CalPlug/SparkyStrip/documents/senior design/ems/Slides/average app rating.key/Data/st2.jpg

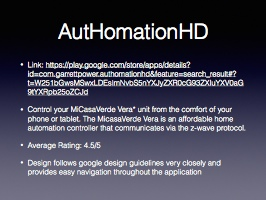
documents/senior design/ems/Slides/average app rating.key/Data/st2.jpg
