CalPlug/SparkyStrip/README.md

# SparkyStrip
**************************************
This is an EECS senior design for Electrical Engineering and Computer Science depatment at UC Irvine for 2015

Coding Development by: Jeffrey Thompson, Andrew Picard, David Pynes, and Edmund Loo

Managed by: Linyi Xia and Prof. G.P. Li

California Plug Load Research Center (CalPlug), California Institute of Telecommunications and Information Technology (Calit2), University of California, Irvine extending from a project in collaboration with The University of California, Davis.

Copyright (c) Regents of the University of California, 2015
