CalPlug/SparkyStrip/documents/pcb/PCB System Design.pptx

## PCB System Level Functional Design

Linyi Xia 7/10/2014

## Slide 2

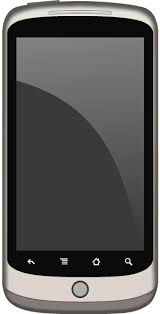
[picture p14: figure]
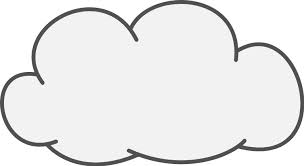
[picture p15: figure]

Cloud/Server/Gateway

PCB (Load Monitoring System)

## Slide 3

PCB (Load Monitoring System)
Measure (Micro and Macro transient response)
Communication with the cloud/server/gateway
Device ID
Load Signature Library Storing
Device matching
Characterizing Device Load Signature
ZigBee communication
WiFi and/or
Vrms
Irms
Power
Power factor
