CalPlug/SparkyStrip/documents/senior design/ems/load_sig/SURF PPT - Final.pptx

## Plug Load Signature Study for Home Energy Management

Kelvin Liang, Young Min Kim,
Johnny Nguyen
Advisor: Prof. G.P. Li, Dr. Arthur Zhang

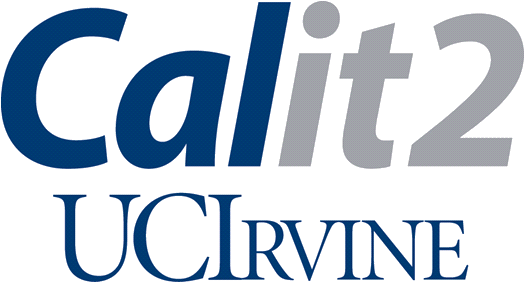
[picture p30: figure]

## What is an EMS?

- Central hub for monitoring plug load devices used in the house.
- Monitoring
  - Power Consumption
  - Cost
  - User behavior
- Opportunities for energy management
  - Two way communication

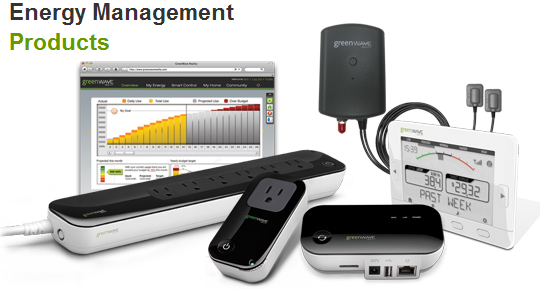
[picture p31: figure]

## Smarter Technology

- Current systems
  - Module for each plug load device
  - 100% User Interaction
- Load Signature allows for:
  - Automatic Identification
  - Using existing infrastructure (electrical panel, switch boxes, outlets)

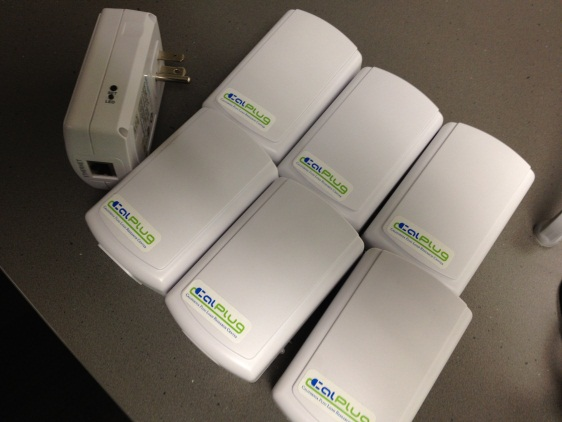
[picture p32: figure]

## Load Signatures

- Current Waveform
- Active & Reactive Power
- Harmonics
- Operating Behaviors

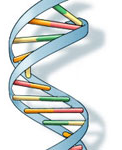
[picture p33: figure]

## Current Waveform

Signature I: Current Rise-Up Time

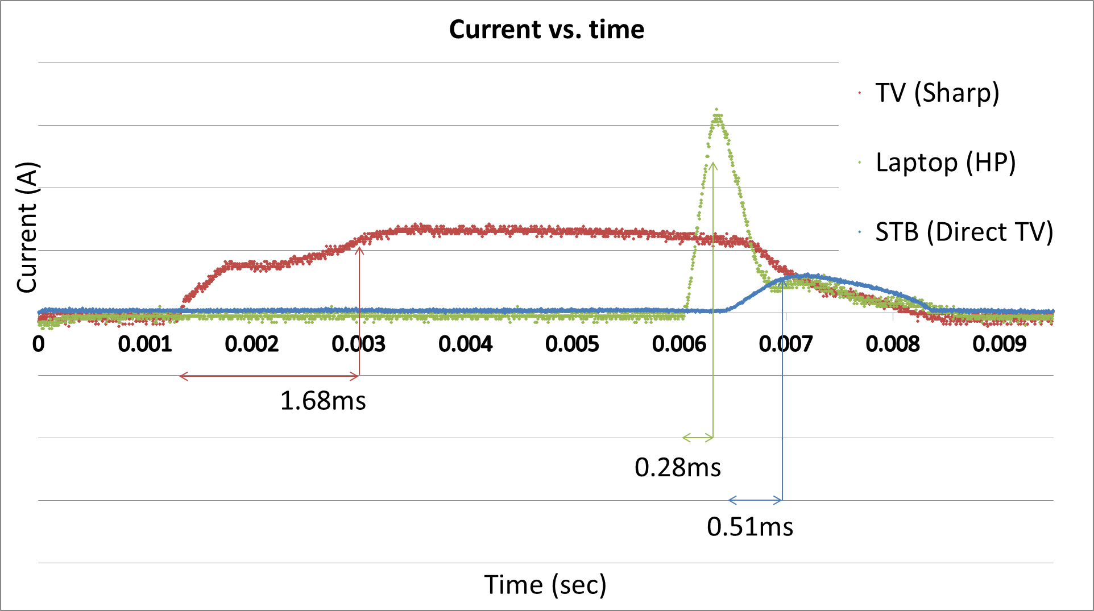
[picture p34: figure]
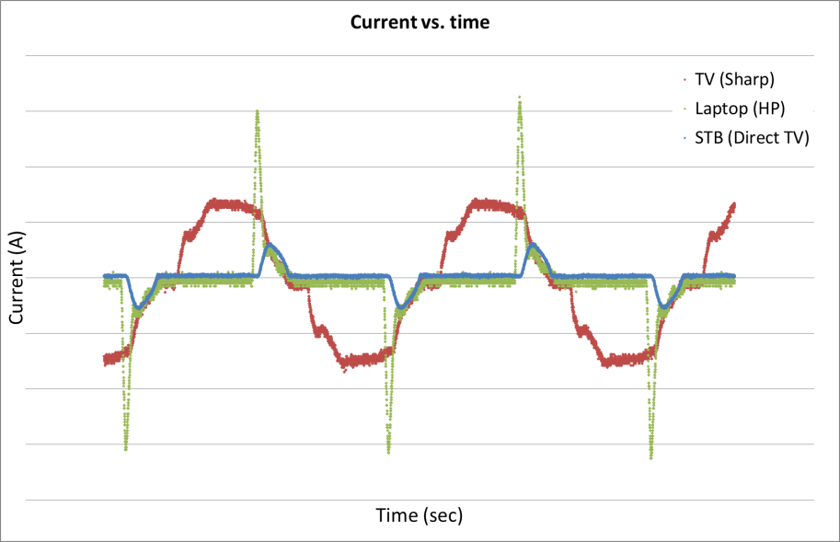
[picture p35: figure]

## Signature II: Harmonics

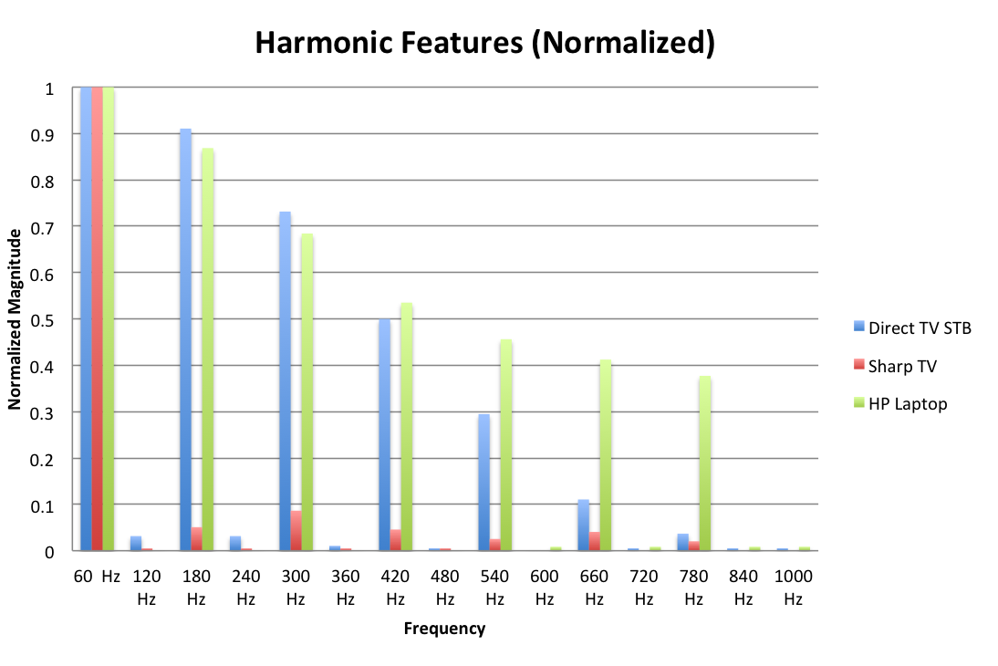
[picture p36: figure]
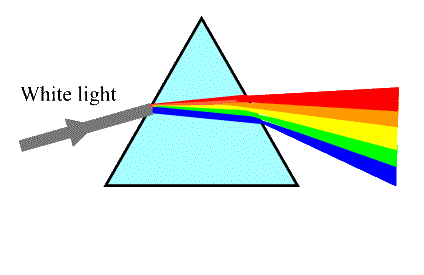
[picture p37: figure]

Prism Analogy

## Signature III: Active & Reactive Power

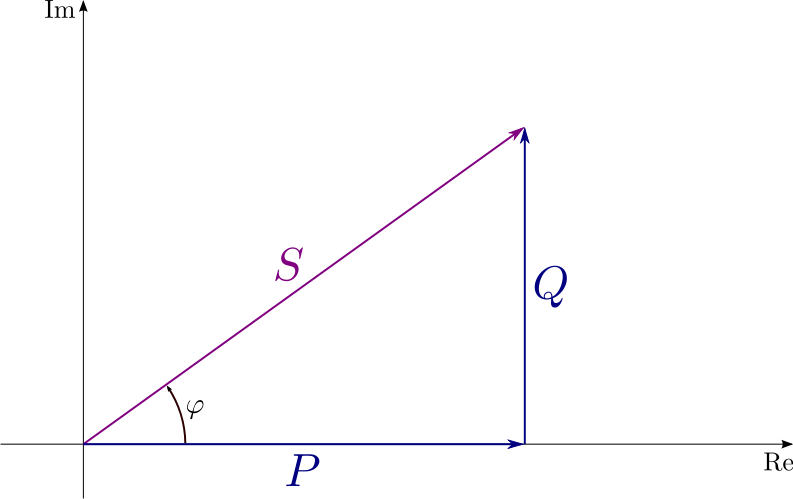
[picture p38: figure]
File:Cmplxpower.svg

Real power (P)
Reactive power (Q)
Complex power (S)
Phase of Current (φ)

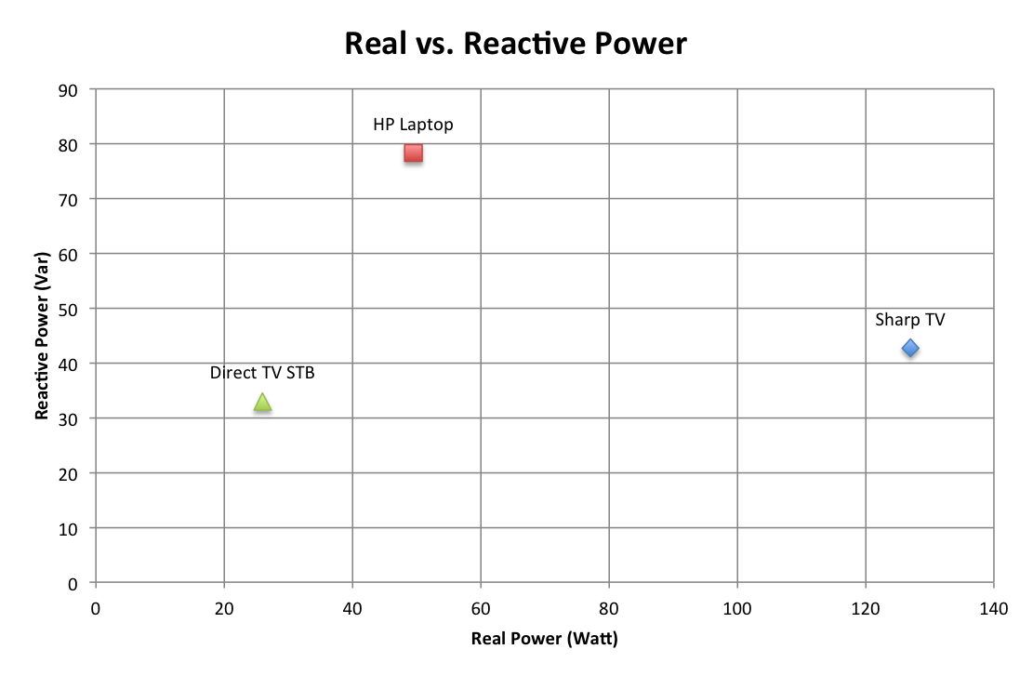
[picture p39: figure]

## Current Algorithm Design

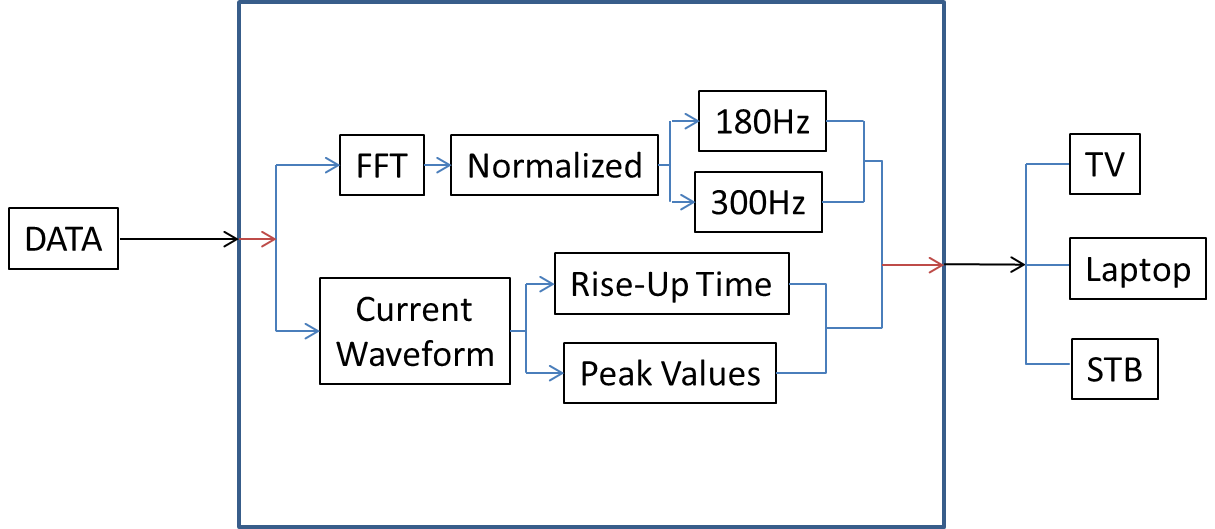
[picture p40: figure]

?

## System Integration

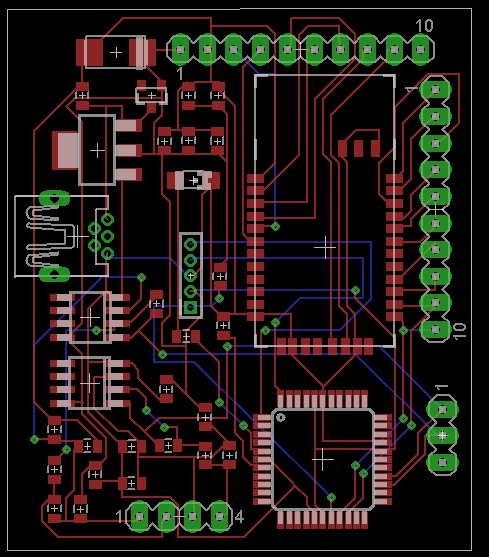
[picture p41: figure]
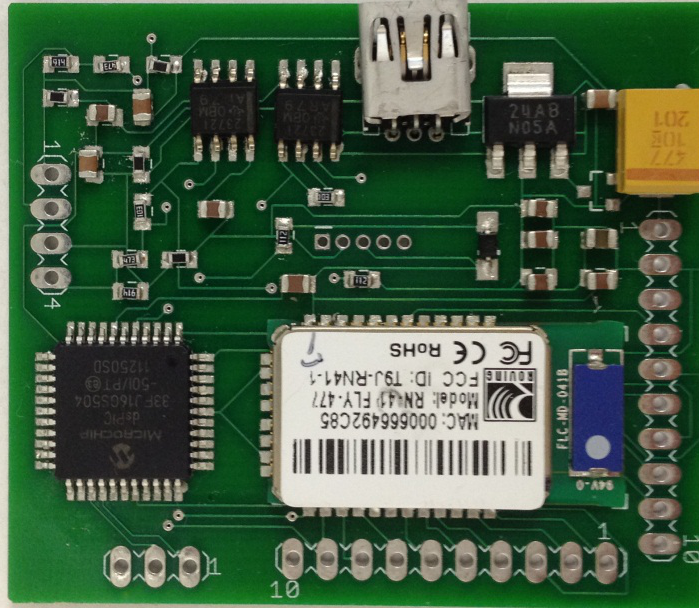
[picture p42: figure]
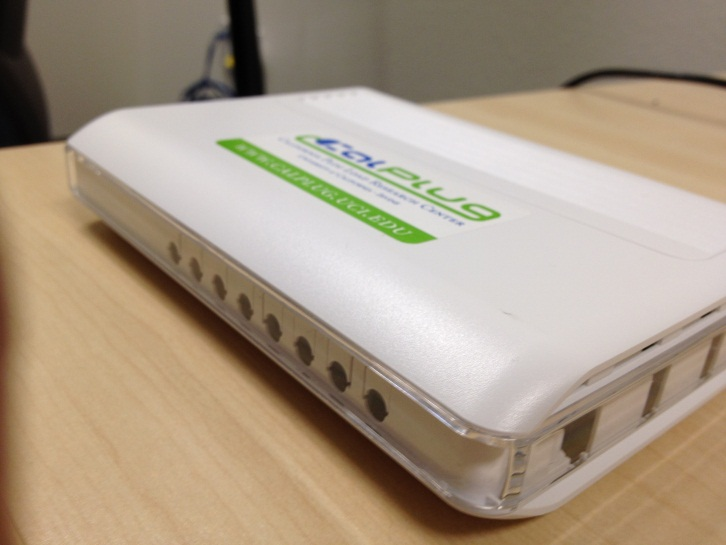
[picture p43: figure]

## Slide 10

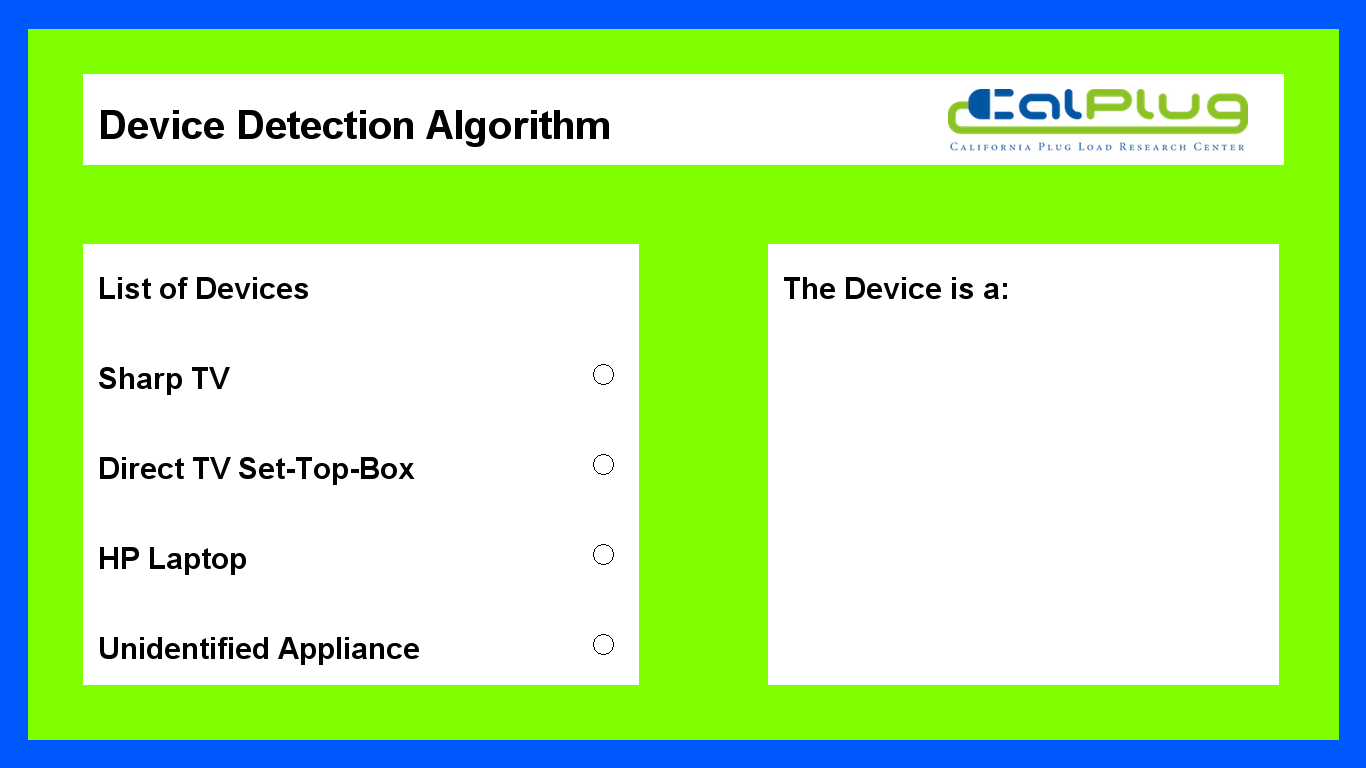
[picture p44: figure]
