CalPlug/SparkyStrip/documents/senior design/ems/Slides/Copy of Kelvin IHEI 12.30.13  Meeting.pptx

## GreenWave Reality Solutions

**Concept video Dated April 2011

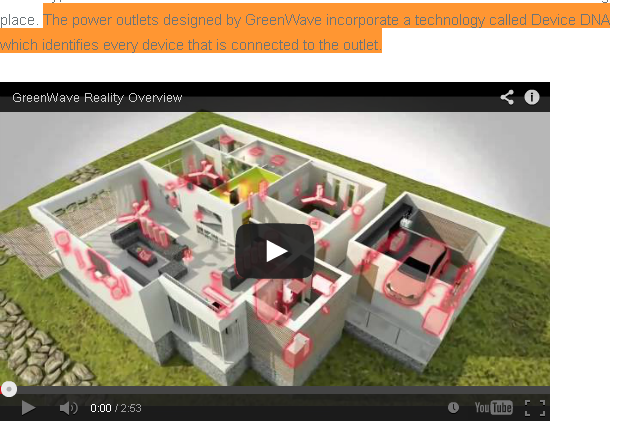
[picture p49: figure]

## Competitor Product

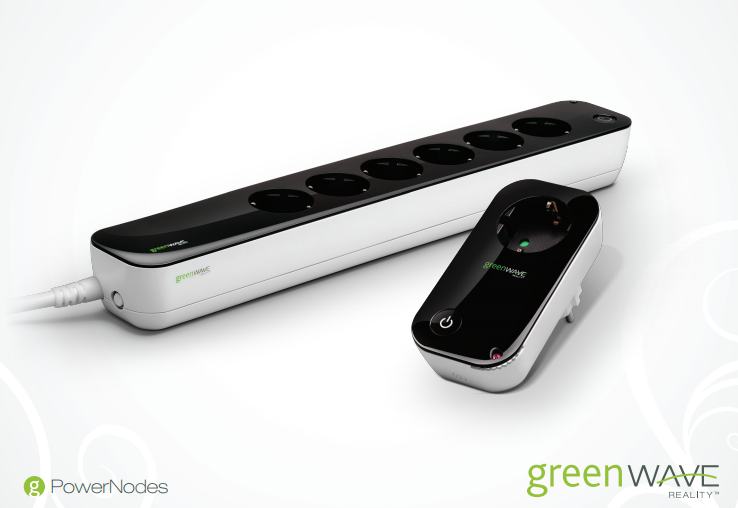
[picture p50: figure]

## Slide 3

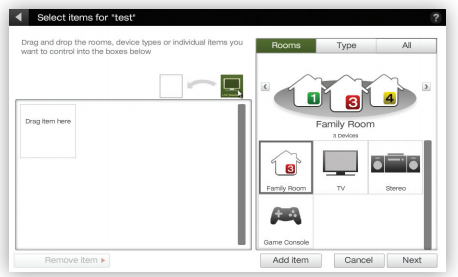
[picture p51: figure]

## GreenWave Selling Points

-Room Colors
Manual dials for assigning devices to a room
-Scheduling
-Energy Consumption
-LED Bulbs w/ NXP chip to drive intensity, relay
-Home Monitoring
-No Mention of “Device DNA”

## Whats Next

- Proceed with waveform recognition add on to ems
  - no clear competitor with this technology
- Arrival of PO?
  - Begin ASAP to meet deadlines

## Links

http://walyou.com/greenwave-energy-monitor/
http://greenwavereality.com/downloads/pdfs/PowerNode_manual_english.pdf
http://greenwavereality.com/downloads/pdfs/energy_portal_guide.pdf
http://greenwavereality.com/downloads/pdfs/KitInstallationGuideEnglish.pdf
http://greenwavereality.com/downloads/pdfs/gateway_manual_english.pdf
