CalPlug/SparkyStrip/documents/senior design/ems/Slides/Patents_cont.pptx

## Intelli-Home Electronics Interpreter (IHEI)

Young Min Kim
29 Dec. 2013

## Slide 2

- Common Load Recognition Features
  - Power
    - Real [Watt], Complex [VA]
    - Reactive [VAR], Apparent [|VA|]
    - Power factor [Real/Apparent]
  - Current, Voltage
    - Frequency, Period, Phase
    - RMS (root mean squared)
    - Harmonics, FFT

## Notable Patent Features

- Sony Corporation (2011) [1]
  - Measures electrical characteristics at the outlet
  - Compares the measured electrical characteristics to the stored characteristic of candidate device (database)
  - Unique electrical characteristics information stored in the database are
    - input reflection coefficient
    - line cycle frequency

## Notable Patent Features (cont.)

- Geneva Cleantech Inc. (2011) [2]
  - Automatic detection of appliances/devices
  - Methods/algorithms for identification disclosed
  - Unique features collected by monitoring devices coupled to a power supply:
    - Energy (active, reactive)
    - Total Harmonic Distortion (ratio of the sum of all harmonic components to the power of fundamental frequency)

## Notable Patent Features (cont.)

- Telecom Italia, S.P.A (2013) [3]
  - Home automation through automatic identification of device/appliance (*same focus)
  - Using cross-correlation method between the monitored electrical characteristic and a reference pattern of a possible candidate
  - Ex. If the calculated correlation between the monitored device and predicted reference is close to 0, then no relationship.

## Patent Links

- [1]http (http://www.google.com/patents/US20110196634):// (http://www.google.com/patents/US20110196634)www.google.com/patents/US20110196634
- [2]http (http://www.google.com/patents/WO2011091444A1?cl=en):// (http://www.google.com/patents/WO2011091444A1?cl=en)www.google.com/patents/WO2011091444A1?cl=en
- [3] http://www.google.com/patents/US20130132008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
