CalPlug/SparkyStrip/documents/senior design/load_sig/presentation/SURF UPDATE PPT.pptx

## Load Signature Study for Home Energy Management

Young Min Kim, Kelvin Liang
Advisor: Prof. G.P. Li, Dr. Arthur Zhang

## What is an EMS?

- Central hub for monitoring plug load devices used in the house.
- Monitoring
  - Power Consumption
  - Cost
  - User behavior
- Opportunities for energy management
  - On/Off relay control

## Smarter Technology

- Current systems
  - Modules for every plug load device
  - 100% User Interaction
- Load Signature allows for:
  - Automatic Identification
  - Using existing infrastructure (electrical panel)

## Load Signatures

- Current Waveform
- Active & Reactive Power
- Harmonics
- Operating Behaviors
- Instantaneous Power Waveform
- Instantaneous Admittance Waveform

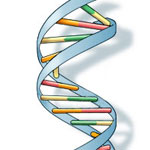
[picture p65: figure]

## Current Waveform


## Current Rise-Up Time


## Active & Reactive Power


## Harmonics


## Current Algorithm Design

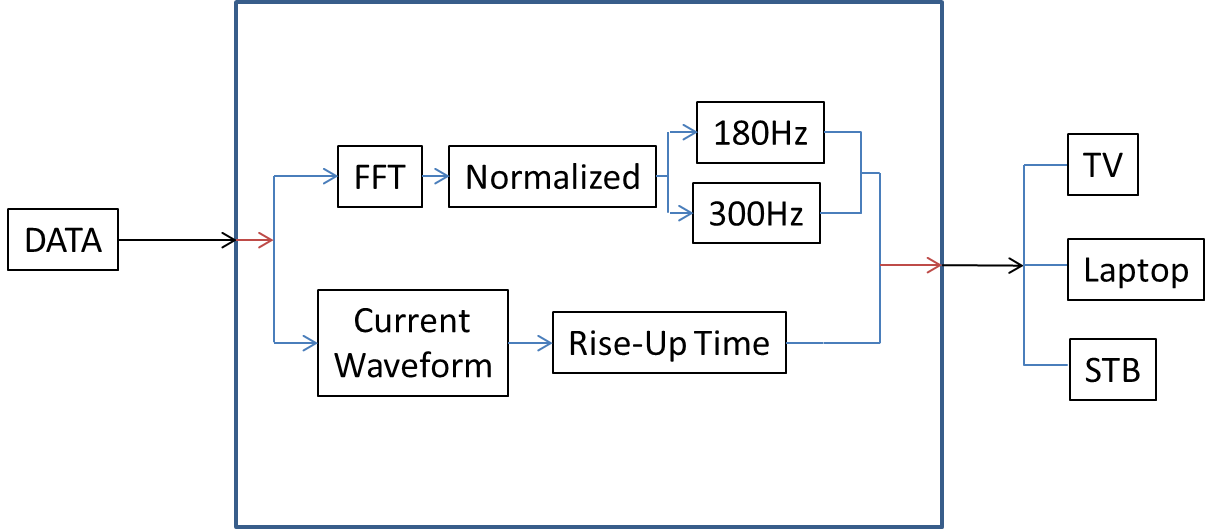
[picture p66: figure]

## Slide 10


## System Integration

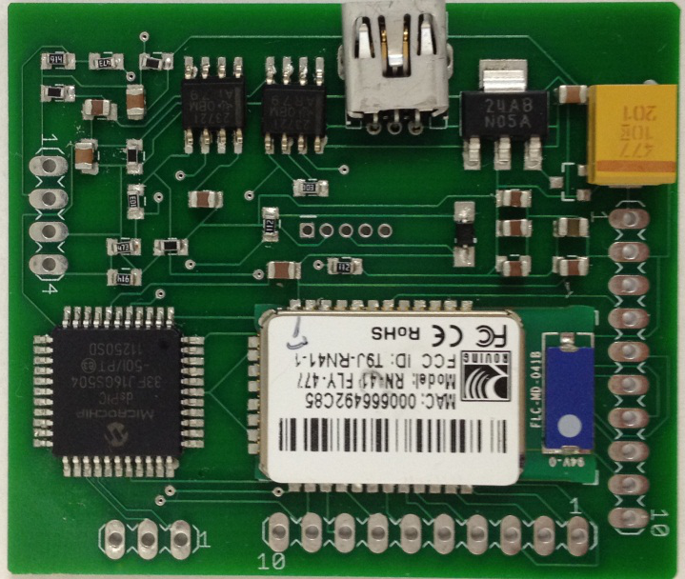
[picture p67: figure]
