CalPlug/SparkyStrip/documents/senior design/ems/load_sig/presentation/5.30.12 Presentation.odp

## CalPlug EMS

Shivam Patel

Progress Update

5/30/12

## Current Tasks

- Collecting waveforms for various loads
- Analyzing FFT and its uses
- Learning LabVIEW

## Current Probe Calibration

- Calibrated two new current probes

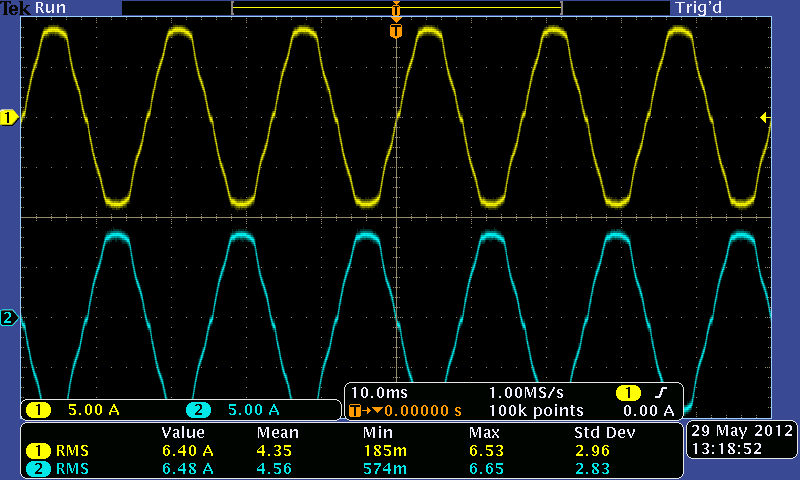
[picture p68: figure]

## FFT Page 1

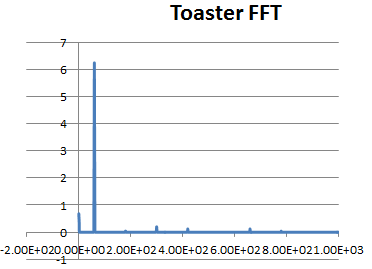
[picture p69: figure]
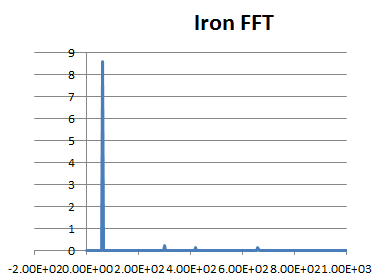
[picture p70: figure]

## FFT Page 2

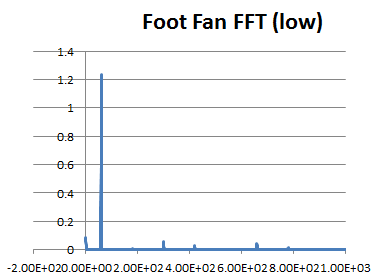
[picture p71: figure]
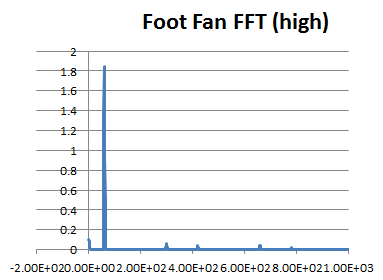
[picture p72: figure]

## What's Next

- Using LabVIEW to get full waveform over period of time
  - Want to analyze outside of instantaneous frame
  - Different modes for devices
