CalPlug/SparkyStrip/documents/senior design/ems/load_sig/presentation/6.13.12 Presentation.odp

## CalPlug EMS

Shivam Patel

Progress Update

6/13/12

## Current Tasks

- Inspect current probe
- Learn Lab View

## Current Probe Inspection

- Chip is only about 4 square inches

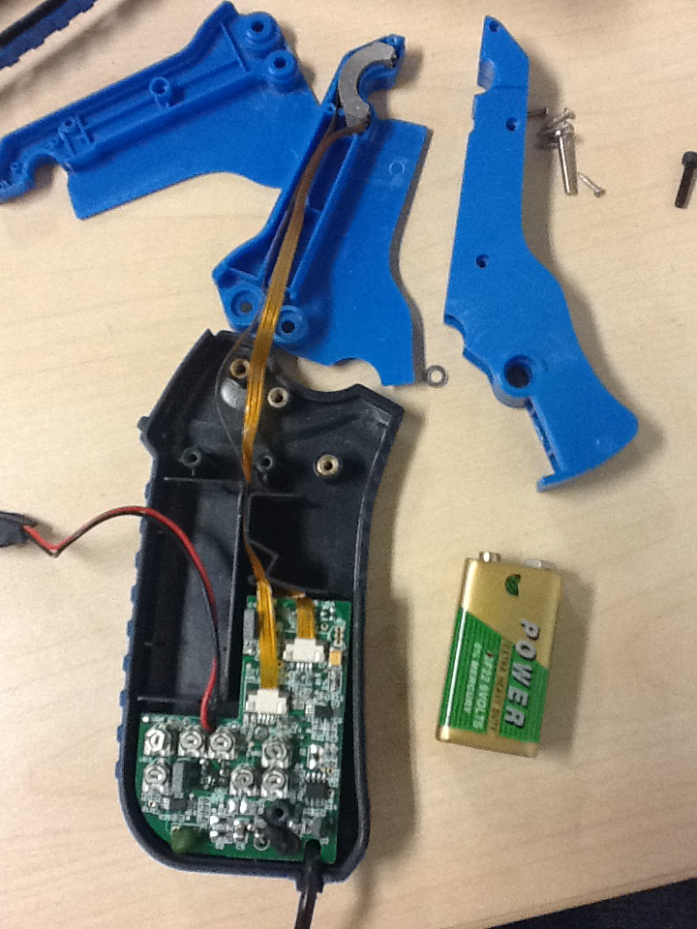
[picture p73: figure]

## Quarter Review

- Learned functions of current probes
- Practice with giving presentations and with soldering
- Contributed in some ares of the overall project
