CalPlug/SparkyStrip/documents/senior design/load_sig/presentation/10-26-2012/Camilo Presentation 1.pptx

## Presentation

Camilo Aguilar

## Eagle

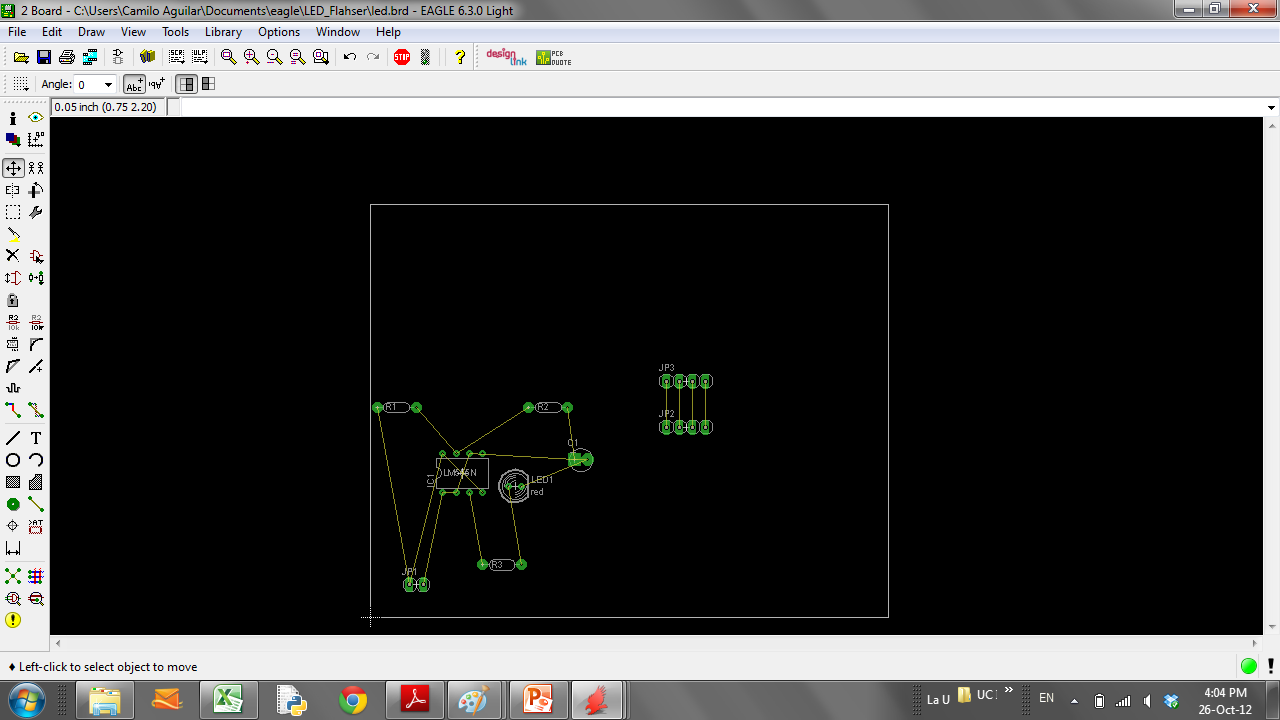
[picture p79: figure]

## Slide 3

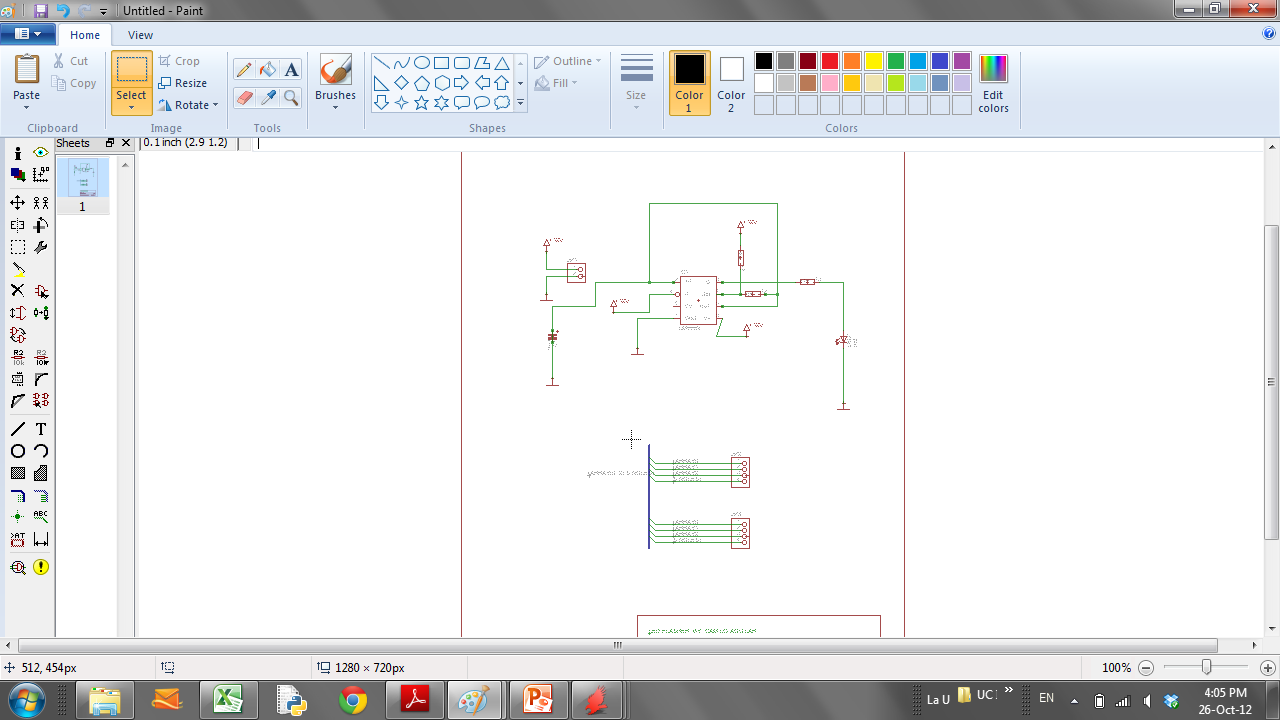
[picture p80: figure]

## Slide 4

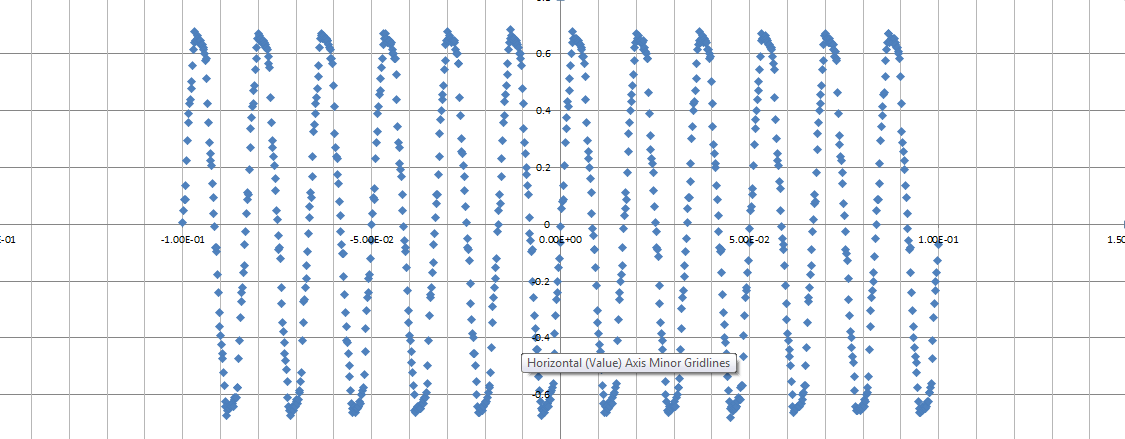
[picture p81: figure]
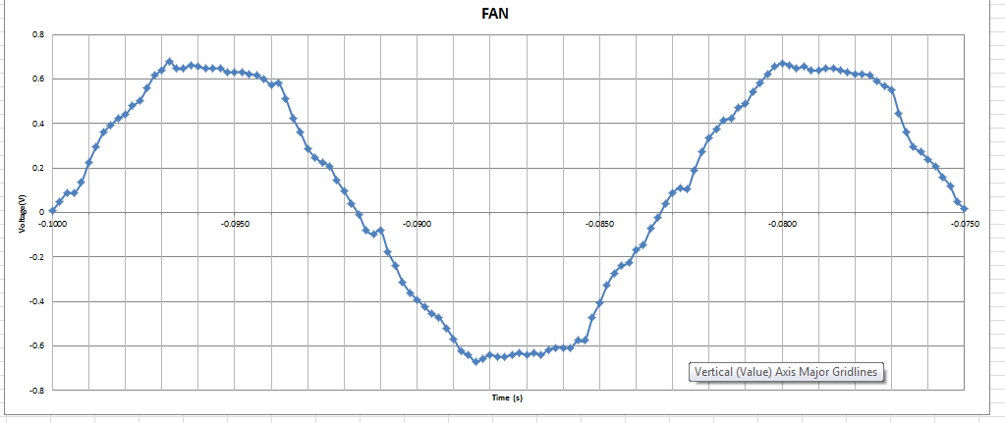
[picture p82: figure]

## Slide 5

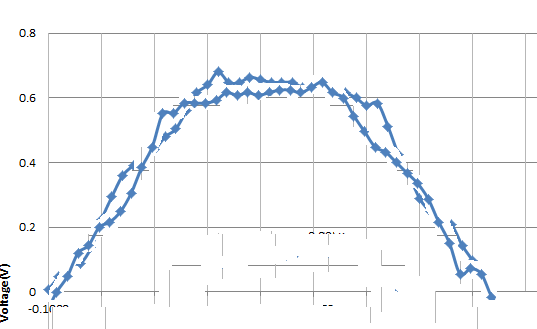
[picture p83: figure]

## Goals

- Better Understanding of Fourier Decomposition
- Help developing the code in C
- Work and get familiarized with eagle CAD
