CalPlug/SparkyStrip/documents/senior design/load_sig/presentation/12-07-2012/Johnny Nguyen 12-07-2012.pptx

## EMS Team Meeting


Johnny Nguyen
Binjue Wu
Camilo Aguilar
Mohsin Farooqui
Andrew Wang

December 7, 2012

## Milestones

- Able to recognize both individual devices, stored in database, and multiple, same devices (ie if there are two footfans fans, identifies there are two fans).
- Used Zigbee board to convert input using the ADC, and compute different load signature characteristics using buffers.

## Hardware/Zigbee CC2530

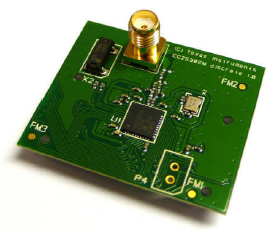
[picture p88: figure]

Johnny Nguyen
Camilo Aguilar
Christian Goldau

## Progress-What we learned

- Documentation for board difficult
- Invaluable microcontroller experience for Camilo and I
- Using different libraries of controller and C
- Learned limitations of controller vs computer C code

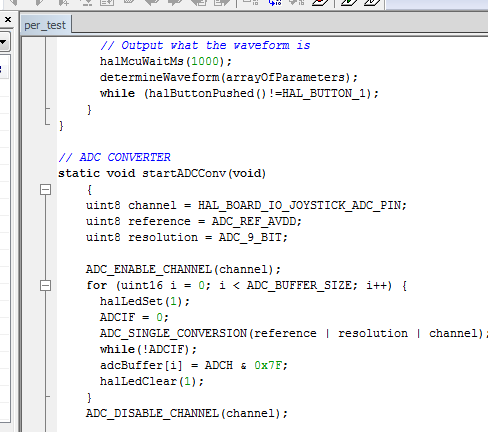
[picture p89: figure]

## Progress-Results

- ADC-Converter-Input
- Distinguish devices at microcontroller level.
- Demo

## Upcoming tasks

- Hardware to replace current probe
- Better Resolution in ADC
- Prepare design for Charles

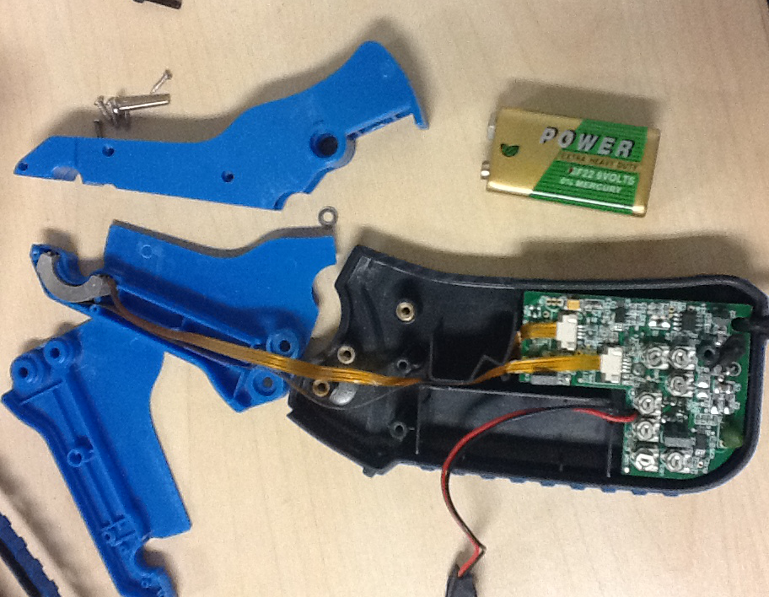
[picture p90: figure]
