CalPlug/SparkyStrip/documents/senior design/load_sig/presentation/2-15-2013/Different Phases of a Sine Wave.docx

Sin wave, frequency 60 Hz.

Phase Shift = 0

WaveForm:

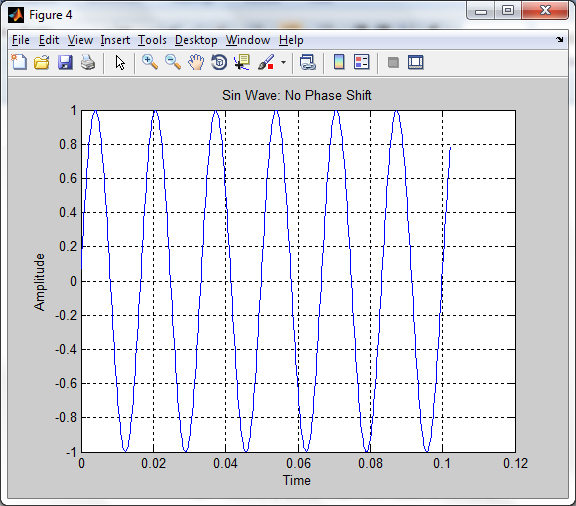
[picture p91: figure]

Normalized FFT

\

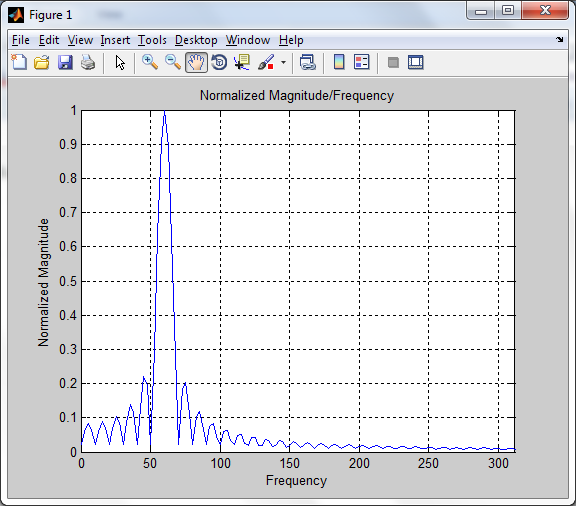
[picture p92: figure]

Real Frequency

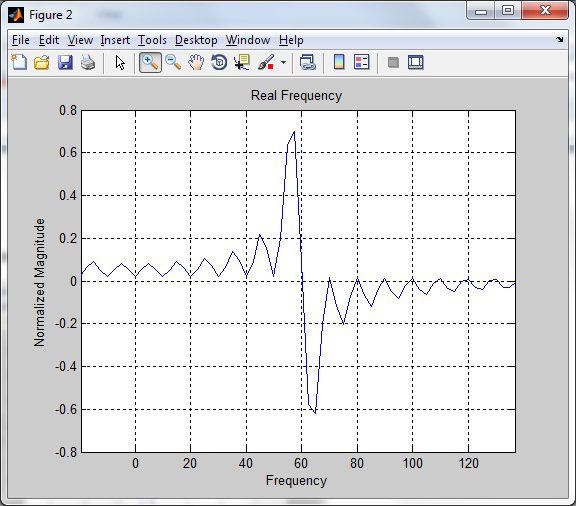
[picture p93: figure]

Imaginary

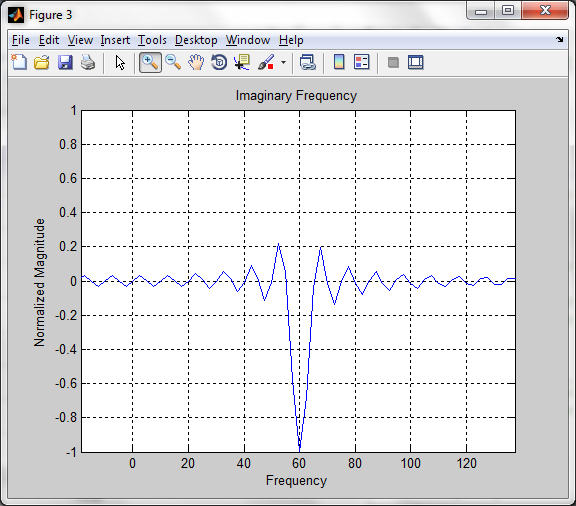
[picture p94: figure]

Sin wave, frequency 60 Hz.

Phase Shift = 180

Waveform

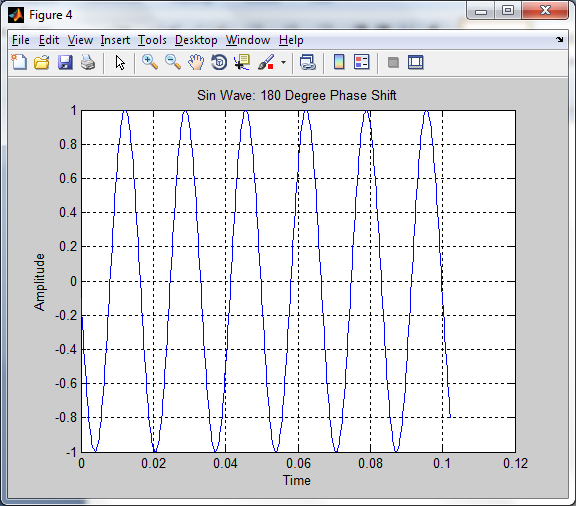
[picture p95: figure]

Normalized FFT

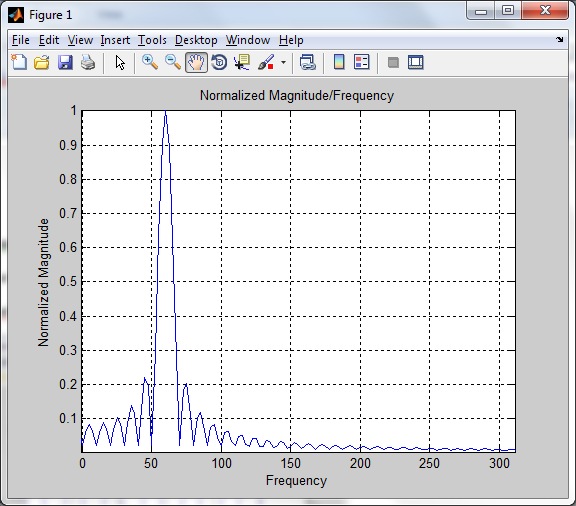
[picture p96: figure]

Real FFT

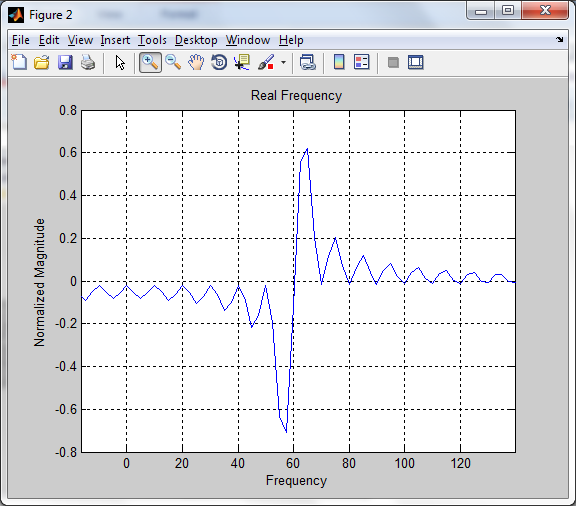
[picture p97: figure]

Imaginary FFT

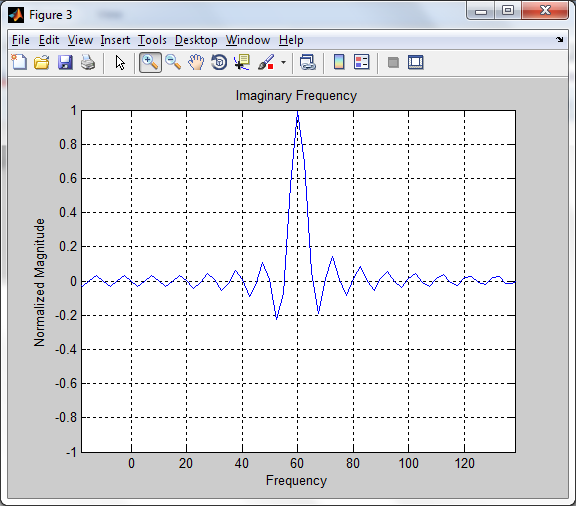
[picture p98: figure]

Sin wave, frequency 60 Hz.

Phase Shift = 90

Waveform

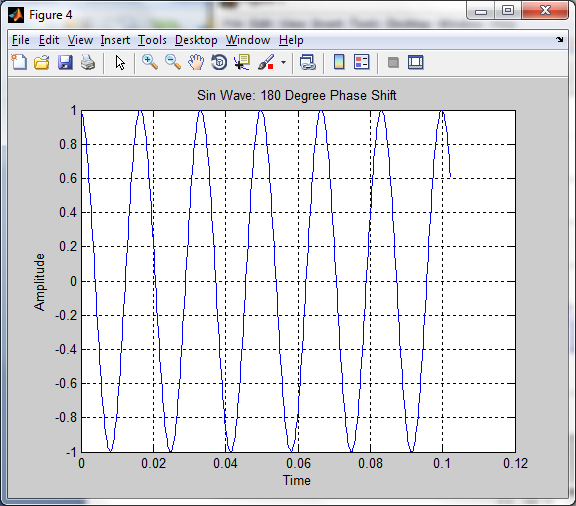
[picture p99: figure]

Normalized Frequency

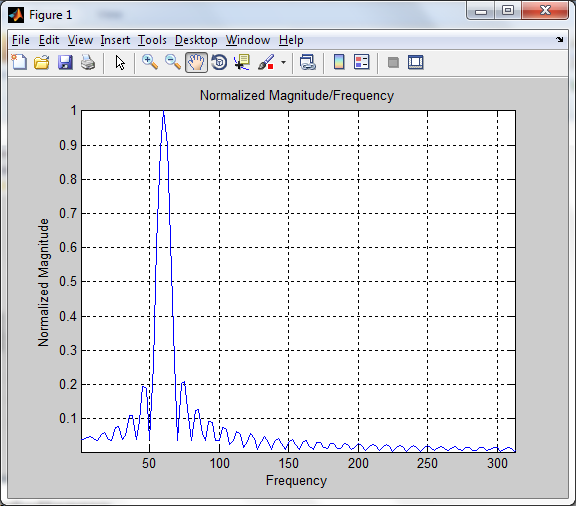
[picture p100: figure]

Real FFT

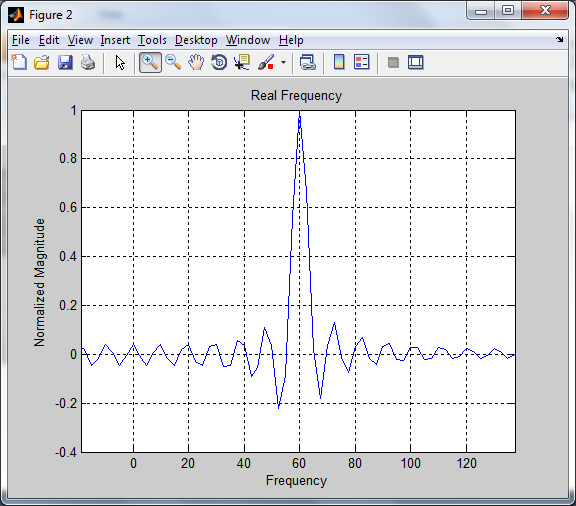
[picture p101: figure]

Imaginary FFT

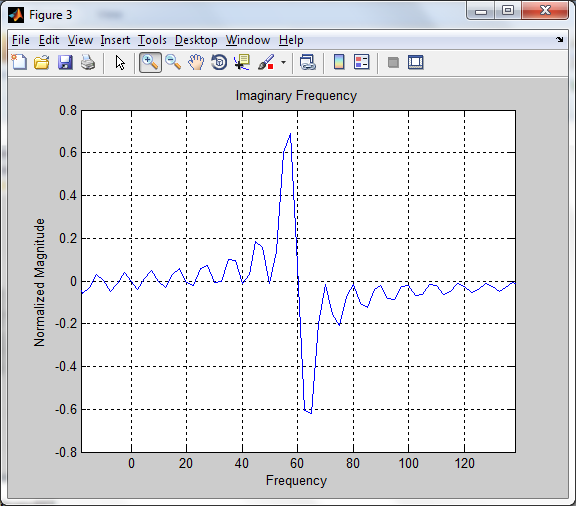
[picture p102: figure]

Sin wave, frequency 60 Hz.

Phase Shift = 270

Waveform

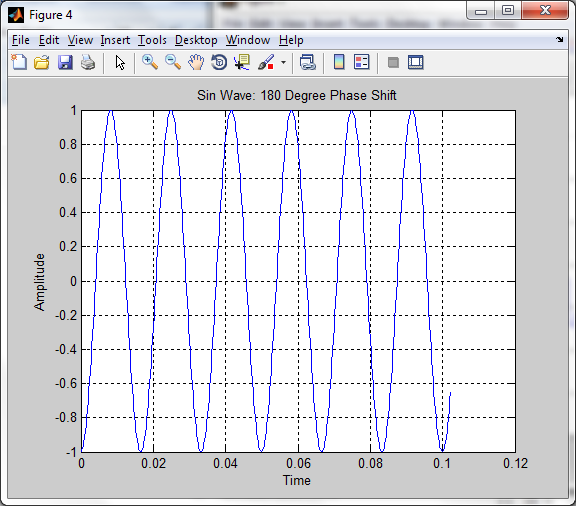
[picture p103: figure]

Normalized FFT

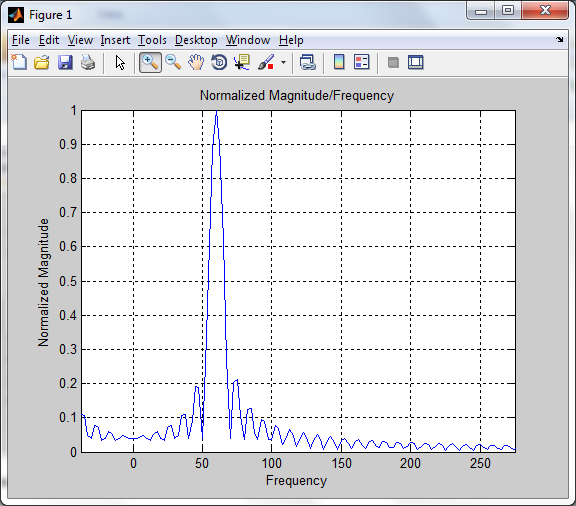
[picture p104: figure]

Real FFT

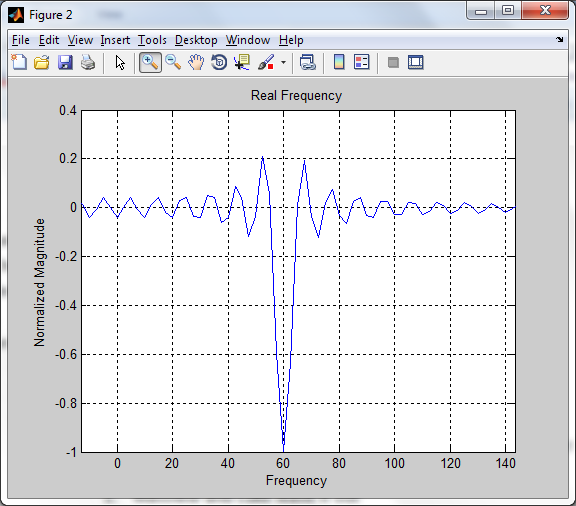
[picture p105: figure]

Imaginary FFT

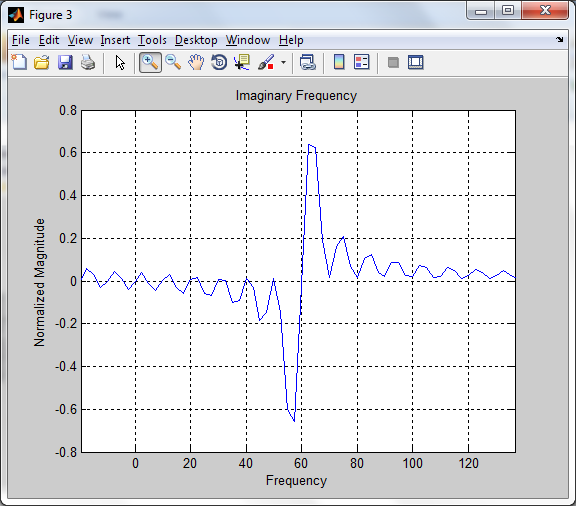
[picture p106: figure]

Why?

Fourier Transform:

When we shift, Normalized values are the same ( √(Re{S(F)}^2+ Im{S(F)}^2) )

However, Real and Imaginary Components are different!!

When we shift by 90, we multiply S(F) by ‘j’

s(t + π/2) = j*S(F)

When we shift by 180, we multiply S(F) by ‘-1’

s(t + π) = -1*S(F)

When we shift by 270, we multiply S(F) by ‘-j’

s(t + 3π/2) = -j*S(F)

Our data is consistent when we shift our values by 360 degrees

Excel File

However, our phase sometimes changed “signs”. This is due to the fact that sometimes, the real or imaginary component of FFT is close to 0, and fluctuated signs. We find that Real and Imaginary FFT is more reliable.

Thus, when we find phase, it is important when we record the waveform, to always start on the same starting point. In our case, we wish to always start recording at the local maximums

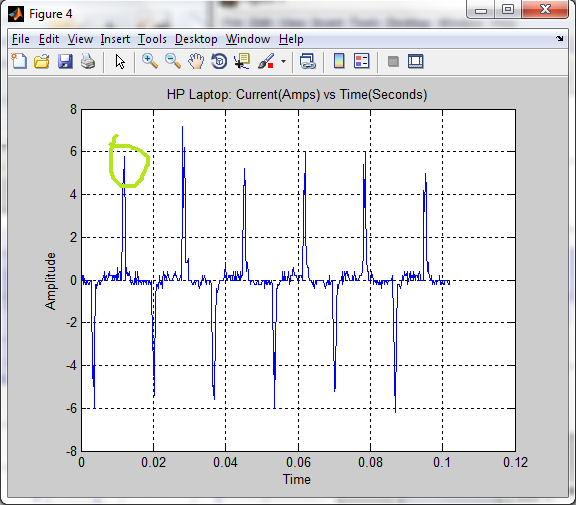
[picture p107: figure]
