CalPlug/SparkyStrip/documents/senior design/load_sig/presentation/2-15-2013/EMS Team Meeting Progress Report.pptx

## EMS Team Meeting


Johnny Nguyen
Camilo Aguilar
Christian Goldau
Andrew Wang

February 15, 2013

## Milestones-Last Quarter

- Able to recognize both individual devices, stored in database, and multiple, same devices (ie if there are two footfans fans, identifies there are two fans).
- Used ADC, and compute different load signature characteristics on board

## Real-Time Display

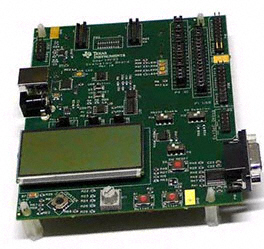
[picture p108: figure]
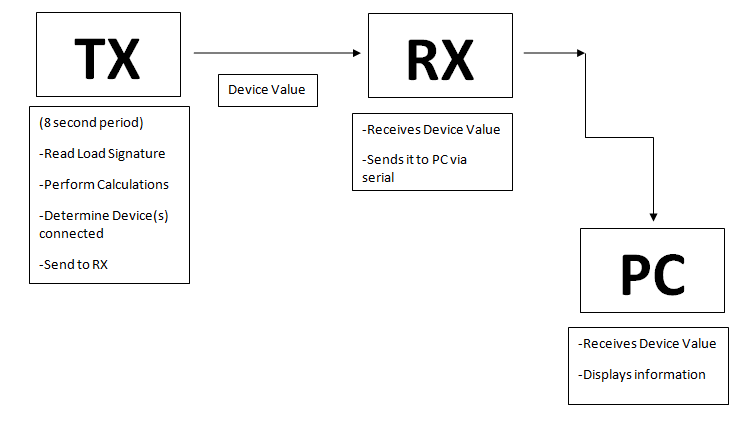
[picture p109: figure]
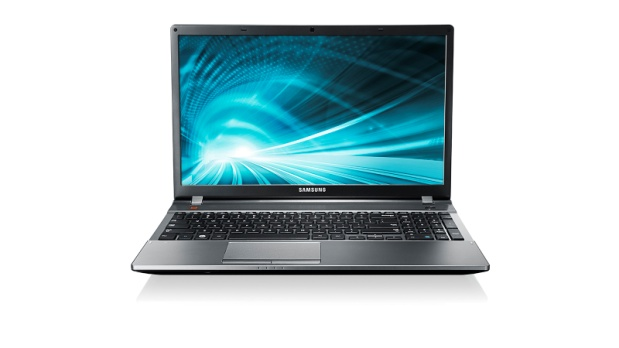
[picture p110: figure]

## Load-Signature Algorithm: Real and Imaginary Frequency Harmonics

- Problem: two sine waves, one with 180 degree shift, yielded different Phase, Real and Imaginary FFT
No Phase Shift 180 Degree Shift


## Slide 5

- Problem Solved: Read waveform, store it into buffer, and set starting point to maximum at first period
- Calculations consistent
  - However, sometimes phase was opposite signs
  - Thus we will use Real and Imaginary
