CalPlug/SparkyStrip/documents/senior design/load_sig/presentation/4-16-2013/EMS Team Meeting Progress Report 4-16-13.pptx

## EMS Team Meeting


Johnny Nguyen
Camilo Aguilar
Christian Goldau
Charles Lam

April 16, 2013

## Milestones-Last Quarter

- Real time, wireless display.
  - Able to display 2 meters (but with interference problems).
- Improving the code
  - More devices, more waveform features
- Practiced Demo/Presentation Skills

## Current Progress/Problems

- Trouble with wireless
  - Demo/Demo code not working
- Currently 11 waveform features in code
  - To be used in Chris’s code and microcontrollers

## Future Tasks

- Continue to debug demo code
- Multiple meter wireless network
- Assist/Train up new members
