CalPlug/SparkyStrip/documents/senior design/load_sig/presentation/6-03-2013/Active and Reactive Power.pptx

## Active and Reactive Power

Load

## Voltage Current

Load

## Current Voltage Meassurements

- Real Power Consumption (WATTS)
- Reactive Power (VAR)
  - Phase Shift
    - Capacitor/Resistive/Inductive Circuit
    - Phase add linearly

## Slide 4

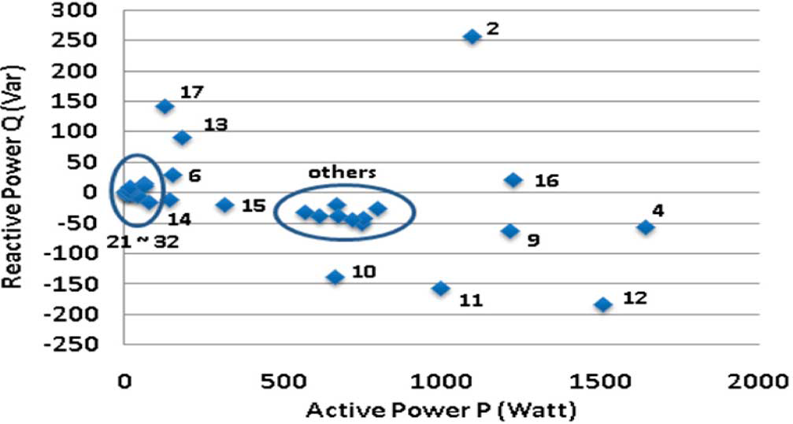
[picture p111: figure]
