CalPlug/SparkyStrip/documents/senior design/load_sig/presentation/6-03-2013/EMS Team Meeting Progress Report 6-3-13.pptx

## EMS Team Meeting


Johnny Nguyen
Camilo Aguilar
Upa Sundaram
Charles Lam

June 3, 2013

## Problem: Recognizing Similar types of Devices

- Waveforms of laptops in steady state similar:
  - Becomes even more complicated with different power consumption modes, whether or not the laptop is fully charged, etc.

## Slide 3

Dell Laptop

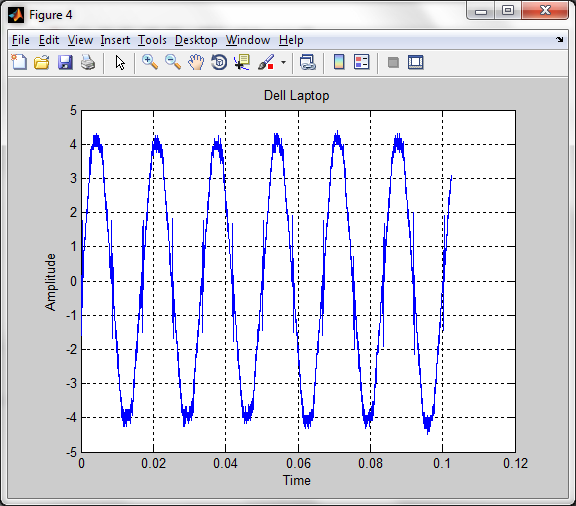
[picture p112: figure]

Lenovo

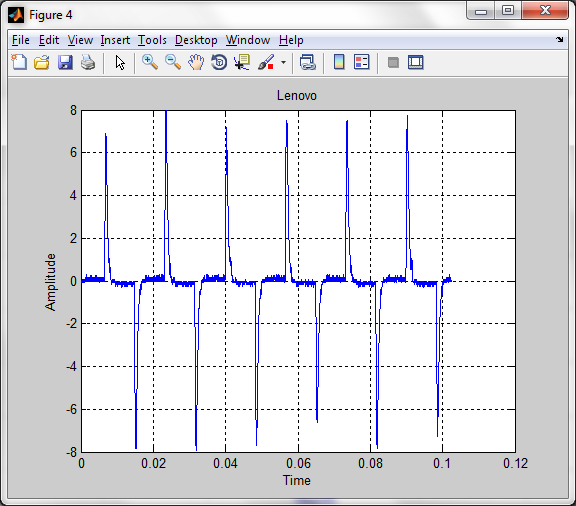
[picture p113: figure]

HP Probook 4530s

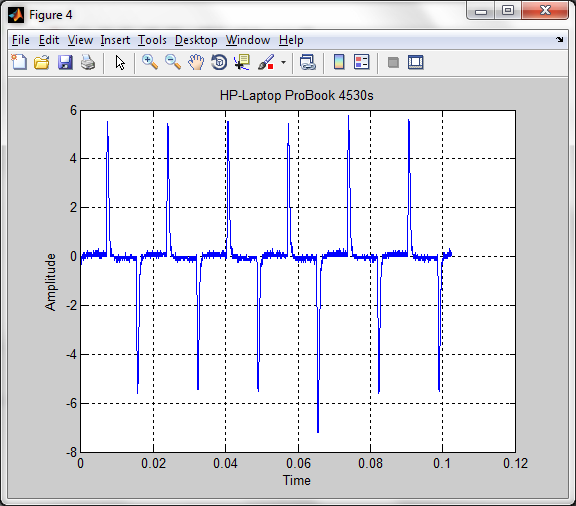
[picture p114: figure]

Dell PC

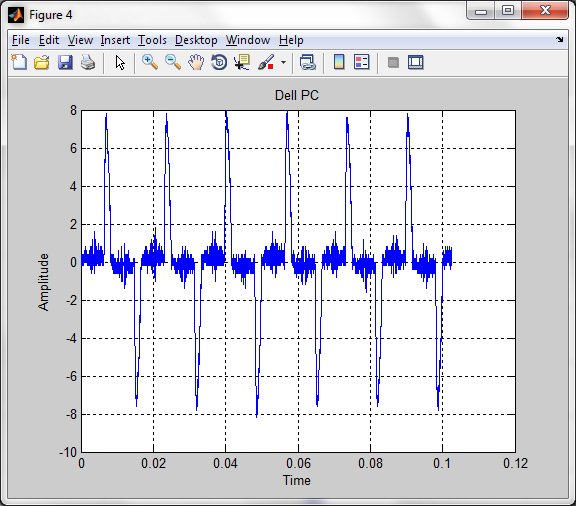
[picture p115: figure]

HP Pavilion dm4

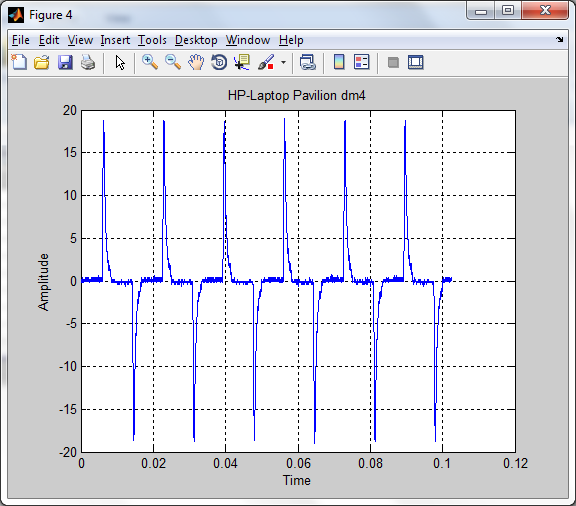
[picture p116: figure]

## Harmonics of Different Computers

Lenovo

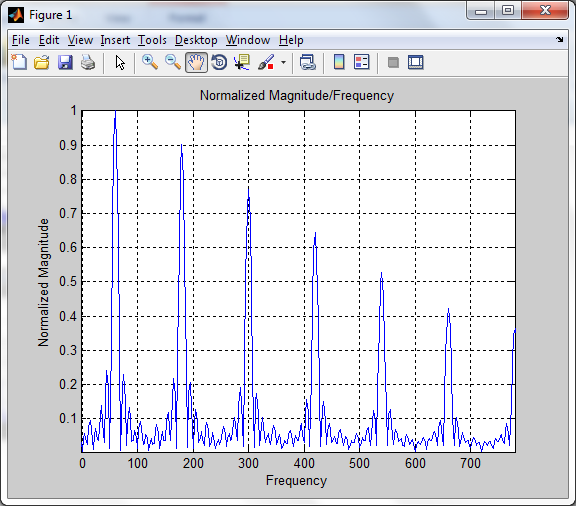
[picture p117: figure]

HP Probook 4530s

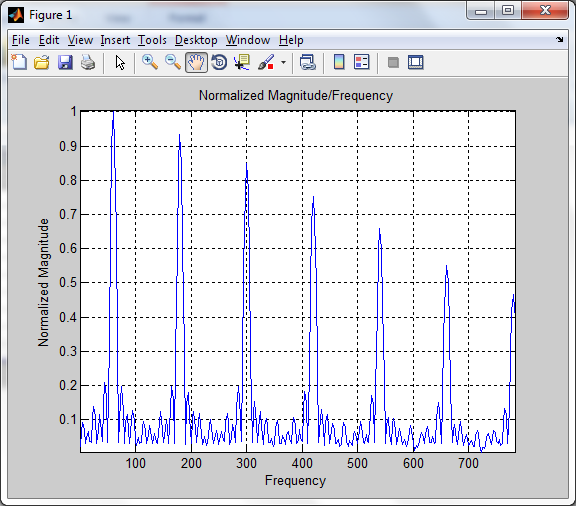
[picture p118: figure]

HP Pavilion dm4

Dell PC

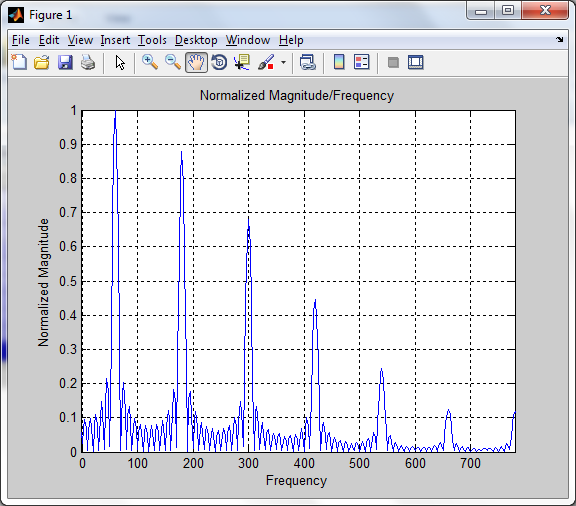
[picture p119: figure]
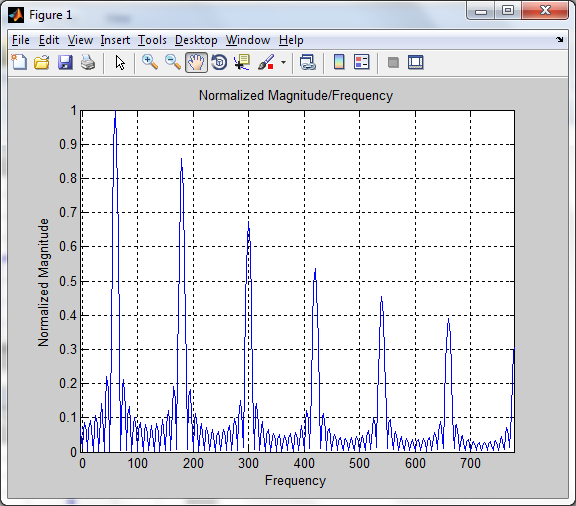
[picture p120: figure]

## Resonant Harmonics

Lenovo

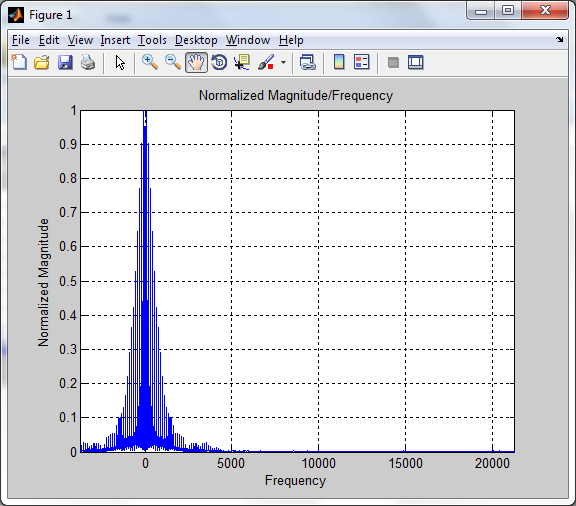
[picture p121: figure]

HP Probook 4530s

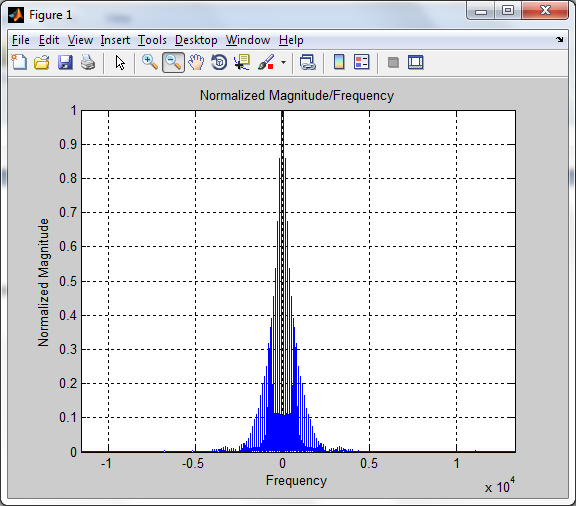
[picture p122: figure]

HP Pavilion dm4

Dell PC

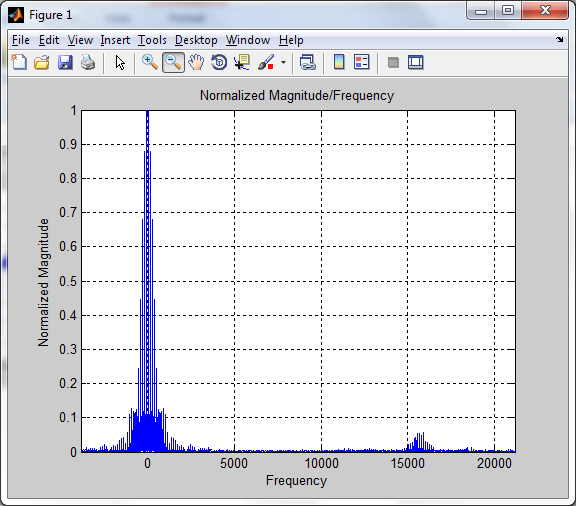
[picture p123: figure]
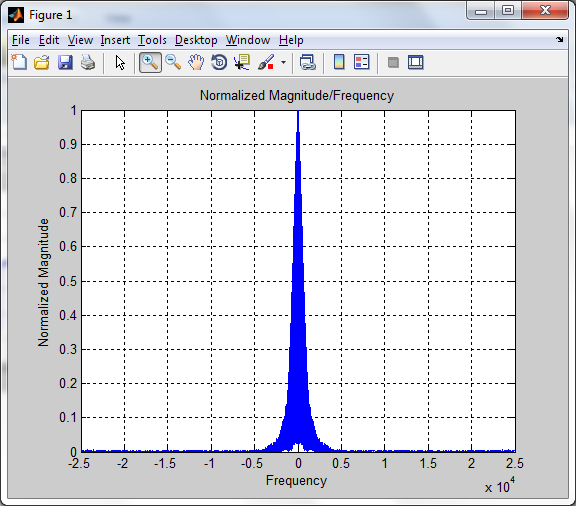
[picture p124: figure]

## Resonant Harmonics

Lenovo

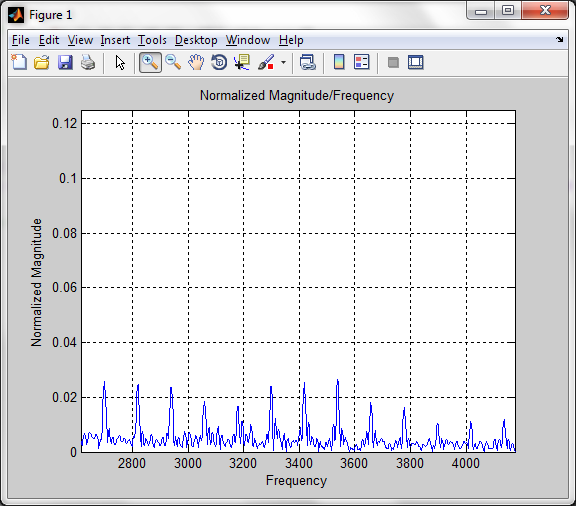
[picture p125: figure]

Dell PC

HP Probook 4530s

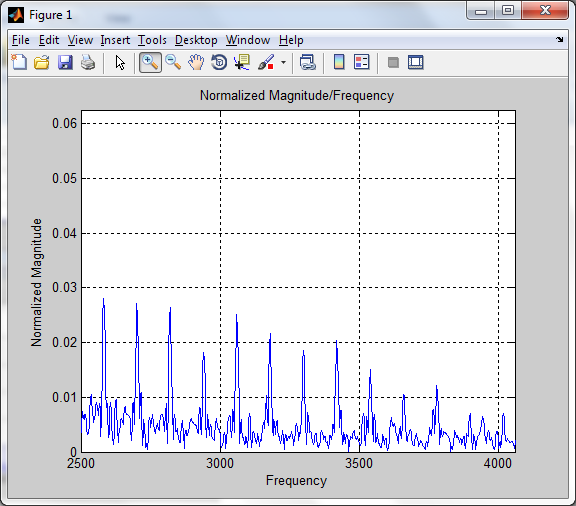
[picture p126: figure]

HP Pavilion dm4

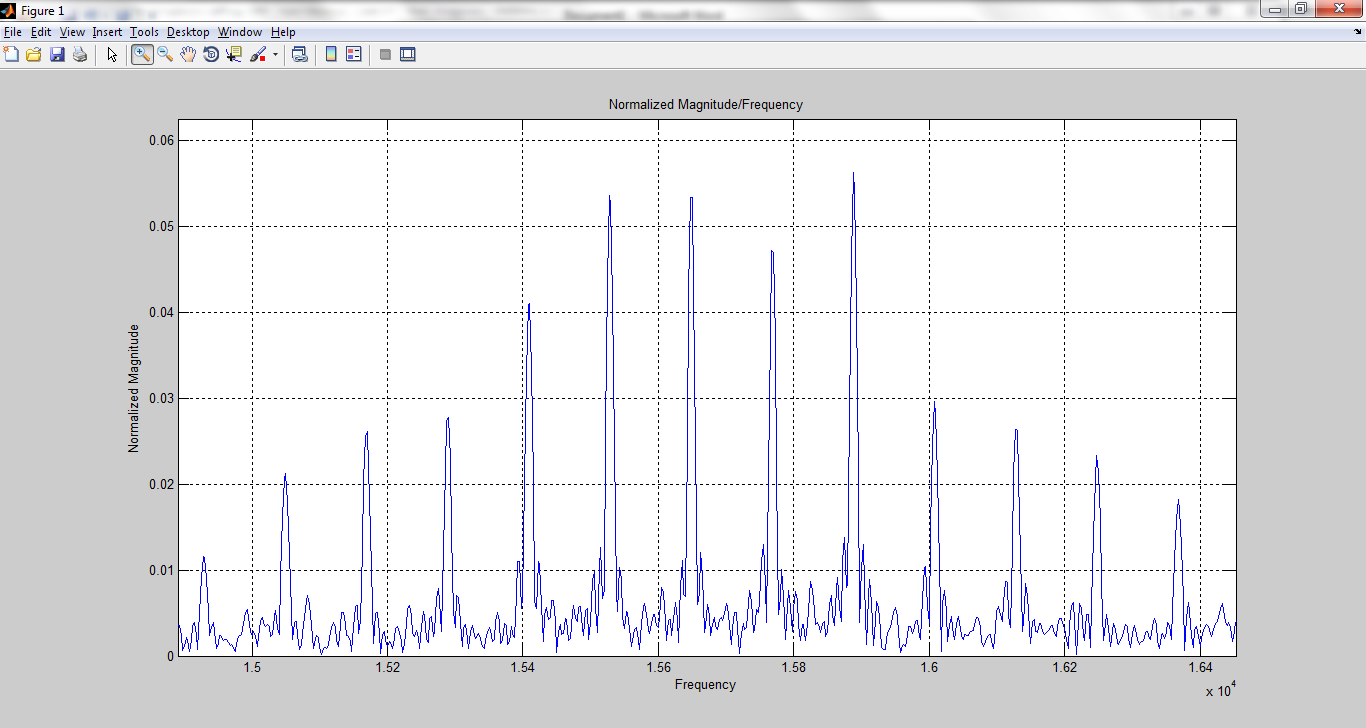
[picture p127: figure]
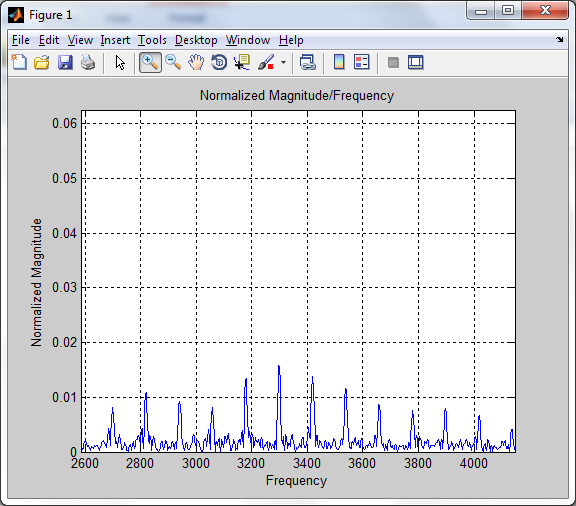
[picture p128: figure]
