CalPlug/SparkyStrip/documents/senior design/load_sig/presentation/6-03-2013/upaspresEMS6-3.pptx

## Team Energy Management Systems Presentation

By: Upamanyu Sundaram

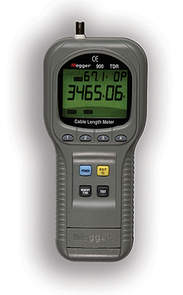
[picture p129: figure]

## Research into Time Domain Reflectometers

- A time-domain reflectometer (TDR) is an electronic instrument used to locate faults in metallic cables (for example, twisted wire pairs).
- It can help you determine IF you have a cable problem, not what the problem is.
- Its use in Calplug, specifically my research into voltage decibel decay, would be limited, most TDRs work by way of sending a pulse through the cable, and as the pulse reaches its destination, it sends an echo back which is analyzed to show location of fault

## Time Domain Reflectometers – Voltage Decibel Decay

- The use I would have for a TDR is for measuring the echo pulse that is emitted back to determine the damped voltage
- Using these measurements and the formula DB = 20log(V_output/V_input) we would be able to calculate the decay in decibels over a distance
- Megger TDR900 Hand Held Time Domain Reflectometer and Cable Length Meter – This is the device Team EMS is thinking about purchasing, it will allow us to measure cable length by sending a pulse and measuring the echo; it is pricey, $350
- I would use this device for measuring decibel decay, however, that is about it for now. It could potentially be used in the future for finding faults in wiring over long distances and such, but is the cost worth the benefits?

## Voltage Decibel Decay

- I also looked into voltage decibel decay and its relationship with the distance of the device from its power source.
- By finding the decay over a certain distance for multiple devices and graphing the results, I would attempt to find a general connection between the distance and the output voltage, given the base voltage of the device.
- Using this we would be able to determine the distance of a device from its power source, whose base voltage is given, over a certain length of wire.

## Voltage Decibel Decay – Fan experiment

- To measure voltage decay over a distance we tested the voltage output from the foot fan over certain distances
  - Problem: certain power strips consumed current making reading inaccurate, this would lead to future problems because usually power strips do consume some current so we would have to find a way to account for it
  - Temporary Solution: we used power cords with no switches or LEDs so current consumption was limited to the fan as much as possible

## Fan Experiment - continued

- With one fan, these were our findings

Voltage

x10 With 1 fan
0 ft | 20.8
12 ft | 20.8
24 ft | 20.7
36 ft | 20.6
48 ft | 20.6
60 ft | 20.5
72 ft | 20.5
84 ft | 20.4
96 ft | 20.3

Distance in ft

## Fan Exp. Cont.

Distance in ft

This is the Graph of the decibel decay of one fan over 96 ft

Measured decibels with a 0 base

## Fan Exp. Cont.

- Next we did the experiment with three fans in order to receive more precise data–our results

12 ft | 59.1
24 ft | 58.7
36 ft | 58.4
48 ft | 57.8
60 ft | 57.3
72 ft | 56.95
84 ft | 56.5
96 ft | 56.2

Distance in ft

Voltage

Results more linear

## Fan Exp. Cont.

Distance in ft

Measured decibels with a 0 base – using 12ft as base

## Findings and future actions

- The results seem to be linear, so as of now I am assuming there is somewhat of a linear correlation between voltage decibel decay and distance for an appliance
  - Not sure until more devices are tested
- Future actions include testing more devices to maybe show a more significant correlation
- Using the date, create a general equation of some sort based off of the decibel decay detected in the voltage of a device in order to determine its distance away from power source
