CalPlug/SparkyStrip/documents/senior design/ems/load_sig/presentation/11-09-2012/Camilo Aguilar.pptx

## Presentation 1

Camilo Aguilar

## Slide 2

- Short Term Goals:
  1. Understand Load Signatures.
  2. Signal decomposing and processing.
  3. Understanding hardware implementation and troubleshooting

Hardware

Load Signatures


Source: Surf PPT Presentation


## Load Signature

- Electrical behavior
- Understand and analyze:
  - Control devices
  - Energy Management


## Variables Load Signatures

- Voltage (V)
- Current (i)
- Power (P)

## 1 appliance vs n appliances

## Principle Superposition = Composite Load

## Composite Load

  - Unique features from appliances are mixed
  - Certain features may be masked or lost. Decompose signals:
    - Snapshot Form: Instantaneous snapshot of the load behavior taken at a fixed time intervals.
    - Delta Form: Difference between two consecutive snapshots form signatures.

## Criteria to Classify Composite waveforms

    - Current waveform
    - Active and reactive power
    - Harmonics
    - Instantaneous Admittance Waveform
    - Instantaneous Power Waveform
    - Eigen Values

## Propositions

  - Set a fix interval
  - Normalize the data
  - Set a threshold variation. (difference in voltage, power, current)
  - Detect events by switching on/off appliances.
  - By analyzing delta forms, and using an algorithm, extract feature changed.
  - With a known database of features, match database with change in composite load signature.

## Eagle

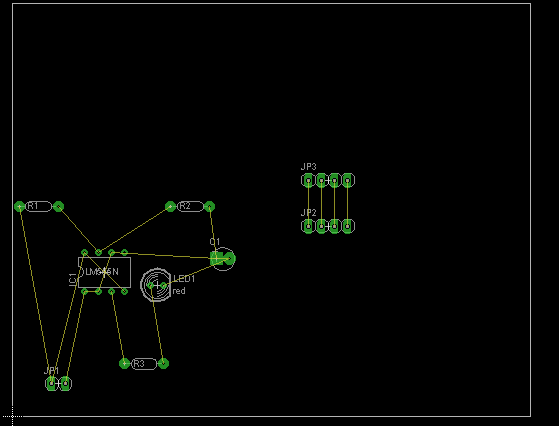
[picture p130: figure]
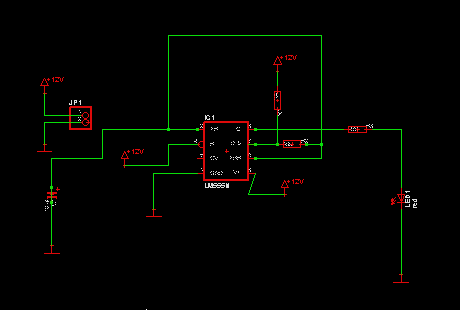
[picture p131: figure]

## Long Term Goals

- Implementing knowledge about load signature decomposition with hardware
- Developing the program that will recognize each appliance
