CalPlug/SparkyStrip/documents/senior design/ems/load_sig/presentation/6-03-2013/Active and Reactive Power (Charles Lam's conflicted copy 2013-06-03).pptx

## TEAM EMS PRESENTATION

- By Camilo
6/3/2013

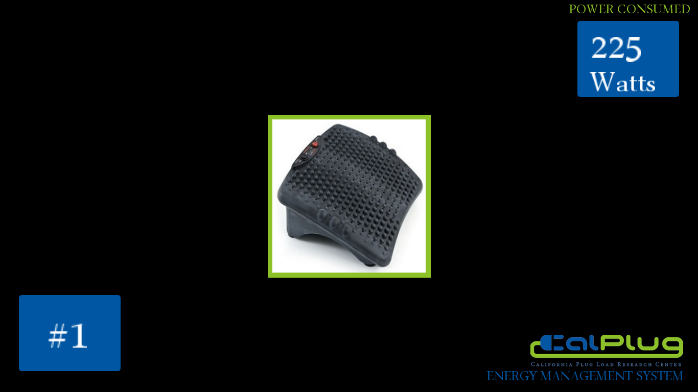
[picture p132: figure]

## Active and Reactive Power

Load

## Voltage Current

Load

## Current Voltage Meassurements

- Real Power Consumption (WATTS)
- Reactive Power (VAR)
  - Phase Shift
    - Capacitor/Resistive/Inductive Circuit
    - Phase add linearly

## Slide 5
