CalPlug/SparkyStrip/documents/senior design/ems/load_sig/presentation/6-03-2013/Active and Reactive Power.pptx

## TEAM EMS PRESENTATION

Camilo Aguilar
06/03/13

## Active and Reactive Power

Load

## Voltage Current

Load

## Current Voltage Meassurements

- Real Power Consumption (WATTS)
- Reactive Power (VAR)
  - Phase Shift
    - Capacitor/Resistive/Inductive Circuit
    - Phase add linearly

## Slide 5


## Slide 6
