CalPlug/SparkyStrip/documents/senior design/ems/load_sig/presentation/6-03-2013/EMS Team Meeting Progress Report 6-3-13.pptx

## EMS Team Meeting


Johnny Nguyen
Camilo Aguilar
Upa Sundaram
Charles Lam

June 3, 2013

## Problem: Recognizing Similar types of Devices

- Waveforms of laptops in steady state similar:
  - Becomes even more complicated with different power consumption modes, whether or not the laptop is fully charged, etc.

## Slide 3

Dell Laptop


Lenovo


HP Probook 4530s


Dell PC


HP Pavilion dm4


## Harmonics of Different Computers

Lenovo


HP Probook 4530s


HP Pavilion dm4

Dell PC


## Resonant Harmonics

Lenovo


HP Probook 4530s


HP Pavilion dm4

Dell PC


## Resonant Harmonics

Lenovo


Dell PC

HP Probook 4530s


HP Pavilion dm4
