CalPlug/SparkyStrip/documents/team meeting and presentations/01302015Meetingnotes.pptx

## CIEE Weekly Meeting

1/30/2015

## Agenda

- Updates
  - Delivering next Saturday
- To do list
  - Ezana: Building and testing
  - Jeff: Data mining, LED status
  - Edmund: Backend/Frontend, router config, LED status
  - Lin: 3D printing / (mobile interface)
  - Additional items: calibration with appliances, testing

## Hardware

- Board Ordered
- Parts arrived 80%
  - Missing: Tri-state buffer, Adafruit cc3000, USB cable/supplies
- Install LEDs with resistors
- Enclosure
  - Material from lake forest (to-do)
  - Leave space for LED

## Software

- Major changes:
  - MySQL -> MongoDB (MongoLab)
    - Backend: Python and Django, MongoRestAPI
    - Frontend: Arduino
  - On board detection -> cloud detection w/ accurate data (Protocol Change between Jeff & Edmund)
    - Power, PF, 3 of Harmonic Amplitude, 3 of harmonic phase, our Device ID, time.
  - Script on UCI server
    - ID algorithm
- LED indication
  - Wi-Fi, power, acquisition, status
