CalPlug/SparkyStrip/documents/team meeting and presentations/02202015 .pptx

## CIEE Project Meeting

2/20/2015

## Updates

- Visit to UCD:
  - 2/24 and 2/25 Thursday Friday

## Action Items

- Testing
  - Crystal
  - Functionality
  - Wi-Fi daughter board
- Integration of Wi-Fi (PCB, daughter board, real data)
- Calibration power analyzer
- Enclosure
