CalPlug/SparkyStrip/documents/team meeting and presentations/10162014_LX.pptx

## CIEE Team Meeting

Linyi Xia
10/16/2014

## From Previous Senior Design

- 3 parts to the system:
  - Outlet module: control & signal processing
    - Power switching
    - Current probe to USB
  - Rasp Pi: collects serial info from the outlet module performs recognition.
  - Phone app for display and control.

## Outlet module

- 1. Outlet Module
- The outlet module is plugged into an electrical outlet, following which the user’s device is plugged into the outlet module. Our module uses these components:
- TI CC2530 SoC 2.4 GHz IEEE 802.15.4/RF4CE/ZigBee
- SmartRF05 Evaluation Board
- Outlet Adapter

## Central Hub

- 2. Central Hub
- The central hub is the gateway between the outlet module and the user. Data regarding scheduling or profiles will also be stored here.
- Raspberry Pi Model B
- USB-CID - ZigBee USB Interface
- WiFi USB Dongle
