CalPlug/SparkyStrip/documents/team meeting and presentations/07142014/CIEE biweekly meeting Linyi Xia.pptx

## CIEE Team Meeting

Linyi Xia 7/14/2014

## Objectives

- Identify critical path for creating a library of appliances load signature

## Information needed for identifying device

- Vrms
- Irms
- Power: Active and Reactive
- Pf
- Measurement resolution, 1ms after the device stabilized.

## Examples from Papers

- Micro Load Signature (20ms period)

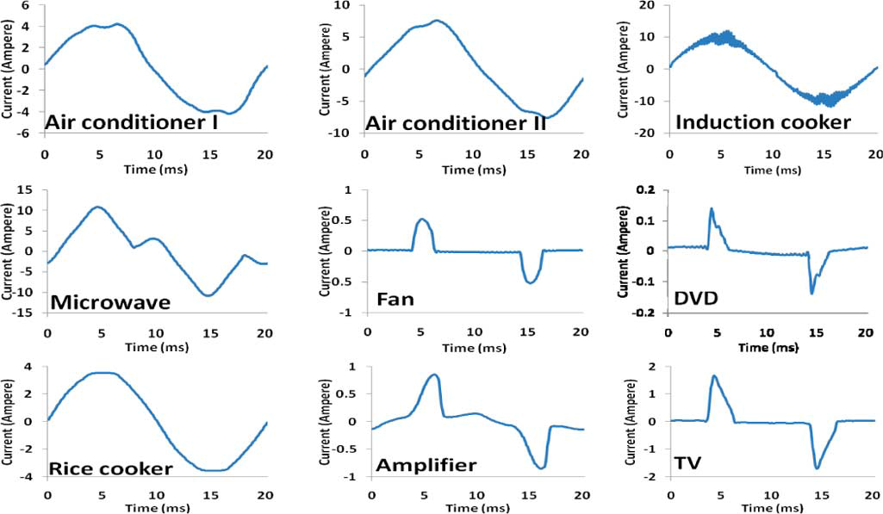
[picture p133: figure]

## Examples from Papers

- Macro-load signatures (over 2 hours shown)

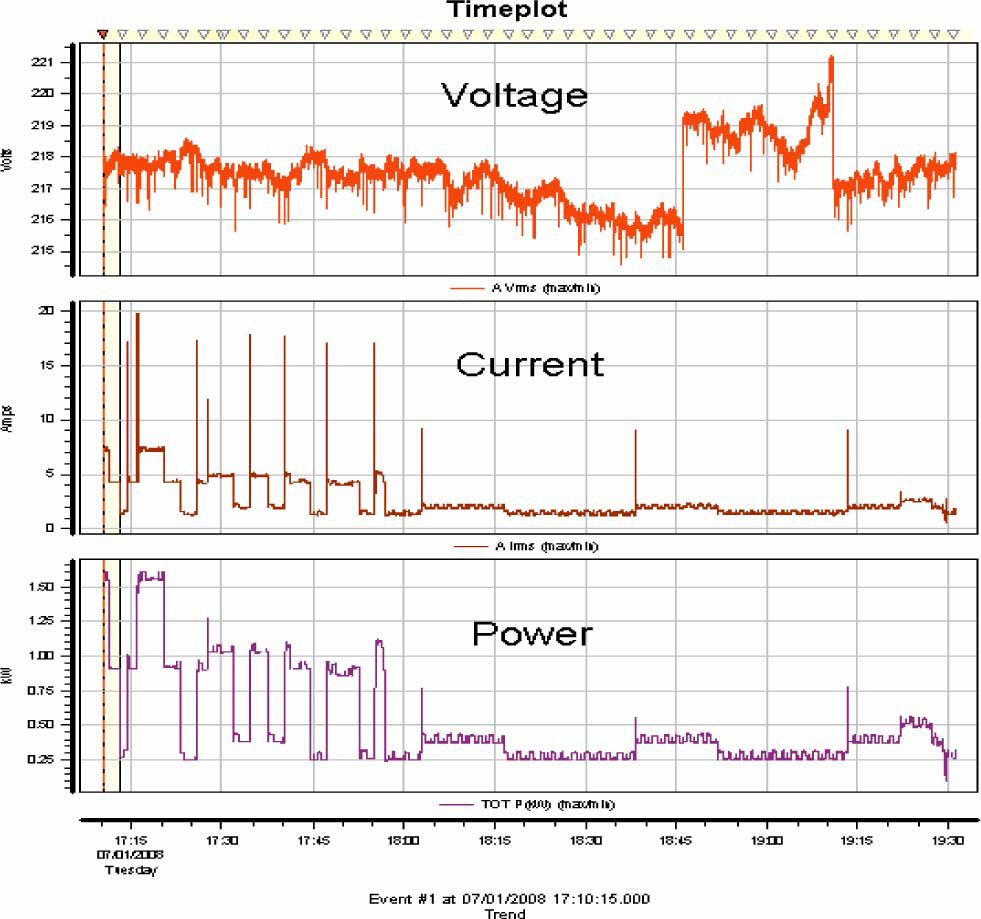
[picture p134: figure]

## Data Collected in CalPlug SimLab (TV)

## Data Collected in CalPlug SimLab (TV)

## Data Collected in CalPlug SimLab (TV)

## Data Collected in CalPlug SimLab (TV)

## Data Collected in CalPlug SimLab (TV)

## Next Step(s)

- Complete micro load signature
  - Data acquisition equipment purchasing
  - Acquire data
- Device detection
