CalPlug/SparkyStrip/documents/team meeting and presentations/07142014/Meeting 7-7-2014.pptx

## Meeting 7-7-2014 App Design

Everardo Camacho

## App Design

Checkboxes of different appliances

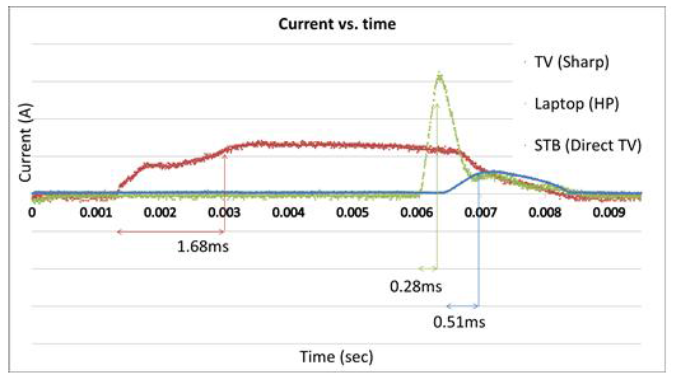
[picture p135: figure]

Data fetched from server, stored in sqlite
Graph on interface
Checkbox buttons for different appliances
Refresh Data
