CalPlug/SparkyStrip/documents/team meeting and presentations/08112014/Linyi Xia 08112014.pptx

## CIEE Team Meeting

08/11/2014
Linyi Xia

## Overall Team Progress

- Refer to MS project

## Tasks and goals for the week (Linyi Xia)

- Create and establish connection to local server and database
- Check on order status
- Take current load signatures

## Server Connections

- Server:
  - IP: 128.195.185.149
  - Database name: CIEEdata
  - Username: CIEE
  - Password: CIEE2014$
  - mysql> GRANT ALL PRIVILEGES ON CIEEdata.* TO 'CIEE'@'localhost'; //DONE
  - Accessing server from linux: mysql -u CIEE -p -h localhost
  - Then type in password
  - http://stackoverflow.com/questions/6445917/connect-failed-access-denied-for-user-rootlocalhost-using-password-yes (http://stackoverflow.com/questions/6445917/connect-failed-access-denied-for-user-rootlocalhost-using-password-yes)

## Order Status

- MI board back ordered. Hoping to get it within the next two weeks
- Need to place orders for wifi and zigbee dongles

## Current Measurements

- Arduino ADC limitations:
  - Possible nosises
  - 0.026A (26mA) per count out of 1023 counts.
  - If can’t find a solution to the noise situation, then phantom load detection maybe stalled. (not required for the project)
