CalPlug/SparkyStrip/documents/team meeting and presentations/11042014/Calplug Slides 1.pptx

## William Li Front End Software Design

## Overall Goal

- Create user friendly website
- Website shows the amount of power being consumed in the outlets
- Data generated from server every 5 or 10 seconds

## Weekly Task

- Become more Familiar with PHP and Javascript
- Start developing a prototype

## Progress Report

- Learning PHP and Javascript but not familiar enough with them to start implementing a design

## Slide 5
