CalPlug/SparkyStrip/documents/team meeting and presentations/11182014/Calplug Slides 2.pptx

## William Li

Software: Front End

## Overall Goal

- Create website that pulls data from server
- Data displayed on the website that shows
  - Device ID
  - Device Status
  - Power Consumption

## Weekly Task

- Created an early design for the website
- Attempted to read and display data from a random text file
- Learned HTML, CSS, and PHP

## Problems/ Issues

- Not sure of the type of data stored in the server

## Proposed Action

- Be able to display data from a text file
- Clean up interface of website and make it more appealing
- Learn MySQL
- Start trying to display data from server
