CalPlug/SparkyStrip/documents/team meeting and presentations/CPR Meeting/CIEE_Berkeley_Presentation.pptx

## Smart Power for the Smart Home: Inverter Controls, Power Factor Corrections, and Peak Demand Reductions

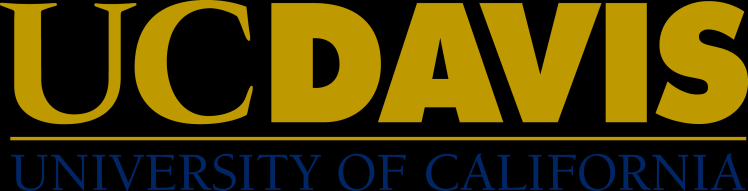
[picture p136: figure]

G.P. Li, Keyue Smedley - UC Irvine
California Plug Load Research Center
Power Electronics Laboratory
Mark Modera, Nelson Dichter - UC Davis
Western Cooling Efficiency Center

## Smart Load Management and Generation for Zero Net Energy Residences

- Background:
  - Capacitance and inductance create and consume reactive power
  - Reactive power introduces difficulties maintaining a robust grid
  - Not possible to charge consumer for reactive power
  - Minimal consumer concern and resources allocated to correct and monitor the power factors
- Project Goal:
Enable smart management of electric loads and generation for zero net energy residences while advancing three technological elements

## Benefits for Utilities and Users

- Current:
  - ~30% of national electricity usage is for residential areas
  - 15.9GW of PV installed in US by Q2 2014
  - Can power 3.2 million homes

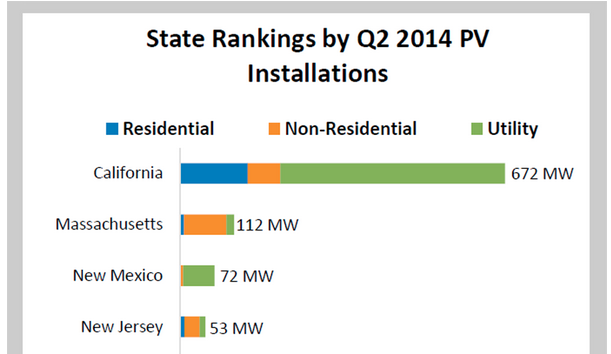
[picture p137: figure]

- Challenges:
  - PV is an intermittent energy source
  - Various plug loads cause power factor to fluctuate
- Solution:
  - Active power factor correction at PV inverter and home ADR

## Main Technology Advancements

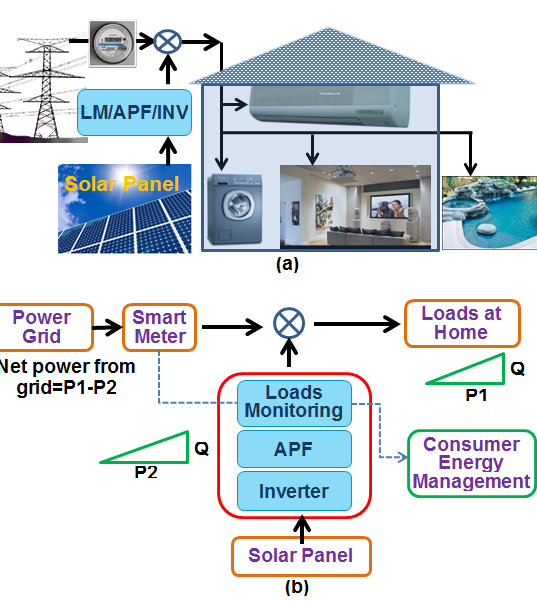
[picture p138: figure]

- Inverter-integrated active power factor correction
- Load signature analysis for wireless load monitoring and control
- Integrated design and control of HVAC and storage for shifting peak demand (UCD)

## Inverter-integrated active power factor correction

- Typical PV inverter provides active power only
- Reactive power from the load will be passed to the grid
- In net-zero situation, pure reactive will go to grid
- Active power filter can cancel the reactive power

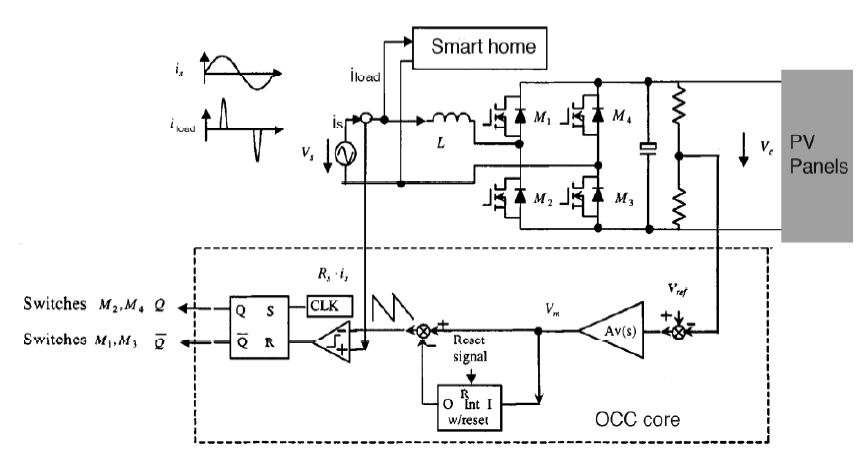
[picture p139: figure]
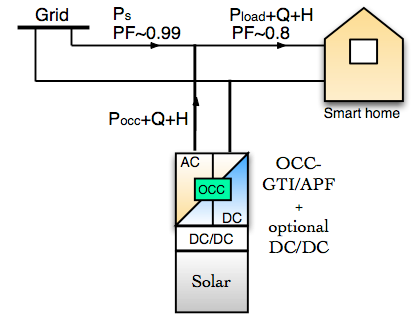
[picture p140: figure]

## Active Power Filter Function

APF operation waveforms:
1. Grid voltage
2. Grid current
3. Load current
4. APF current

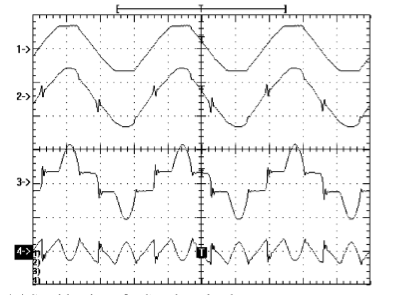
[picture p141: figure]

- Remove reactive load and harmonic components
- Realize power factor near 1
- Reduce line losses
- Increase line capacity
- Protect sensitive loads

## APF Objectives

This phase
- Implement 1.5kW APF
- Test and fine tune in the lab
- Real circuit demonstration
- APF can be used for retrofit

Next phase
- Inverter with APF function built-in will be pursued
- Field demonstration of inverter under net zero condition will show zero reactive and harmonics

## Load signature analysis for wireless load monitoring-- Objectives

- Background:
  - Little to no incentive for end users to shift off peak hour consumption
  - Consumer usage behavior information can be utilized to promote energy conservation

- Objectives:
  - Provide utility end-use information for billing, efficiency program marketing, or demand response control
  - Provide load consumption feedback for users or for EMS

## Load signature analysis for wireless load monitoring -- Approach

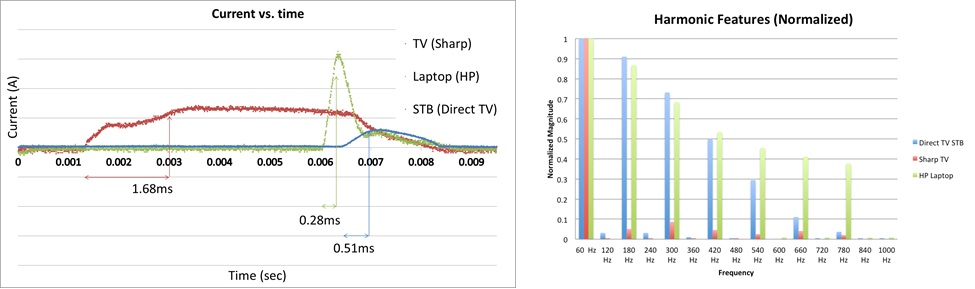
[picture p142: figure]

- Technical Approach:
  - Use energy metering IC to measure real and reactive power to track and categorize appliances (macro load signature)
  - Use first 15-second waveform to further identify devices (micro load signature)
  - Use FFT to obtain harmonic content
  - Match devices from a database of load signatures and usage patterns of the consumers

## Load signature analysis for wireless load monitoring – System Layout

- Capturing →Analysis → Display

Signal comes in

Transient

FFT
Harmonic Features

Load Characteristics

Transient: PF, Power, Reactive Voltage and Current
Frequency: Harmonic Features

15sec

Load Characteristics matching

Server

Mobile Interface

Steady
States

System Layout:
Capture (ADE7763) Analyze (ARM & Linux) Data Storing (Server) Display (HTML Mobile Interface)

## Load Signature Monitor and Report – Progress

Capture and Analysis Progress

- Current and voltage probe measurements to build device library
- Current Probe and TI2530 on SmartRF05 Board, with Raspberry Pi
- ADE7763 to Arduino, to server

- Sectional Mobile Interface

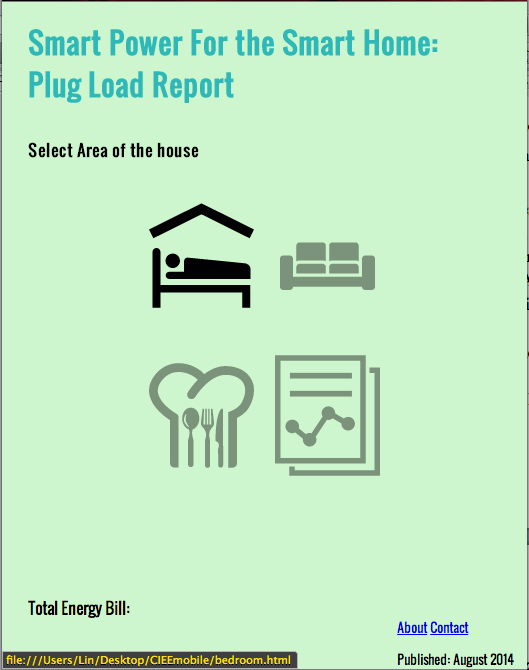
[picture p143: figure]

## UC Davis Field Demonstration

- UC Davis will conduct field demonstrations at the Honda Smart Home in Davis, California.
- APFC device developed by UC Irvine will be installed and monitored to assess:
  - Energy flows and efficiencies for the device
  - Power factor correction effectiveness
  - Improvement to harmonics generated by the Smart Home
- Load signature analysis device will be installed
  - Functionality and user interface will be demonstrated

## UC Davis Modeling

- UC Davis will use EnergyPlus to model a ZNE home
- Simulations will include:
  - Alternative mechanical system efficiencies
  - Alternative load shifting strategies
  - Different levels of generation
and storage
  - Differences in stochastic user behavior
  - Differences in end use load profiles, including electric vehicle use
- UC Davis will use MATLAB model of APFC device provided by UC Irvine to post-process EnergyPlus results
  - Results will be used to determine impact of APFC device on the grid in various scenarios

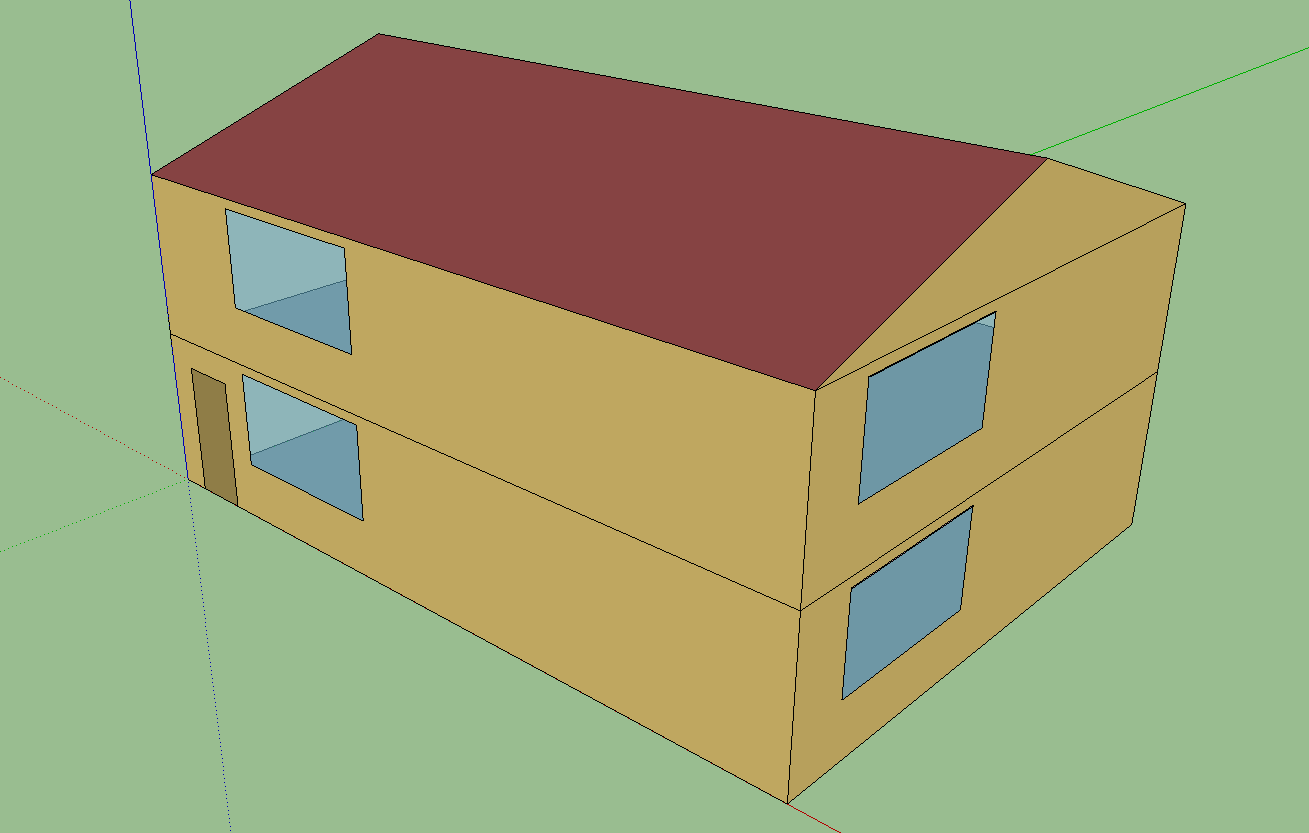
[picture p144: figure]
