CalPlug/SparkyStrip/documents/Fall 2015 Senior Design/39-plan-0.pdf.pdf

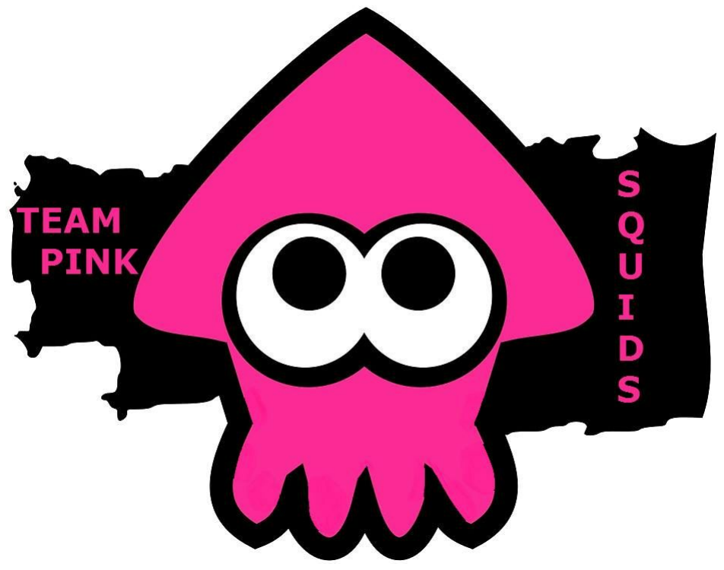
[picture p145: figure]

CSE 181A -Senior Design

# Sparky Strip A Project Plan

By Pink Squids

Date: November 30th 2015

Edmund Loo, Computer Science and Engineering

David Pynes, Computer Science and Engineering

Jeffrey Thompson, Computer Science and Engineering

Andrew Picard, Computer Science and Engineering

G.P. Li, Mentor

Linyi Xia, CalPlug Technical Lead

## Executive Summary (5 points)

Project Sparky Strip provides a new way to think about powering your home. By using machine learning, data analytic tools, and some hardware we will gather appliance signatures, identify the plugged in devices and display their power usage characteristics back to homeowners. This could revolutionize the way we think about home power consumption, conservation, and safety. Welcome to team Pink Squid’s Sparky Strip

## Table of Contents

Executive Summary (5 points)

Chapter 1. Introduction (15 points)

Chapter 2. Background and Related Work (10 points)

Chapter 3. Problem Statement (15 points)

Chapter 4. Technical Approach (20 points)

Chapter 5. Development Plan (25 points)

Bibliography (5 points)

## Chapter 1. Introduction (15 points)

Let us use the following pages to describe to you how and why we all need to monitor home power consumption. Not only is this a push for the greater good of humanity, but also a highly needed and valuable product for homeowners everywhere as no one really knows where their power consumption is going. There are devices to assist the homeowner in that regard, but it takes a log of manual work and data logging to even figure out what one appliance is doing, let alone the whole house. What If we could monitor power use and gather appliance information without programming or really any work at all? And what if all this historical information was available at the tips of our fingers on a phone or tablet? This is the inspiration behind the sparky strip. Let’s get a bit more technical.

The more information we can gather the more power we will have. In the case of smart homes we are concerned with just that, power. The problem is that devices often consume much more power than necessary, devices may not be working as desired, and with smart power we can control the management of power consumption through this embedded device, the sparky strip. In addition to the previous remedies that will be found when creating this device we will help with the sage of load signature analysis for wireless control and monitoring, identify unique signatures through the waveforms of each appliance during operation (unique voltage, current, power), and sample waveforms to identify start, run, stop states of each signature.

### 1.1 Motivation (5 points)

Currently there is very little real data of device usage patterns. Power companies, governments, and consumers have little idea where power is being consumed. Awareness is the first step to changing usage patterns yet today little is known more than the Megawatts used every month. What if there was a device that with no work on the user's part identified who, what, and where power is being consumed? This is the problem we are solving, and the potential impact is huge.

### 1.2 Potential Impact of Work (10 points)

### 1.2.1 Relation to EE, CpE, and CSE (2 points)

As we are all computer science and engineering majors, the relevance to our major is greatly represented by the project as the necessary skills for this project require aspects of our courses we have taken such as digital signal processing circuit design, and an understanding of databases and network protocol. In terms of the potential impact of our work. This is dependent on the accuracy of our device in being able to deliver the proper return of the appliances inserted into the device and being able to understand the data that is being transmitted through the device to be able to detect the appliance. The possibilities posed here with a success would result in being able to power manage and detect areas where power consumption is greatest to allow consumers and providers of electricity to manage power better which would be a major impact that would be due to the results of our work.

### 1.2.2 Global Context (2 points)

In consideration of a global context, the device has the potential of assisting users with their power consumption to better understand what devices are pulling the most power. This will be especially useful for users in locations where the power management is not very well maintained in order to conserve on electricity. This in term has a major impact in a global context as conservation of energy is greatly needed.

### 1.2.3 Economic Context (2 points)

The impact of the work on society will be very world altering as it is both an environmentally focused device and an economically profound concept. As well, a potential impact on a global context, the maintaining of power could lead to major reductions in electrical costs for communities as people will be able to control their costs of power by being able to reduce it through a monitor of their appliances plugged into the device. This is very important and is needed in the market as the world today is very much dependent on electrical appliances.

### 1.2.4 Environmental Context (2 points)

In order to create a device such as this, a consideration of the potential environmental impact does come into play. In this case, it would be lowering the carbon footprint that people place on the Earth as it would result in a better control of power and this leads to less waste of electricity of the users of the device as power management is taken into consideration.

### 1.2.5 Societal Context (2 points)

Our project can make an impact on society through awareness of energy consumption. This will change the way people view electricity as well as electrical devices. People will be able to visually and grasp an idea of how much energy individual devices use and how that affects our world and environment. Through this project, society can find awareness. Through awareness, real change can be made towards a better, cleaner, healthier world.

## Chapter 2. Background and Related Work (10 points)

### 2.1 Background (5 points)

The device in and of itself is fairly intuitive to the end user, but to actually understand the ins and outs of the device you must have fairly intimate knowledge of embedded devices, algorithms, applications, and servers. In addition, to be able to present the project in a consumable way one would need to know about topics closer to web development. Beyond these requirements to understand the device one must have knowledge of signal processing, machine learning, and data manipulation.

### 2.2 Related Work (5 point)

While there are competitors on the market we strongly believe that our solution is the best and most profound application and use of such a device. Since the project both includes a large breadth and depth of quality and capabilities we aren’t concerned about devices that are perceived as competitors, such as a smart home lighting switch.

Since we will be constantly giving feedback and control to the end users our device will reign for superior to other. Panasonic has already tried to come to market with a product for the home that claims to be a, "smart home power monitor." This product is a home add-on and boasts the affordable price of 38$. The product can be seen here: http://shop.panasonic.com. This device isn't aiming for the capabilities that we are though. This device first off is only an add-on. It only offers power control on and off and socket control from a tablet. What we plan on providing is a much more robust concept. We are looking at device signatures and providing real time feedback to end users that monitor power consumption. Although Panasonic is potential in our space we don't feel that their product is threatening nor makes our product obsolete, in fact, we would be inspired by

Panasonic wanting to one day work in partnership with us to fully develop our extremely practical and useful device.

## Chapter 3. Problem Statement (15 points)

### 3.1 Requirements (8 points)

The device should be portable, lightweight, and easy to use. The device will be boxy. This box shape will be an innate feature of our product because it is confined by a raspberry pi, an Arduino, oscillator, and additional I/O devices to read electrical signals. When taken to market the device will need to have a waterproof encasing, but for the purpose of this course we will not be concerned with waterproofness. Our device will have a wireless component because it will need to send off information to a database. The frequency and amplitude ranges that will be taken into account will be wide and varying as we will need to be able to discern values from various wall inputs. The project will be difficult and hard to structure for efficient data gathering and manipulation. Linear/polynomial regressions (best fit lines) will be one way of implementing machine learning to find clusters of data which will associate as a device's signature. This is the metaphorical tip of the "iceberg" of what and how we can use machine learning on this project. Further, we will need to properly organize our data by setting up a server, database, and hopefully an interface in which end users can get a visual representation of the work, device's signatures, and monitor power usage.

### 3.2 Constraints (4 points)

As we move closer to our deadlines our biggest constraint is time to fully develop and build out our project to meet the specifications and standards of which we have set for ourselves.

### 3.3 Objectives (3 points)

We aim to help the end user, whom is a home owner or smart home dweller. Our device will provide a platform for users to have smart power. This is the ability to identify the consumer's usage of electricity to provide higher efficiency in both the utilities provisions from the providers and the energy consumption of the consumers.

## Chapter 4. Technical Approach (20 points)

### 4.1 System Block Diagram (5 points)

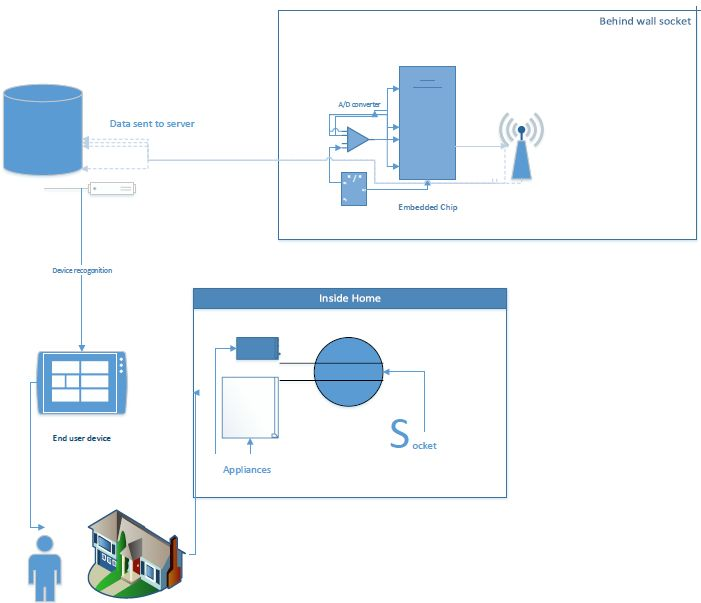
[picture p146: figure]

### 4.2 Subsystems (5 points)

At the highest level we have a home. Going a level deeper we have appliances attached to a wall sock, behind the socket is a CPU and devices to read signals. That information is submitted to an offsite server and the information is understood and received by the end user.

### 4.3 Interfaces (5 points)

Notice that there are different types of arrows drawn on the top down diagram. The dotted arrows represent wireless signals. The solid lines represent the chain of action in which the data path follows. We will be using HTTP and a custom protocol on top of the TCP.

Describe the interfaces between subsystems and with the environment.

### 4.4 Technology Options (5 points)

We are using very fundamental components for this project such a component for phase and frequency, a component to recognize current, a 32-bit CPU to gather samples, a wireless transmitter to send the data out, and a server.

The end user will also need a device such as a personal CPU, an iPad, or a smartphone.

In terms of software, we will be using legacy code as well as refining the code and writing new code to add new features. Code will be primarily in C, Python, SQL, and web (HTML, XML, JS)

### 4.3 Initial Choice and Justification

The most promising technology that we are using is the legacy code coupled with machine learning. Since the hardware has already been set up from our team from last year we know that we are able to gather sufficient amounts of data. The most promising next step is what we will be able to do with this data.

The ability to make sense of large data sets makes new efficient algorithms very promising for their suitability.

## Chapter 5. Development Plan (25 points)

This is material from Assignment 5.

### 5.1 Team Organization (5 points)

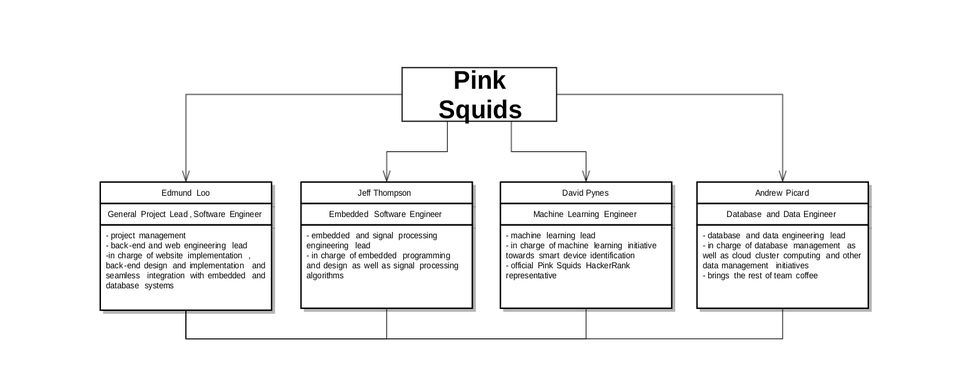
[picture p147: figure]

### 5.2 Tasks and Responsibilities (5 points)

Edmund Loo
■ Major: Computer Science and Engineering
■ Skills and Experience: https://www.linkedin.com/in/edmundloo ■ Contributions to Team: Data gathering & team management.

David Pynes
■ Major: Computer Science and Engineering
■ Skills: Familiar with C, C++, Java, data structures, algorithms, and Microsoft Office's Excel. In addition, proficient in embedded system design, web development, and SAP analytic tools.
■ Experience: Event management & Data analytics.
■ Contribution to Team: Algorithms & Machine Learning.

Jeff Thompson
■ Major: Computer Science and Engineering

■ Skills: Strong in Embedded systems, Electronics, C++, Python, Perl, System Verilog, VHDL.
■ Experience: As an electronics Technician, Pre-silicon Validation.
■ Contributions to Team: Embedded hardware & Micro-managing.

Andrew Picard
■ Major: Computer Science and Engineering
■ Skills: Java, C/C++, RDBMS, JDBC, Embedded Systems.
■ Experience: Quality Engineering, DevOps.
■ Contribution to Team: Machine Learning & Database manipulation.

### 5.3 Tools (5 points)

We will be using Slack, Trello, and our Facebook group in terms of communicating within the group in order to make sure we work in a timely manner.

In terms of source control, we will be using GitHub to share our work.

We have a PCB Layout already designed for the device. CalPlug also has a soldering station will all needed tools.

C++ will be used on the device starting in the Arduino environment, later switching to Atmel Studio if we have time.

Python will be the main language used on the server. The database type and machine learning algorithms are still being researched.

### 5.4 Timeline (5 points)

First week or two will be dedicated to bringing our tools together and researching the best tools to use for the project itself (database, web server, connectivity, sample collection, early testing).

Next two weeks will be dedicated to analysis of the problems we have ahead of us. This includes how we will overcome these issues (machine learning issues, sampling issues, clustering issues, hardware issues, etc.) as well as further progressing on the intended goal of the project.

The rest of the weeks will consist of the team implementing the design and testing appliances on the Smart Strip. Collecting samples as well as understanding the data that is being pushed to the web server in order to be able to detect what devices are being plugged into the smart strip.

Near the end of the winter quarter will consist of wrapping up the project and preparing for the presentation (website to present data findings).

Milestones:

- Device gathering data and producing the signatures
- Device to server communications established
- Signatures pushed to database
- Machine learning algorithm identifying single devices
- Results displayed to the user

### 5.5 Resources (5 points)

In terms of finance, we are expecting no more than a $1000 dollar budget. Most of the cost is attributed to the physical aspects of the device and if replication of the device is necessary for further testing. The hardware of the device itself has already been produced as we are improving upon it. CalPlug is providing access to a server for our use. In the event we needed to rent server time (AWS or similar, that would be a further expense).

## References (5 points)

[1] David Pynes, Andrew Picard, and Jeff Thompson, “Google Doc Pink Squids Fall Assignments,”
