CalPlug/SparkyStrip/documents/senior design/load_sig/presentation/2-15-2013/fft Data.xlsx

FAN |  |  | In Phase |  |  |  |  | Out of Phase |  | Opposite Phase |  | 90 degrees |  | 270 degrees
 | Starting Sample no |  | 84 | 167 | 250 | 1 | 333 | 30 | 450 | 43 | 210 | 22 | 105 | 63 | 146
 | Phase | 60 Hz | 1.5559 | 1.534 | 1.5117 | -1.5632 | 1.49 | 0.592 | 0.8698 | -1.5365 | -1.503 | -0.0093 | -0.0307 | -0.0567 | -0.0775
 |  | 180 Hz | -1.0878 | -0.9126 | -0.6276 | -0.9243 | -0.6064 | -0.1453 | 0.8356 | -1.1958 | -1.3362 | -0.9951 | -0.998 | -1.0369 | -1.049
 |  | 300 Hz | -1.2934 | -2.4057 | -1.5497 | -1.1978 | 1.4422 | -0.2046 | 1.1831 | -1.0589 | -0.9235 | 0.4645 | 0.3799 | 0.2651 | 0.1739
 | FFT | 60 Hz | 1 | 1 | 1 | 1 | 1 | 1 | 1 | 1 | 1 | 1 | 1 | 1 | 1
 |  | 180 Hz | 0.0046 | 0.0045 | 0.0057 | 0.0051 | 0.0059 | 0.0155 | 0.005 | 0.0052 | 0.0051 | 0.04 | 0.0387 | 0.0398 | 0.0401
 |  | 300 Hz | 0.0389 | 0.0389 | 0.0381 | 0.0405 | 0.0375 | 0.0441 | 0.0341 | 0.0414 | 0.0427 | 0.0479 | 0.0463 | 0.0445 | 0.0443
 | Real_FFT | 60 Hz | -0.0149 | -0.0368 | -0.059 | 0.0076 | -0.0802 | 0.8298 | 0.645 | -0.0342 | -0.0678 | 1 | 0.9995 | -0.9984 | -0.997
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
