CalPlug/SparkyStrip/documents/senior design/load_sig/presentation/10-26-2012/Andrew Wang 10-26-12.pptx

## Identifications of Different Waveforms

Andrew Wang

## Slide 2

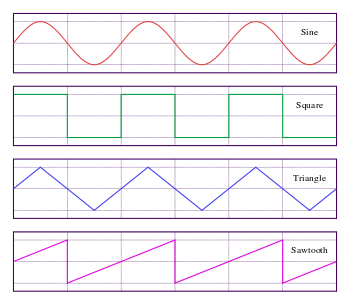
[picture p149: figure]

## Slide 3

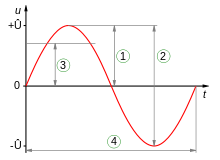
[picture p150: figure]

- 1 = Peak amplitude (U)
- 2 = Peak-to-peak amplitude (2U)
- 3 = RMS amplitude (U/2^(1/2))
- 4 = Wave period (not an amplitude)

## Oscilloscope Measurement

- Rise and Fall Times
- Discrete Fourier Transforms (DFT)
- Fast Fourier Transforms (FFT)
- Phase Shift

## Rise and Fall Times

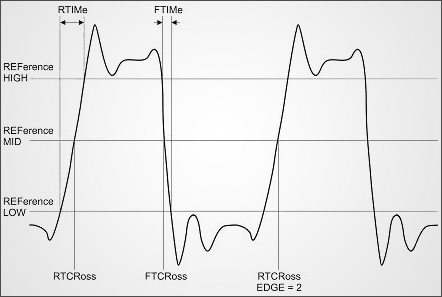
[picture p151: figure]

## Discrete Fourier Transforms (DFT) and Fast Fourier Transforms (FFT)

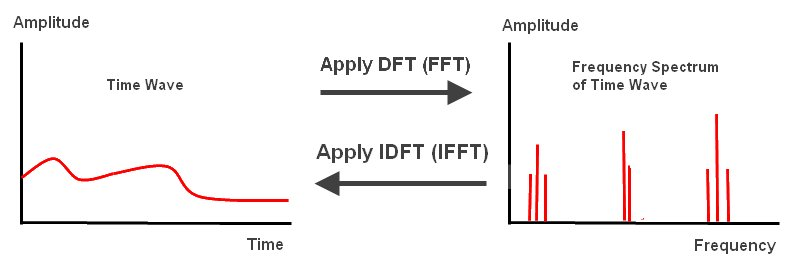
[picture p152: figure]
TimeWaveToFrequenceSpectrum

## Phase Shift

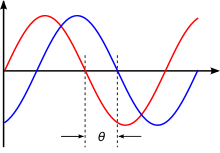
[picture p153: figure]

- Unit – angle θ
- Phase shift is any change that occurs in the phase of one quantity, or in the phase difference between two or more quantities.
- Phase difference is the difference, expressed in electrical degrees or time, between two waves having the same frequency and referenced to the same point in time.

## Article: Analysis of Non-Sinusoidal Waveforms

- Symmetry in Waveforms
- Even Symmetry
- Odd Symmetry
- Half-wave Symmetry

## (a) Even Symmetry

- f(t) = f(-t)
- f(t) = (−) f(-t)

(b) Odd Symmetry

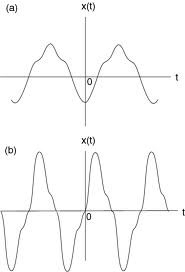
[picture p154: figure]

## Half-wave Symmetry

- f (t) = (−) f (t − T/2) = (−) f (t + T/2)

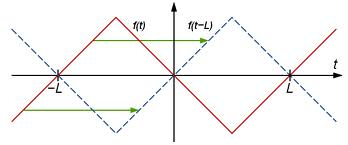
[picture p155: figure]

## FAN-50kHz_Sampling

## HP-50kHz_Sampling

## STB-50kHz_Sampling

## TV-50kHz_Sampling

## Thanks
