CalPlug/SparkyStrip/documents/senior design/load_sig/presentation/6-03-2013/GUIpresent.pptx

## Calplug EMS Team Meeting

Charles Lam
6/3/13

## Slide 2


## Slide 3

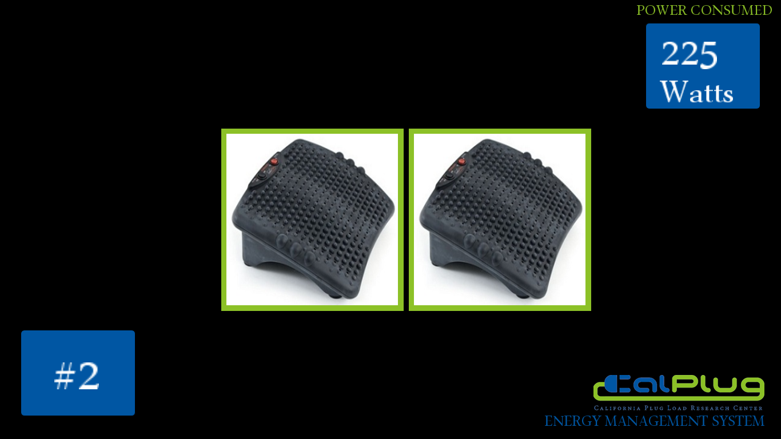
[picture p156: figure]

## Slide 4

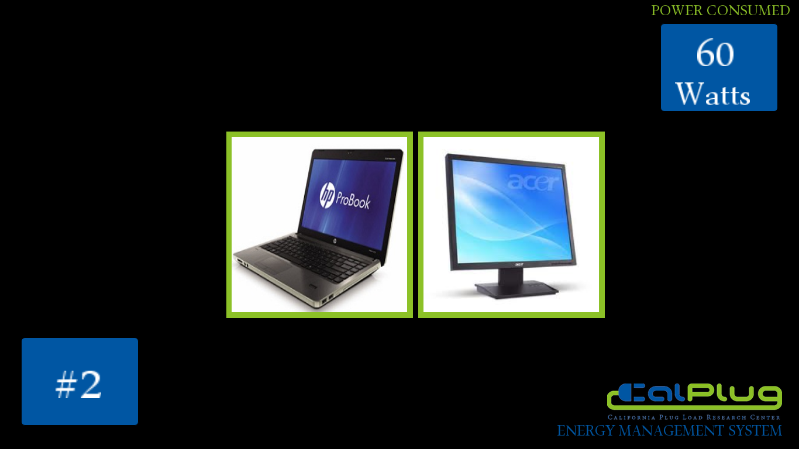
[picture p157: figure]

## Slide 5

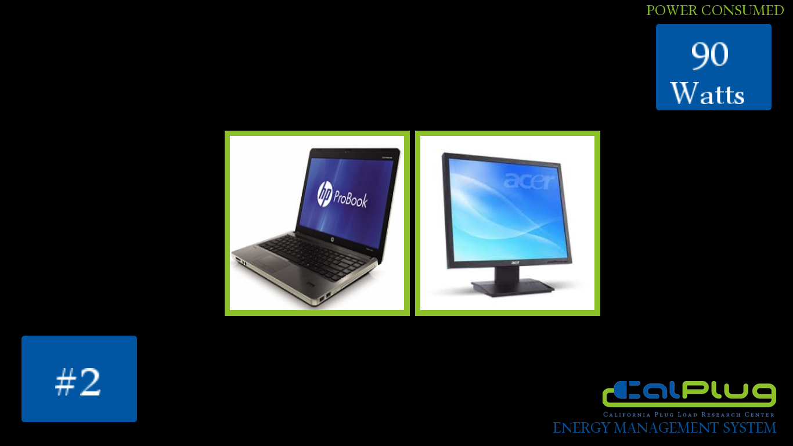
[picture p158: figure]
