CalPlug/SparkyStrip/documents/senior design/ems/load_sig/presentation/6-03-2013/GUIpresent.pptx

## Calplug EMS Team Meeting

Charles Lam
6/3/13

## Slide 2


## Slide 3

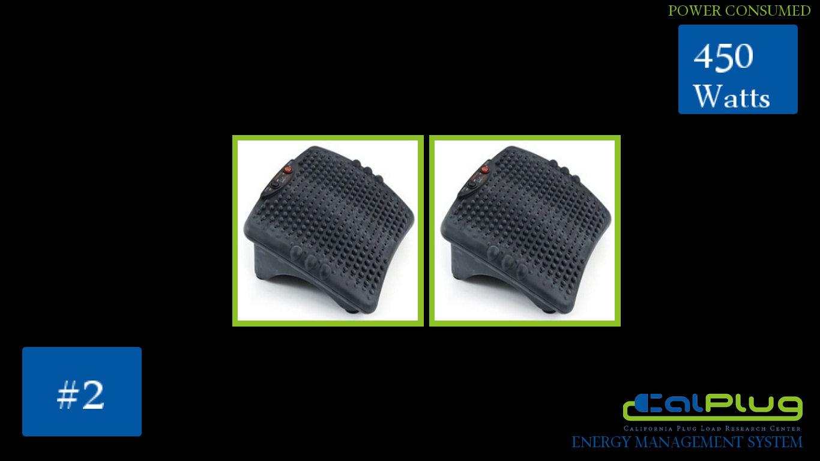
[picture p159: figure]

## Slide 4

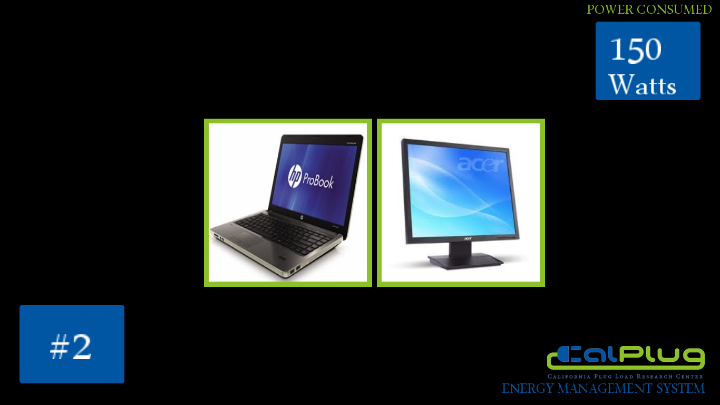
[picture p160: figure]

## Slide 5


## Slide 6
