CalPlug/SparkyStrip/documents/senior design/ems/load_sig/recordedwaveforms/Appliances with Reference Voltage/FAN.xlsx

Model | DPO3014
Firmware Version | 2.23
Waveform Type | Analog | Analog
Point Format | Y
Horizontal Units | s
Horizontal Scale | 0.02
Horizontal Delay | 0 | 0
Sample Interval | 0.0002
Record Length | 1000
Gating | 0.0% to 100.0% | 0.0% to 100.0%
Probe Attenuation | 10 | 10
Vertical Units | V | A
Vertical Offset | 0 | 0
Vertical Scale | 100 | 5
Vertical Position | 2 | -2
Label
TIME | CH1 | CH2
-0.1 | -4 | -1
-0.0998 | 4 | -0.2
-0.0996 | 8 | -1.6
-0.0994 | 32 | -2.4
-0.0992 | 44 | -3.2
-0.099 | 60 | -3.6
-0.0988 | 72 | -4
-0.0986 | 80 | -4
-0.0984 | 92 | -4.4
-0.0982 | 100 | -5
-0.098 | 108 | -5.6
-0.0978 | 120 | -6
-0.0976 | 136 | -6.2
-0.0974 | 144 | -6.4
-0.0972 | 152 | -6.6
-0.097 | 152 | -6.6
-0.0968 | 164 | -6.4
-0.0966 | 164 | -6.6
-0.0964 | 160 | -6.8
-0.0962 | 160 | -6.6
-0.096 | 164 | -6.4
-0.0958 | 168 | -6.4
-0.0956 | 160 | -6.6
-0.0954 | 164 | -6.4
-0.0952 | 164 | -6.6
-0.095 | 156 | -6
-0.0948 | 156 | -6.2
-0.0946 | 152 | -6.4
-0.0944 | 156 | -6
-0.0942 | 152 | -6.2
-0.094 | 144 | -4.8
-0.0938 | 120 | -3.8
-0.0936 | 108 | -3.2
-0.0934 | 96 | -2.8
-0.0932 | 84 | -2.4
-0.093 | 72 | -2.4
-0.0928 | 64 | -2
-0.0926 | 56 | -1.2
-0.0924 | 44 | -0.8
-0.0922 | 36 | -0.2
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
