CalPlug/SparkyStrip/documents/senior design/ems/load_sig/recordedwaveforms/Appliances with Reference Voltage/HP.xlsx

Model | DPO3014
Firmware Version | 2.23
Waveform Type | Analog | Analog
Point Format | Y
Horizontal Units | s
Horizontal Scale | 0.02
Horizontal Delay | 0 | 0
Sample Interval | 0.0002
Record Length | 1000
Gating | 0.0% to 100.0% | 0.0% to 100.0%
Probe Attenuation | 10 | 10
Vertical Units | V | A
Vertical Offset | 0 | 0
Vertical Scale | 100 | 5
Vertical Position | 2 | -2
Label
TIME | CH1 | CH2
-0.1 | 0 | -0.2
-0.0998 | 8 | 0
-0.0996 | 16 | 0
-0.0994 | 32 | 0.2
-0.0992 | 44 | -0.2
-0.099 | 60 | 0
-0.0988 | 76 | -0.2
-0.0986 | 84 | -0.2
-0.0984 | 92 | 0
-0.0982 | 96 | 0
-0.098 | 108 | 0.2
-0.0978 | 124 | 0
-0.0976 | 140 | -0.2
-0.0974 | 140 | -0.2
-0.0972 | 148 | -0.6
-0.097 | 156 | -5.4
-0.0968 | 160 | -5.6
-0.0966 | 160 | -4.6
-0.0964 | 164 | -2.4
-0.0962 | 160 | -1.4
-0.096 | 160 | -1.8
-0.0958 | 164 | -1.6
-0.0956 | 156 | -1.2
-0.0954 | 168 | -0.8
-0.0952 | 160 | -0.6
-0.095 | 152 | 0.2
-0.0948 | 156 | 0
-0.0946 | 152 | 0.4
-0.0944 | 160 | 0.2
-0.0942 | 148 | 0.2
-0.094 | 136 | 0.2
-0.0938 | 124 | 0.2
-0.0936 | 108 | 0.4
-0.0934 | 96 | 0.4
-0.0932 | 88 | 0.2
-0.093 | 76 | 0
-0.0928 | 76 | 0.4
-0.0926 | 52 | 0.2
-0.0924 | 52 | 0.6
-0.0922 | 40 | 0.2
-0.092 | 24 | 0.4
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
