CalPlug/SparkyStrip/documents/senior design/ems/load_sig/recordedwaveforms/Appliances with Reference Voltage/STB.xlsx

Model | DPO3014
Firmware Version | 2.23
Waveform Type | Analog | Analog
Point Format | Y
Horizontal Units | s
Horizontal Scale | 0.02
Horizontal Delay | 0 | 0
Sample Interval | 0.0002
Record Length | 1000
Gating | 0.0% to 100.0% | 0.0% to 100.0%
Probe Attenuation | 10 | 10
Vertical Units | V | A
Vertical Offset | 0 | 0
Vertical Scale | 100 | 1
Vertical Position | 2 | -2
Label
TIME | CH1 | CH2
-0.1 | -4 | -0.04
-0.0998 | 0 | -0.04
-0.0996 | 8 | -0.08
-0.0994 | 20 | -0.04
-0.0992 | 40 | -0.04
-0.099 | 56 | -0.04
-0.0988 | 76 | -0.08
-0.0986 | 80 | -0.08
-0.0984 | 96 | -0.04
-0.0982 | 96 | 0
-0.098 | 112 | -0.04
-0.0978 | 120 | -0.12
-0.0976 | 132 | -0.08
-0.0974 | 140 | -0.08
-0.0972 | 152 | -0.24
-0.097 | 152 | -1.92
-0.0968 | 148 | -1.84
-0.0966 | 160 | -1.84
-0.0964 | 164 | -1.16
-0.0962 | 160 | -0.88
-0.096 | 168 | -0.68
-0.0958 | 164 | -0.52
-0.0956 | 156 | -0.48
-0.0954 | 156 | -0.36
-0.0952 | 164 | -0.08
-0.095 | 160 | 0
-0.0948 | 164 | -0.04
-0.0946 | 160 | 0
-0.0944 | 152 | 0.12
-0.0942 | 160 | 0
-0.094 | 152 | 0.08
-0.0938 | 136 | 0
-0.0936 | 116 | 0.04
-0.0934 | 96 | 0.16
-0.0932 | 84 | 0.04
-0.093 | 76 | 0.08
-0.0928 | 64 | 0.04
-0.0926 | 60 | 0.04
-0.0924 | 52 | 0
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
