CalPlug/SparkyStrip/documents/senior design/ems/load_sig/recordedwaveforms/Appliances with Reference Voltage/TV.xlsx

Model | DPO3014
Firmware Version | 2.23
Waveform Type | Analog | Analog
Point Format | Y
Horizontal Units | s
Horizontal Scale | 0.02
Horizontal Delay | 0 | 0
Sample Interval | 0.0002
Record Length | 1000
Gating | 0.0% to 100.0% | 0.0% to 100.0%
Probe Attenuation | 10 | 10
Vertical Units | V | A
Vertical Offset | 0 | 0
Vertical Scale | 100 | 1
Vertical Position | 2 | -2
Label
TIME | CH1 | CH2
-0.1 | -4 | -0.36
-0.0998 | 0 | -0.32
-0.0996 | 16 | -0.48
-0.0994 | 32 | -0.4
-0.0992 | 44 | -1.16
-0.099 | 56 | -1.24
-0.0988 | 76 | -1.32
-0.0986 | 84 | -1.52
-0.0984 | 92 | -1.72
-0.0982 | 104 | -2.04
-0.098 | 108 | -2.28
-0.0978 | 124 | -2.8
-0.0976 | 132 | -3
-0.0974 | 144 | -2.95
-0.0972 | 152 | -2.9
-0.097 | 152 | -2.84
-0.0968 | 160 | -2.88
-0.0966 | 160 | -2.86
-0.0964 | 164 | -2.84
-0.0962 | 160 | -2.96
-0.096 | 164 | -2.96
-0.0958 | 160 | -2.92
-0.0956 | 168 | -2.84
-0.0954 | 160 | -2.76
-0.0952 | 164 | -2.8
-0.095 | 156 | -2.72
-0.0948 | 156 | -2.72
-0.0946 | 156 | -2.44
-0.0944 | 152 | -2.52
-0.0942 | 156 | -2.28
-0.094 | 148 | -1.4
-0.0938 | 120 | -1.04
-0.0936 | 108 | -0.6
-0.0934 | 92 | -0.24
-0.0932 | 84 | -0.16
-0.093 | 72 | -0.16
-0.0928 | 60 | 0.04
-0.0926 | 56 | 0.4
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
