CalPlug/SparkyStrip/documents/senior design/ems/load_sig/recordedwaveforms/Appliances/AglientTechOscilloscope50k.xlsx

Model | DPO3014
Firmware Version | 2.23
Waveform Type | Analog
Point Format | Y
Horizontal Units | s
Horizontal Scale | 0.02
Horizontal Delay | 0
Sample Interval | 2e-05
Record Length | 10000
Gating | 0.0% to 100.0%
Probe Attenuation | 1
Vertical Units | V
Vertical Offset | 0
Vertical Scale | 0.1
Vertical Position | 0
Label
TIME | CH1
-0.1 | -0.012
-0.09998 | -0.004
-0.09996 | -0.004
-0.09994 | 0.004
-0.09992 | 0.008
-0.0999 | 0.016
-0.09988 | 0.008
-0.09986 | 0.024
-0.09984 | 0.02
-0.09982 | 0.008
-0.0998 | -0.004
-0.09978 | -0.008
-0.09976 | -0.008
-0.09974 | -0.008
-0.09972 | -0.008
-0.0997 | 0.008
-0.09968 | 0.024
-0.09966 | 0.028
-0.09964 | 0.028
-0.09962 | 0.04
-0.0996 | 0.04
-0.09958 | 0.04
-0.09956 | 0.04
-0.09954 | 0.032
-0.09952 | 0.024
-0.0995 | 0.024
-0.09948 | 0.02
-0.09946 | 0.032
-0.09944 | 0.032
-0.09942 | 0.028
-0.0994 | 0.024
-0.09938 | 0.016
-0.09936 | 0.02
-0.09934 | 0.028
-0.09932 | 0.028
-0.0993 | 0.04
-0.09928 | 0.036
-0.09926 | 0.028
-0.09924 | 0.024
-0.09922 | 0.024
-0.0992 | 0.032
-0.09918 | 0.028
-0.09916 | 0.016
-0.09914 | 0.02
-0.09912 | 0.016
-0.0991 | 0.008
-0.09908 | 0.012
-0.09906 | 0.012
-0.09904 | 0.004
-0.09902 | 0
-0.099 | 0.004
-0.09898 | 0
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
