CalPlug/SparkyStrip/documents/senior design/ems/load_sig/recordedwaveforms/Appliances/DCPowerSource5k.xlsx

Model | DPO3014
Firmware Version | 2.23
Waveform Type | Analog
Point Format | Y
Horizontal Units | s
Horizontal Scale | 0.02
Horizontal Delay | 0
Sample Interval | 0.0002
Record Length | 1000
Gating | 0.0% to 100.0%
Probe Attenuation | 1
Vertical Units | V
Vertical Offset | 0
Vertical Scale | 0.05
Vertical Position | 0
Label
TIME | CH1
-0.1 | -0.01
-0.0998 | 0.004
-0.0996 | 0.014
-0.0994 | 0.022
-0.0992 | 0.032
-0.099 | 0.034
-0.0988 | 0.04
-0.0986 | 0.054
-0.0984 | 0.078
-0.0982 | 0.092
-0.098 | 0.104
-0.0978 | 0.124
-0.0976 | 0.128
-0.0974 | 0.124
-0.0972 | 0.116
-0.097 | 0.104
-0.0968 | 0.102
-0.0966 | 0.092
-0.0964 | 0.084
-0.0962 | 0.068
-0.096 | 0.068
-0.0958 | 0.074
-0.0956 | 0.076
-0.0954 | 0.082
-0.0952 | 0.094
-0.095 | 0.1
-0.0948 | 0.102
-0.0946 | 0.106
-0.0944 | 0.112
-0.0942 | 0.114
-0.094 | 0.118
-0.0938 | 0.12
-0.0936 | 0.126
-0.0934 | 0.122
-0.0932 | 0.12
-0.093 | 0.114
-0.0928 | 0.11
-0.0926 | 0.094
-0.0924 | 0.08
-0.0922 | 0.064
-0.092 | 0.04
-0.0918 | 0.026
-0.0916 | 0.008
-0.0914 | -0.004
-0.0912 | -0.008
-0.091 | -0.024
-0.0908 | -0.03
-0.0906 | -0.036
-0.0904 | -0.044
-0.0902 | -0.064
-0.09 | -0.086
-0.0898 | -0.106
-0.0896 | -0.124
-0.0894 | -0.132
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
