CalPlug/SparkyStrip/documents/senior design/ems/load_sig/recordedwaveforms/Appliances/FAN.xlsx

Model | DPO3014
Firmware Version | 2.23
Waveform Type | Analog
Point Format | Y
Horizontal Units | s
Horizontal Scale | 0.02
Horizontal Delay | 0
Sample Interval | 0.0002
Record Length | 1000
Gating | 0.0% to 100.0%
Probe Attenuation | 10
Vertical Units | A
Vertical Offset | 0
Vertical Scale | 5
Vertical Position | 0
Label
TIME | CH1
-0.1 | -1.2
-0.0998 | 0
-0.0996 | 0.8
-0.0994 | 0.4
-0.0992 | 1.6
-0.099 | 3
-0.0988 | 3.4
-0.0986 | 4.2
-0.0984 | 5.2
-0.0982 | 5.6
-0.098 | 6
-0.0978 | 6.2
-0.0976 | 7.4
-0.0974 | 8
-0.0972 | 8.6
-0.097 | 9.4
-0.0968 | 9.8
-0.0966 | 9.6
-0.0964 | 9.8
-0.0962 | 10
-0.096 | 10.4
-0.0958 | 9.8
-0.0956 | 9.6
-0.0954 | 10
-0.0952 | 9.6
-0.095 | 10
-0.0948 | 10
-0.0946 | 9.6
-0.0944 | 9.6
-0.0942 | 9.6
-0.094 | 9.2
-0.0938 | 9.2
-0.0936 | 8
-0.0934 | 6.8
-0.0932 | 6
-0.093 | 4.8
-0.0928 | 4.2
-0.0926 | 3.8
-0.0924 | 3.4
-0.0922 | 2.6
-0.092 | 1.8
-0.0918 | 1
-0.0916 | 0.4
-0.0914 | -0.2
-0.0912 | -0.6
-0.091 | -0.6
-0.0908 | -2.2
-0.0906 | -3
-0.0904 | -3.2
-0.0902 | -4.2
-0.09 | -5.4
-0.0898 | -5.8
-0.0896 | -6.4
-0.0894 | -6.8
-0.0892 | -7.4
-0.089 | -8.4
-0.0888 | -8.8
-0.0886 | -9.4
-0.0884 | -9.8
-0.0882 | -9.6
-0.088 | -9.6
-0.0878 | -10.2
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
