CalPlug/SparkyStrip/documents/senior design/ems/load_sig/recordedwaveforms/Appliances/HP.xlsx

Model | DPO3014
Firmware Version | 2.23
Waveform Type | Analog
Point Format | Y
Horizontal Units | s
Horizontal Scale | 0.02
Horizontal Delay | 0
Sample Interval | 0.0002
Record Length | 1000
Gating | 0.0% to 100.0%
Probe Attenuation | 10
Vertical Units | A
Vertical Offset | 0
Vertical Scale | 5
Vertical Position | 0
Label
TIME | CH1
-0.1 | -0.2
-0.0998 | -0.8
-0.0996 | -0.4
-0.0994 | 0
-0.0992 | 0
-0.099 | 0.4
-0.0988 | 0
-0.0986 | 0.2
-0.0984 | 0.4
-0.0982 | 0
-0.098 | 0.4
-0.0978 | 0
-0.0976 | 0.6
-0.0974 | 0
-0.0972 | 0
-0.097 | -0.2
-0.0968 | 0
-0.0966 | 0
-0.0964 | 0.2
-0.0962 | 0
-0.096 | 0.2
-0.0958 | 0
-0.0956 | -0.2
-0.0954 | 0.2
-0.0952 | 0
-0.095 | 0.2
-0.0948 | 0
-0.0946 | 0
-0.0944 | 0.2
-0.0942 | 0
-0.094 | 0
-0.0938 | 0.2
-0.0936 | 0.2
-0.0934 | 0
-0.0932 | 0.2
-0.093 | 0.2
-0.0928 | 1
-0.0926 | 5.4
-0.0924 | 3.4
-0.0922 | 5.8
-0.092 | 3.6
-0.0918 | 0.6
-0.0916 | 0.6
-0.0914 | 0.4
-0.0912 | 0.6
-0.091 | 0
-0.0908 | 0
-0.0906 | 0
-0.0904 | 0
-0.0902 | 0
-0.09 | 0.2
-0.0898 | 0
-0.0896 | -0.2
-0.0894 | 0
-0.0892 | 0
-0.089 | 0
-0.0888 | 0
-0.0886 | -0.2
-0.0884 | 0
-0.0882 | -0.2
-0.088 | -0.2
-0.0878 | -0.2
-0.0876 | 0
-0.0874 | 0
-0.0872 | 0
-0.087 | -0.2
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
