CalPlug/SparkyStrip/documents/senior design/ems/load_sig/recordedwaveforms/Appliances/Light_Bulb.xlsx

Model | DPO3014
Firmware Version | 2.23
Waveform Type | Analog
Point Format | Y
Horizontal Units | s
Horizontal Scale | 0.02
Horizontal Delay | 0
Sample Interval | 0.0002
Record Length | 1000
Gating | 0.0% to 100.0%
Probe Attenuation | 1
Vertical Units | V
Vertical Offset | 0
Vertical Scale | 0.1
Vertical Position | 0
Label
TIME | CH1
-0.1 | -0.008
-0.0998 | 0
-0.0996 | 0
-0.0994 | 0
-0.0992 | 0.004
-0.099 | 0.004
-0.0988 | 0.008
-0.0986 | 0.004
-0.0984 | 0
-0.0982 | 0.004
-0.098 | 0.004
-0.0978 | 0
-0.0976 | 0.004
-0.0974 | 0
-0.0972 | 0.008
-0.097 | 0.004
-0.0968 | 0
-0.0966 | 0.012
-0.0964 | 0
-0.0962 | 0.008
-0.096 | 0
-0.0958 | 0.008
-0.0956 | 0.008
-0.0954 | 0.008
-0.0952 | 0.008
-0.095 | 0.004
-0.0948 | 0.124
-0.0946 | 0.304
-0.0944 | 0.28
-0.0942 | 0.136
-0.094 | 0.22
-0.0938 | 0.124
-0.0936 | 0.088
-0.0934 | 0.072
-0.0932 | 0.064
-0.093 | 0.052
-0.0928 | 0.048
-0.0926 | 0.048
-0.0924 | 0.048
-0.0922 | 0.036
-0.092 | 0.028
-0.0918 | 0.032
-0.0916 | 0
-0.0914 | 0
-0.0912 | -0.004
-0.091 | 0
-0.0908 | -0.004
-0.0906 | -0.004
-0.0904 | -0.004
-0.0902 | 0
-0.09 | -0.004
-0.0898 | 0
-0.0896 | 0
-0.0894 | -0.004
-0.0892 | -0.008
-0.089 | -0.004
-0.0888 | -0.004
-0.0886 | -0.004
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
