CalPlug/SparkyStrip/documents/senior design/ems/load_sig/recordedwaveforms/Appliances/METERED_FAN.xlsx

Model | DPO3014
Firmware Version | 2.23
Waveform Type | Analog
Point Format | Y
Horizontal Units | s
Horizontal Scale | 0.02
Horizontal Delay | 0.006
Sample Interval | 0.0002
Record Length | 1000
Gating | 0.0% to 100.0%
Probe Attenuation | 10
Vertical Units | A
Vertical Offset | 0
Vertical Scale | 10
Vertical Position | 0
Label
TIME | CH1
-0.094 | 9.2
-0.0938 | 8.4
-0.0936 | 8
-0.0934 | 6.4
-0.0932 | 5.2
-0.093 | 5.2
-0.0928 | 4
-0.0926 | 2.8
-0.0924 | 3.6
-0.0922 | 2
-0.092 | 2
-0.0918 | 0
-0.0916 | 0.4
-0.0914 | -0.8
-0.0912 | -0.4
-0.091 | -0.4
-0.0908 | -1.6
-0.0906 | -3.6
-0.0904 | -4
-0.0902 | -4.8
-0.09 | -6.4
-0.0898 | -6.4
-0.0896 | -6.8
-0.0894 | -6.8
-0.0892 | -8.4
-0.089 | -8.8
-0.0888 | -8.8
-0.0886 | -10
-0.0884 | -10.8
-0.0882 | -10.4
-0.088 | -10.4
-0.0878 | -9.6
-0.0876 | -10.4
-0.0874 | -10
-0.0872 | -10
-0.087 | -10
-0.0868 | -10
-0.0866 | -10.4
-0.0864 | -10
-0.0862 | -9.2
-0.086 | -9.2
-0.0858 | -8.8
-0.0856 | -9.6
-0.0854 | -9.2
-0.0852 | -8.4
-0.085 | -6.4
-0.0848 | -5.6
-0.0846 | -4.4
-0.0844 | -4.4
-0.0842 | -4
-0.084 | -2.8
-0.0838 | -2.8
-0.0836 | -1.6
-0.0834 | -0.8
-0.0832 | -0.4
-0.083 | 0.4
-0.0828 | 0.4
-0.0826 | 0.8
-0.0824 | 2.4
-0.0822 | 4
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
