CalPlug/SparkyStrip/documents/senior design/ems/load_sig/recordedwaveforms/Appliances/TV.xlsx

Model | DPO3014
Firmware Version | 2.23
Waveform Type | Analog
Point Format | Y
Horizontal Units | s
Horizontal Scale | 0.02
Horizontal Delay | 0
Sample Interval | 0.0002
Record Length | 1000
Gating | 0.0% to 100.0%
Probe Attenuation | 10
Vertical Units | A
Vertical Offset | 0
Vertical Scale | 5
Vertical Position | 0
Label
TIME | CH1
-0.1 | -0.6
-0.0998 | -0.2
-0.0996 | -0.2
-0.0994 | -0.2
-0.0992 | 0.2
-0.099 | 0
-0.0988 | 0.2
-0.0986 | 0
-0.0984 | 0.4
-0.0982 | 0.2
-0.098 | 0.2
-0.0978 | 0.4
-0.0976 | 0.6
-0.0974 | 0.2
-0.0972 | 1
-0.097 | 1.4
-0.0968 | 1.4
-0.0966 | 1.6
-0.0964 | 1.6
-0.0962 | 2.2
-0.096 | 2.2
-0.0958 | 3
-0.0956 | 3
-0.0954 | 3
-0.0952 | 3
-0.095 | 3.2
-0.0948 | 3.2
-0.0946 | 2.8
-0.0944 | 3.2
-0.0942 | 3
-0.094 | 3
-0.0938 | 2.8
-0.0936 | 3
-0.0934 | 2.8
-0.0932 | 3.2
-0.093 | 3
-0.0928 | 2.4
-0.0926 | 2.4
-0.0924 | 2.8
-0.0922 | 1.8
-0.092 | 1
-0.0918 | 0.8
-0.0916 | 0.6
-0.0914 | 0.4
-0.0912 | 0.8
-0.091 | 0
-0.0908 | 0
-0.0906 | -0.2
-0.0904 | -0.2
-0.0902 | -0.2
-0.09 | -0.2
-0.0898 | 0.2
-0.0896 | 0
-0.0894 | -0.4
-0.0892 | -0.2
-0.089 | -0.6
-0.0888 | -0.8
-0.0886 | -1.2
-0.0884 | -1
-0.0882 | -1.8
-0.088 | -1.8
-0.0878 | -2
-0.0876 | -2.8
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
