CalPlug/SparkyStrip/documents/senior design/ems/load_sig/recordedwaveforms/Combined Appliances/HP+FAN.xlsx

Model | DPO3014
Firmware Version | 2.23
Waveform Type | Analog
Point Format | Y
Horizontal Units | s
Horizontal Scale | 0.02
Horizontal Delay | 0.006
Sample Interval | 0.0002
Record Length | 1000
Gating | 0.0% to 100.0%
Probe Attenuation | 10
Vertical Units | A
Vertical Offset | 0
Vertical Scale | 10
Vertical Position | 0
Label
TIME | CH1
-0.094 | 8.8
-0.0938 | 8
-0.0936 | 7.6
-0.0934 | 5.2
-0.0932 | 6
-0.093 | 4
-0.0928 | 3.6
-0.0926 | 3.6
-0.0924 | 2.8
-0.0922 | 2
-0.092 | 1.2
-0.0918 | 0.8
-0.0916 | 0.4
-0.0914 | 0
-0.0912 | -1.2
-0.091 | -1.2
-0.0908 | -2.8
-0.0906 | -2.4
-0.0904 | -4.4
-0.0902 | -5.2
-0.09 | -6.4
-0.0898 | -5.6
-0.0896 | -7.6
-0.0894 | -7.6
-0.0892 | -8
-0.089 | -7.6
-0.0888 | -8.8
-0.0886 | -10
-0.0884 | -10
-0.0882 | -12.4
-0.088 | -14
-0.0878 | -16.8
-0.0876 | -13.6
-0.0874 | -10.4
-0.0872 | -10
-0.087 | -10.4
-0.0868 | -9.6
-0.0866 | -10
-0.0864 | -9.2
-0.0862 | -10
-0.086 | -9.6
-0.0858 | -9.2
-0.0856 | -9.6
-0.0854 | -8.8
-0.0852 | -7.6
-0.085 | -6.4
-0.0848 | -5.6
-0.0846 | -4.4
-0.0844 | -4.4
-0.0842 | -4
-0.084 | -3.2
-0.0838 | -2.8
-0.0836 | -0.8
-0.0834 | -0.8
-0.0832 | 0
-0.083 | 0
-0.0828 | 0.4
-0.0826 | 0.4
-0.0824 | 3.2
-0.0822 | 3.2
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
