CalPlug/SparkyStrip/documents/senior design/ems/load_sig/recordedwaveforms/Combined Appliances/HP+TV+FAN.xlsx

Model | DPO3014
Firmware Version | 2.23
Waveform Type | Analog
Point Format | Y
Horizontal Units | s
Horizontal Scale | 0.02
Horizontal Delay | 0.006
Sample Interval | 0.0002
Record Length | 1000
Gating | 0.0% to 100.0%
Probe Attenuation | 10
Vertical Units | A
Vertical Offset | 0
Vertical Scale | 10
Vertical Position | 0
Label
TIME | CH1
-0.094 | 12
-0.0938 | 12.4
-0.0936 | 11.6
-0.0934 | 8.4
-0.0932 | 7.2
-0.093 | 5.6
-0.0928 | 4.8
-0.0926 | 4.4
-0.0924 | 2.8
-0.0922 | 2.4
-0.092 | 1.6
-0.0918 | 0.4
-0.0916 | 0.4
-0.0914 | -0.4
-0.0912 | -0.8
-0.091 | -1.2
-0.0908 | -1.2
-0.0906 | -3.2
-0.0904 | -3.2
-0.0902 | -4.4
-0.09 | -6
-0.0898 | -6.8
-0.0896 | -7.6
-0.0894 | -8
-0.0892 | -8.8
-0.089 | -10
-0.0888 | -11.2
-0.0886 | -12.8
-0.0884 | -12.8
-0.0882 | -12.8
-0.088 | -16.4
-0.0878 | -18
-0.0876 | -19.2
-0.0874 | -16
-0.0872 | -13.6
-0.087 | -14
-0.0868 | -13.6
-0.0866 | -13.6
-0.0864 | -12.4
-0.0862 | -13.2
-0.086 | -12.8
-0.0858 | -12
-0.0856 | -12
-0.0854 | -12.4
-0.0852 | -11.2
-0.085 | -8.8
-0.0848 | -7.2
-0.0846 | -6.4
-0.0844 | -6
-0.0842 | -4.4
-0.084 | -3.6
-0.0838 | -3.6
-0.0836 | -2
-0.0834 | -0.4
-0.0832 | -0.4
-0.083 | 0
-0.0828 | 0.4
-0.0826 | 0.4
-0.0824 | 0.8
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
