CalPlug/SparkyStrip/documents/senior design/ems/load_sig/recordedwaveforms/Combined Appliances/HP+TV.xlsx

Model | DPO3014
Firmware Version | 2.23
Waveform Type | Analog
Point Format | Y
Horizontal Units | s
Horizontal Scale | 0.02
Horizontal Delay | 0.006
Sample Interval | 0.0002
Record Length | 1000
Gating | 0.0% to 100.0%
Probe Attenuation | 10
Vertical Units | A
Vertical Offset | 0
Vertical Scale | 10
Vertical Position | 0
Label
TIME | CH1
-0.094 | 4
-0.0938 | 3.2
-0.0936 | 3.2
-0.0934 | 3.2
-0.0932 | 2.8
-0.093 | 2.4
-0.0928 | 2
-0.0926 | 2.4
-0.0924 | 2
-0.0922 | 1.6
-0.092 | 2
-0.0918 | 1.6
-0.0916 | 0.8
-0.0914 | 0.4
-0.0912 | -0.4
-0.091 | -0.4
-0.0908 | -0.4
-0.0906 | -0.4
-0.0904 | -0.4
-0.0902 | -1.2
-0.09 | -0.4
-0.0898 | -0.4
-0.0896 | -0.4
-0.0894 | -0.4
-0.0892 | -0.4
-0.089 | -0.4
-0.0888 | -0.4
-0.0886 | -1.2
-0.0884 | -1.2
-0.0882 | -2
-0.088 | -2
-0.0878 | -2.4
-0.0876 | -1.2
-0.0874 | -2.4
-0.0872 | -3.6
-0.087 | -3.2
-0.0868 | -3.6
-0.0866 | -3.6
-0.0864 | -5.6
-0.0862 | -8
-0.086 | -10.4
-0.0858 | -6.8
-0.0856 | -3.2
-0.0854 | -3.6
-0.0852 | -2.8
-0.085 | -3.2
-0.0848 | -3.2
-0.0846 | -3.2
-0.0844 | -2.4
-0.0842 | -3.6
-0.084 | -2.8
-0.0838 | -3.2
-0.0836 | -2.4
-0.0834 | -1.2
-0.0832 | -1.2
-0.083 | -0.8
-0.0828 | -0.8
-0.0826 | -0.8
-0.0824 | 0
-0.0822 | 0
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
