CalPlug/SparkyStrip/documents/senior design/ems/load_sig/recordedwaveforms/Combined Appliances/STB+FAN+HP+TV.xlsx

Model | DPO3014
Firmware Version | 2.23
Waveform Type | Analog
Point Format | Y
Horizontal Units | s
Horizontal Scale | 0.02
Horizontal Delay | 0.006
Sample Interval | 0.0002
Record Length | 1000
Gating | 0.0% to 100.0%
Probe Attenuation | 10
Vertical Units | A
Vertical Offset | 0
Vertical Scale | 10
Vertical Position | 0
Label
TIME | CH1
-0.094 | 10.8
-0.0938 | 11.6
-0.0936 | 9.6
-0.0934 | 7.2
-0.0932 | 6.8
-0.093 | 4.8
-0.0928 | 4.4
-0.0926 | 4
-0.0924 | 2.8
-0.0922 | 2.4
-0.092 | 2
-0.0918 | 0.4
-0.0916 | -0.4
-0.0914 | -0.4
-0.0912 | -0.8
-0.091 | -1.2
-0.0908 | -2.4
-0.0906 | -3.2
-0.0904 | -4.8
-0.0902 | -6
-0.09 | -6.8
-0.0898 | -7.6
-0.0896 | -8
-0.0894 | -8.4
-0.0892 | -10
-0.089 | -11.6
-0.0888 | -12
-0.0886 | -12.8
-0.0884 | -13.2
-0.0882 | -14.4
-0.088 | -16.8
-0.0878 | -22
-0.0876 | -20.8
-0.0874 | -16.4
-0.0872 | -15.2
-0.087 | -15.2
-0.0868 | -14.4
-0.0866 | -13.6
-0.0864 | -12.8
-0.0862 | -12.8
-0.086 | -12.4
-0.0858 | -12.8
-0.0856 | -12.8
-0.0854 | -12
-0.0852 | -9.2
-0.085 | -7.2
-0.0848 | -6.8
-0.0846 | -5.2
-0.0844 | -4.4
-0.0842 | -4.4
-0.084 | -3.2
-0.0838 | -2.4
-0.0836 | -2
-0.0834 | -0.4
-0.0832 | -0.4
-0.083 | 0
-0.0828 | 0.8
-0.0826 | 0.8
-0.0824 | 2
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
