CalPlug/SparkyStrip/documents/senior design/ems/load_sig/recordedwaveforms/Combined Appliances/STB+FAN.xlsx

Model | DPO3014
Firmware Version | 2.23
Waveform Type | Analog
Point Format | Y
Horizontal Units | s
Horizontal Scale | 0.02
Horizontal Delay | 0
Sample Interval | 0.0002
Record Length | 1000
Gating | 0.0% to 100.0%
Probe Attenuation | 10
Vertical Units | A
Vertical Offset | 0
Vertical Scale | 10
Vertical Position | 0
Label
TIME | CH1
-0.1 | -0.4
-0.0998 | 0
-0.0996 | 0.4
-0.0994 | 0.4
-0.0992 | 1.6
-0.099 | 2.8
-0.0988 | 2.4
-0.0986 | 4
-0.0984 | 5.2
-0.0982 | 6
-0.098 | 5.6
-0.0978 | 6
-0.0976 | 6.8
-0.0974 | 7.2
-0.0972 | 8
-0.097 | 9.2
-0.0968 | 9.2
-0.0966 | 10
-0.0964 | 10.8
-0.0962 | 11.6
-0.096 | 12.4
-0.0958 | 10.8
-0.0956 | 10.4
-0.0954 | 10.4
-0.0952 | 10.4
-0.095 | 9.6
-0.0948 | 9.6
-0.0946 | 10
-0.0944 | 9.6
-0.0942 | 8.8
-0.094 | 8.8
-0.0938 | 9.2
-0.0936 | 7.2
-0.0934 | 6
-0.0932 | 5.2
-0.093 | 4
-0.0928 | 3.6
-0.0926 | 2.8
-0.0924 | 3.2
-0.0922 | 1.6
-0.092 | 1.2
-0.0918 | 0.8
-0.0916 | 0
-0.0914 | -1.2
-0.0912 | -1.6
-0.091 | -1.2
-0.0908 | -2.8
-0.0906 | -2.8
-0.0904 | -4
-0.0902 | -4.4
-0.09 | -5.6
-0.0898 | -5.6
-0.0896 | -6.4
-0.0894 | -7.2
-0.0892 | -8
-0.089 | -8.4
-0.0888 | -9.2
-0.0886 | -9.2
-0.0884 | -10.8
-0.0882 | -10.8
-0.088 | -12
-0.0878 | -12.8
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
