CalPlug/SparkyStrip/documents/senior design/ems/load_sig/recordedwaveforms/Combined Appliances/STB+HP.xlsx

Model | DPO3014
Firmware Version | 2.23
Waveform Type | Analog
Point Format | Y
Horizontal Units | s
Horizontal Scale | 0.02
Horizontal Delay | 0.0054
Sample Interval | 0.0002
Record Length | 1000
Gating | 0.0% to 100.0%
Probe Attenuation | 10
Vertical Units | A
Vertical Offset | 0
Vertical Scale | 5
Vertical Position | 0
Label
TIME | CH1
-0.0946 | 0.2
-0.0944 | 0.4
-0.0942 | 0.2
-0.094 | 0.4
-0.0938 | 0.2
-0.0936 | 0
-0.0934 | 7
-0.0932 | 5.4
-0.093 | 7.2
-0.0928 | 7.4
-0.0926 | 3.6
-0.0924 | 2.4
-0.0922 | 2.2
-0.092 | 1.4
-0.0918 | 0.8
-0.0916 | 0
-0.0914 | 0
-0.0912 | 0
-0.091 | 0
-0.0908 | 0.2
-0.0906 | -0.2
-0.0904 | -0.4
-0.0902 | 0
-0.09 | 0
-0.0898 | 0
-0.0896 | 0
-0.0894 | 0
-0.0892 | -0.2
-0.089 | 0
-0.0888 | -0.2
-0.0886 | 0
-0.0884 | 0
-0.0882 | 0.2
-0.088 | 0
-0.0878 | 0
-0.0876 | -0.6
-0.0874 | -0.2
-0.0872 | -0.2
-0.087 | -0.4
-0.0868 | -0.4
-0.0866 | -0.2
-0.0864 | -0.2
-0.0862 | 0
-0.086 | 0
-0.0858 | -0.2
-0.0856 | -0.2
-0.0854 | 0.4
-0.0852 | -0.4
-0.085 | -5.4
-0.0848 | -5
-0.0846 | -8.2
-0.0844 | -6.4
-0.0842 | -2.8
-0.084 | -1.8
-0.0838 | -1.8
-0.0836 | -1.4
-0.0834 | -0.6
-0.0832 | 0
-0.083 | 0
-0.0828 | 0
-0.0826 | 0
-0.0824 | 0
-0.0822 | 0.2
-0.082 | 0.2
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
