CalPlug/SparkyStrip/documents/senior design/ems/load_sig/recordedwaveforms/Combined Appliances/TV+FAN.xlsx

Model | DPO3014
Firmware Version | 2.23
Waveform Type | Analog
Point Format | Y
Horizontal Units | s
Horizontal Scale | 0.02
Horizontal Delay | 0.006
Sample Interval | 0.0002
Record Length | 1000
Gating | 0.0% to 100.0%
Probe Attenuation | 10
Vertical Units | A
Vertical Offset | 0
Vertical Scale | 10
Vertical Position | 0
Label
TIME | CH1
-0.094 | 10.8
-0.0938 | 11.6
-0.0936 | 10.4
-0.0934 | 9.2
-0.0932 | 7.2
-0.093 | 6
-0.0928 | 4.4
-0.0926 | 3.6
-0.0924 | 3.6
-0.0922 | 2.4
-0.092 | 1.6
-0.0918 | 0.8
-0.0916 | 0
-0.0914 | 0
-0.0912 | -0.4
-0.091 | -0.8
-0.0908 | -1.2
-0.0906 | -2.8
-0.0904 | -3.2
-0.0902 | -5.2
-0.09 | -6.8
-0.0898 | -7.2
-0.0896 | -8
-0.0894 | -7.6
-0.0892 | -9.6
-0.089 | -10.4
-0.0888 | -11.2
-0.0886 | -12
-0.0884 | -12.8
-0.0882 | -12.8
-0.088 | -12.4
-0.0878 | -13.2
-0.0876 | -13.2
-0.0874 | -13.2
-0.0872 | -13.2
-0.087 | -12.4
-0.0868 | -13.2
-0.0866 | -13.6
-0.0864 | -12.8
-0.0862 | -13.2
-0.086 | -12.8
-0.0858 | -12.8
-0.0856 | -11.6
-0.0854 | -11.6
-0.0852 | -10.4
-0.085 | -8
-0.0848 | -7.2
-0.0846 | -6
-0.0844 | -5.2
-0.0842 | -4.4
-0.084 | -3.2
-0.0838 | -3.2
-0.0836 | -2.4
-0.0834 | -1.2
-0.0832 | -0.8
-0.083 | 0
-0.0828 | 0.8
-0.0826 | 0.4
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
