CalPlug/SparkyStrip/documents/senior design/ems/load_sig/recordedwaveforms/Different Computers/Dell.xlsx

Model | DPO3014
Firmware Version | 2.23
Waveform Type | Analog
Point Format | Y
Horizontal Units | s
Horizontal Scale | 0.02
Horizontal Delay | 0
Sample Interval | 2e-05
Record Length | 10000
Gating | 0.0% to 100.0%
Probe Attenuation | 1
Vertical Units | V
Vertical Offset | 0
Vertical Scale | 2
Vertical Position | 0
Label
TIME | CH1
-0.1 | -0.16
-0.09998 | -0.08
-0.09996 | -0.08
-0.09994 | 0
-0.09992 | 0
-0.0999 | 0
-0.09988 | 0
-0.09986 | 0.08
-0.09984 | 0.08
-0.09982 | 0.16
-0.0998 | -0.8
-0.09978 | -1.6
-0.09976 | -0.64
-0.09974 | -1.12
-0.09972 | -0.96
-0.0997 | -0.64
-0.09968 | 0
-0.09966 | 0.56
-0.09964 | 0.88
-0.09962 | 0.64
-0.0996 | 0.64
-0.09958 | 0.8
-0.09956 | 1.28
-0.09954 | 1.04
-0.09952 | 1.52
-0.0995 | 1.6
-0.09948 | 1.76
-0.09946 | 0.08
-0.09944 | -0.08
-0.09942 | 0.24
-0.0994 | 0.48
-0.09938 | 0.56
-0.09936 | 0.56
-0.09934 | 0.8
-0.09932 | 0.48
-0.0993 | 0.56
-0.09928 | 0.4
-0.09926 | 0.72
-0.09924 | 0.8
-0.09922 | 0.72
-0.0992 | 0.56
-0.09918 | 0.56
-0.09916 | 0.88
-0.09914 | 0.88
-0.09912 | 1.04
-0.0991 | 0.96
-0.09908 | 0.96
-0.09906 | 0.88
-0.09904 | 1.04
-0.09902 | 1.04
-0.099 | 0.88
-0.09898 | 1.12
-0.09896 | 1.04
-0.09894 | 1.12
-0.09892 | 1.12
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
