CalPlug/SparkyStrip/documents/senior design/ems/load_sig/recordedwaveforms/Different Computers/Lenovo.xlsx

Model | DPO3014
Firmware Version | 2.23
Waveform Type | Analog
Point Format | Y
Horizontal Units | s
Horizontal Scale | 0.02
Horizontal Delay | 0
Sample Interval | 2e-05
Record Length | 10000
Gating | 0.0% to 100.0%
Probe Attenuation | 1
Vertical Units | V
Vertical Offset | 0
Vertical Scale | 2
Vertical Position | 0
Label
TIME | CH1
-0.1 | 0
-0.09998 | 0
-0.09996 | 0
-0.09994 | -0.08
-0.09992 | -0.08
-0.0999 | -0.08
-0.09988 | 0
-0.09986 | 0
-0.09984 | 0
-0.09982 | 0
-0.0998 | -0.08
-0.09978 | 0
-0.09976 | -0.08
-0.09974 | 0
-0.09972 | 0
-0.0997 | 0.08
-0.09968 | 0
-0.09966 | 0.08
-0.09964 | 0
-0.09962 | -0.08
-0.0996 | 0
-0.09958 | 0
-0.09956 | 0
-0.09954 | 0
-0.09952 | 0
-0.0995 | 0
-0.09948 | 0
-0.09946 | 0
-0.09944 | 0
-0.09942 | 0
-0.0994 | 0
-0.09938 | 0
-0.09936 | 0.08
-0.09934 | 0
-0.09932 | 0
-0.0993 | 0
-0.09928 | 0
-0.09926 | 0
-0.09924 | 0
-0.09922 | 0
-0.0992 | -0.08
-0.09918 | 0
-0.09916 | 0
-0.09914 | 0
-0.09912 | 0
-0.0991 | 0.08
-0.09908 | 0
-0.09906 | 0
-0.09904 | 0
-0.09902 | -0.08
-0.099 | 0.08
-0.09898 | -0.08
-0.09896 | 0
-0.09894 | 0
-0.09892 | 0
-0.0989 | 0
-0.09888 | -0.08
-0.09886 | 0.08
-0.09884 | 0.08
-0.09882 | 0.08
-0.0988 | 0
-0.09878 | 0
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
