CalPlug/SparkyStrip/documents/senior design/ems/load_sig/recordedwaveforms/Multiple Fans/one_Fan1000Samples.xlsx

Model | DPO3014
Firmware Version | 2.23
Waveform Type | Analog
Point Format | Y
Horizontal Units | s
Horizontal Scale | 0.02
Horizontal Delay | 0
Sample Interval | 0.0002
Record Length | 1000
Gating | 0.0% to 100.0%
Probe Attenuation | 1
Vertical Units | A
Vertical Offset | 0
Vertical Scale | 1
Vertical Position | -0.04
Label
TIME | CH1
-0.1 | -0.12
-0.0998 | 0.04
-0.0996 | 0.04
-0.0994 | 0.08
-0.0992 | 0.04
-0.099 | 0.24
-0.0988 | 0.32
-0.0986 | 0.44
-0.0984 | 0.48
-0.0982 | 0.56
-0.098 | 0.64
-0.0978 | 0.64
-0.0976 | 0.68
-0.0974 | 0.76
-0.0972 | 0.84
-0.097 | 0.88
-0.0968 | 0.96
-0.0966 | 0.92
-0.0964 | 0.92
-0.0962 | 0.92
-0.096 | 0.84
-0.0958 | 0.92
-0.0956 | 0.96
-0.0954 | 0.88
-0.0952 | 0.92
-0.095 | 0.92
-0.0948 | 0.88
-0.0946 | 0.88
-0.0944 | 0.84
-0.0942 | 0.8
-0.094 | 0.88
-0.0938 | 0.84
-0.0936 | 0.72
-0.0934 | 0.6
-0.0932 | 0.56
-0.093 | 0.44
-0.0928 | 0.36
-0.0926 | 0.32
-0.0924 | 0.24
-0.0922 | 0.16
-0.092 | 0.12
-0.0918 | 0.08
-0.0916 | -0.08
-0.0914 | -0.04
-0.0912 | -0.16
-0.091 | -0.12
-0.0908 | -0.16
-0.0906 | -0.36
-0.0904 | -0.44
-0.0902 | -0.52
-0.09 | -0.6
-0.0898 | -0.64
-0.0896 | -0.72
-0.0894 | -0.72
-0.0892 | -0.72
-0.089 | -0.84
-0.0888 | -0.92
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
