CalPlug/SparkyStrip/documents/senior design/ems/load_sig/recordedwaveforms/Multiple Fans/three_Fans1000Samples.xlsx

Model | DPO3014
Firmware Version | 2.23
Waveform Type | Analog
Point Format | Y
Horizontal Units | s
Horizontal Scale | 0.02
Horizontal Delay | 0
Sample Interval | 0.0002
Record Length | 1000
Gating | 0.0% to 100.0%
Probe Attenuation | 1
Vertical Units | A
Vertical Offset | 0
Vertical Scale | 1
Vertical Position | -0.04
Label
TIME | CH1
-0.1 | 0
-0.0998 | 0.24
-0.0996 | 0.36
-0.0994 | 0.2
-0.0992 | 0.84
-0.099 | 1.08
-0.0988 | 1.28
-0.0986 | 1.6
-0.0984 | 1.68
-0.0982 | 1.84
-0.098 | 1.96
-0.0978 | 2
-0.0976 | 2.32
-0.0974 | 2.6
-0.0972 | 2.64
-0.097 | 2.88
-0.0968 | 2.84
-0.0966 | 2.92
-0.0964 | 2.92
-0.0962 | 2.92
-0.096 | 2.96
-0.0958 | 2.96
-0.0956 | 2.88
-0.0954 | 2.88
-0.0952 | 2.8
-0.095 | 2.84
-0.0948 | 2.8
-0.0946 | 2.72
-0.0944 | 2.68
-0.0942 | 2.64
-0.094 | 2.6
-0.0938 | 2.52
-0.0936 | 2.04
-0.0934 | 1.68
-0.0932 | 1.44
-0.093 | 1.28
-0.0928 | 1.04
-0.0926 | 0.92
-0.0924 | 0.76
-0.0922 | 0.6
-0.092 | 0.36
-0.0918 | 0.08
-0.0916 | -0.12
-0.0914 | -0.32
-0.0912 | -0.4
-0.091 | -0.48
-0.0908 | -0.92
-0.0906 | -1.2
-0.0904 | -1.44
-0.0902 | -1.68
-0.09 | -1.8
-0.0898 | -2
-0.0896 | -2.04
-0.0894 | -2.16
-0.0892 | -2.44
-0.089 | -2.6
-0.0888 | -2.64
-0.0886 | -2.84
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
