CalPlug/SparkyStrip/documents/senior design/ems/load_sig/recordedwaveforms/Multiple Fans/two_Fans.xlsx

Model | DPO3014
Firmware Version | 2.23
Waveform Type | Analog
Point Format | Y
Horizontal Units | s
Horizontal Scale | 0.01
Horizontal Delay | 0
Sample Interval | 1e-05
Record Length | 10000
Gating | 0.0% to 100.0%
Probe Attenuation | 1
Vertical Units | A
Vertical Offset | 0
Vertical Scale | 1
Vertical Position | -0.04
Label
TIME | CH1
-0.05 | -0.08
-0.04999 | -0.08
-0.04998 | -0.04
-0.04997 | 0
-0.04996 | -0.08
-0.04995 | -0.12
-0.04994 | -0.04
-0.04993 | 0
-0.04992 | -0.08
-0.04991 | 0
-0.0499 | 0
-0.04989 | 0
-0.04988 | 0.04
-0.04987 | 0
-0.04986 | 0
-0.04985 | 0
-0.04984 | 0
-0.04983 | 0.04
-0.04982 | 0.04
-0.04981 | 0.04
-0.0498 | 0.04
-0.04979 | 0.08
-0.04978 | 0.04
-0.04977 | 0.12
-0.04976 | 0.08
-0.04975 | 0.04
-0.04974 | 0.04
-0.04973 | 0.08
-0.04972 | 0.08
-0.04971 | 0.04
-0.0497 | 0.12
-0.04969 | 0.12
-0.04968 | 0.12
-0.04967 | 0.16
-0.04966 | 0.12
-0.04965 | 0.04
-0.04964 | 0.08
-0.04963 | 0.08
-0.04962 | 0.24
-0.04961 | 0.12
-0.0496 | 0.2
-0.04959 | 0.16
-0.04958 | 0.2
-0.04957 | 0.12
-0.04956 | 0.16
-0.04955 | 0.2
-0.04954 | 0.2
-0.04953 | 0.2
-0.04952 | 0.16
-0.04951 | 0.2
-0.0495 | 0.24
-0.04949 | 0.2
-0.04948 | 0.2
-0.04947 | 0.16
-0.04946 | 0.24
-0.04945 | 0.28
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
