CalPlug/SparkyStrip/documents/senior design/ems/load_sig/recordedwaveforms/Multiple Fans/two_Fans1000Samples.xlsx

Model | DPO3014
Firmware Version | 2.23
Waveform Type | Analog
Point Format | Y
Horizontal Units | s
Horizontal Scale | 0.02
Horizontal Delay | 0
Sample Interval | 0.0002
Record Length | 1000
Gating | 0.0% to 100.0%
Probe Attenuation | 1
Vertical Units | A
Vertical Offset | 0
Vertical Scale | 1
Vertical Position | -0.04
Label
TIME | CH1
-0.1 | 0.04
-0.0998 | 0.12
-0.0996 | 0.2
-0.0994 | 0.2
-0.0992 | 0.36
-0.099 | 0.68
-0.0988 | 0.84
-0.0986 | 0.88
-0.0984 | 1.16
-0.0982 | 1.2
-0.098 | 1.24
-0.0978 | 1.36
-0.0976 | 1.44
-0.0974 | 1.64
-0.0972 | 1.84
-0.097 | 1.8
-0.0968 | 1.88
-0.0966 | 1.92
-0.0964 | 1.92
-0.0962 | 1.96
-0.096 | 1.96
-0.0958 | 1.92
-0.0956 | 1.88
-0.0954 | 1.88
-0.0952 | 1.84
-0.095 | 1.92
-0.0948 | 1.84
-0.0946 | 1.84
-0.0944 | 1.84
-0.0942 | 1.72
-0.094 | 1.68
-0.0938 | 1.68
-0.0936 | 1.36
-0.0934 | 1.2
-0.0932 | 1
-0.093 | 0.84
-0.0928 | 0.64
-0.0926 | 0.6
-0.0924 | 0.44
-0.0922 | 0.36
-0.092 | 0.24
-0.0918 | 0.04
-0.0916 | -0.04
-0.0914 | -0.24
-0.0912 | -0.32
-0.091 | -0.2
-0.0908 | -0.6
-0.0906 | -0.8
-0.0904 | -0.92
-0.0902 | -1.08
-0.09 | -1.2
-0.0898 | -1.24
-0.0896 | -1.4
-0.0894 | -1.44
-0.0892 | -1.6
-0.089 | -1.72
-0.0888 | -1.88
-0.0886 | -2
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
