CalPlug/SparkyStrip/documents/CIEEmobile/comingsoon.jpg

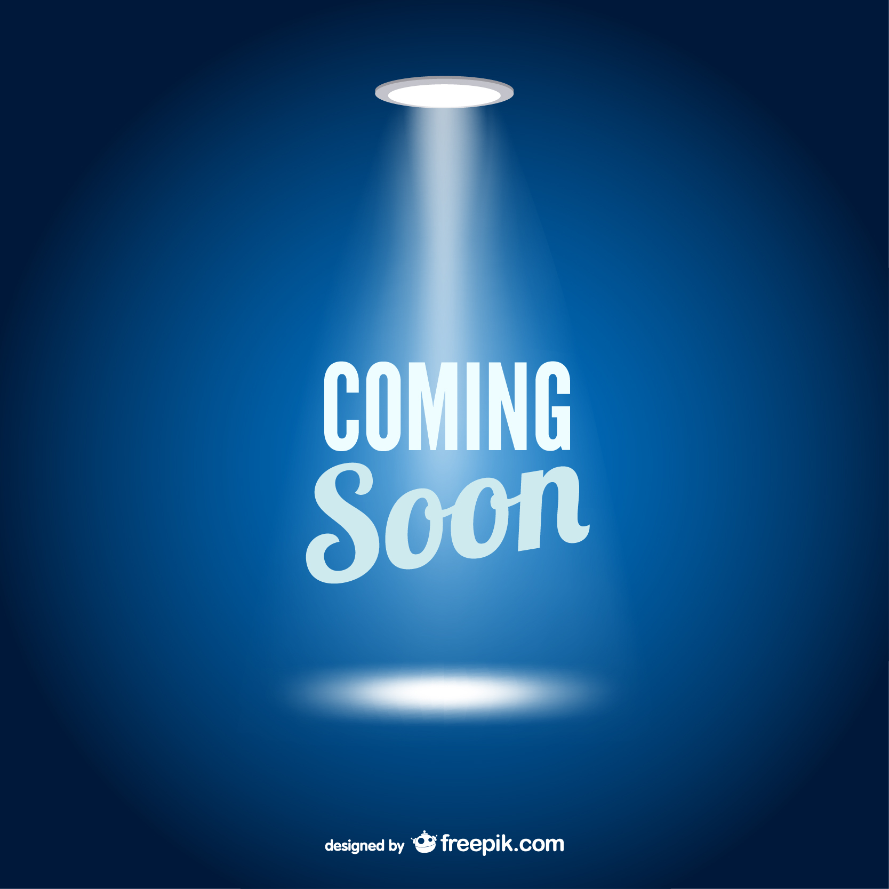
documents/CIEEmobile/comingsoon.jpg
