CalPlug/SparkyStrip/documents/CIEEmobile/Screen Shot 2014-08-29 at 5.15.17 PM.png

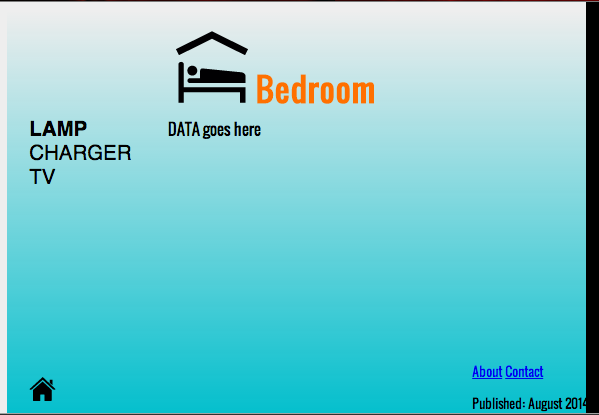
documents/CIEEmobile/Screen Shot 2014-08-29 at 5.15.17 PM.png
