CalPlug/SparkyStrip/documents/CIEEmobile/Screen Shot 2014-08-29 at 11.44.13 AM.png

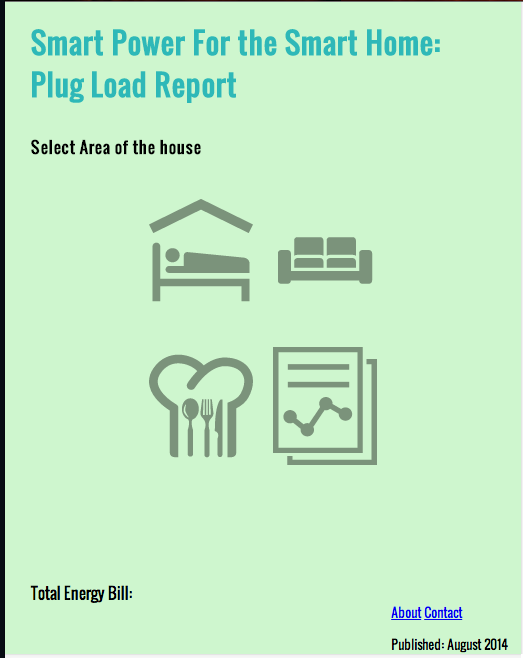
documents/CIEEmobile/Screen Shot 2014-08-29 at 11.44.13 AM.png
