CalPlug/SparkyStrip/documents/Fall 2015 Senior Design/IMG_1045.JPG

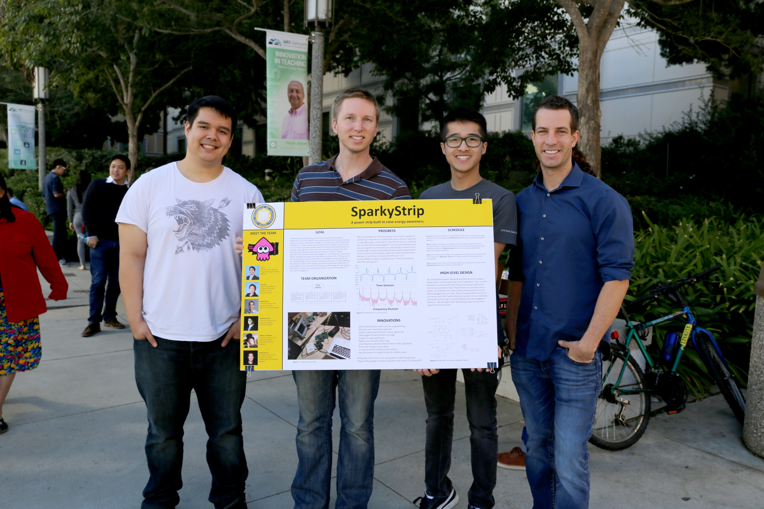
documents/Fall 2015 Senior Design/IMG_1045.JPG
