CalPlug/SparkyStrip/documents/pcb/Photo Dec 09, 3 09 54 PM.jpg

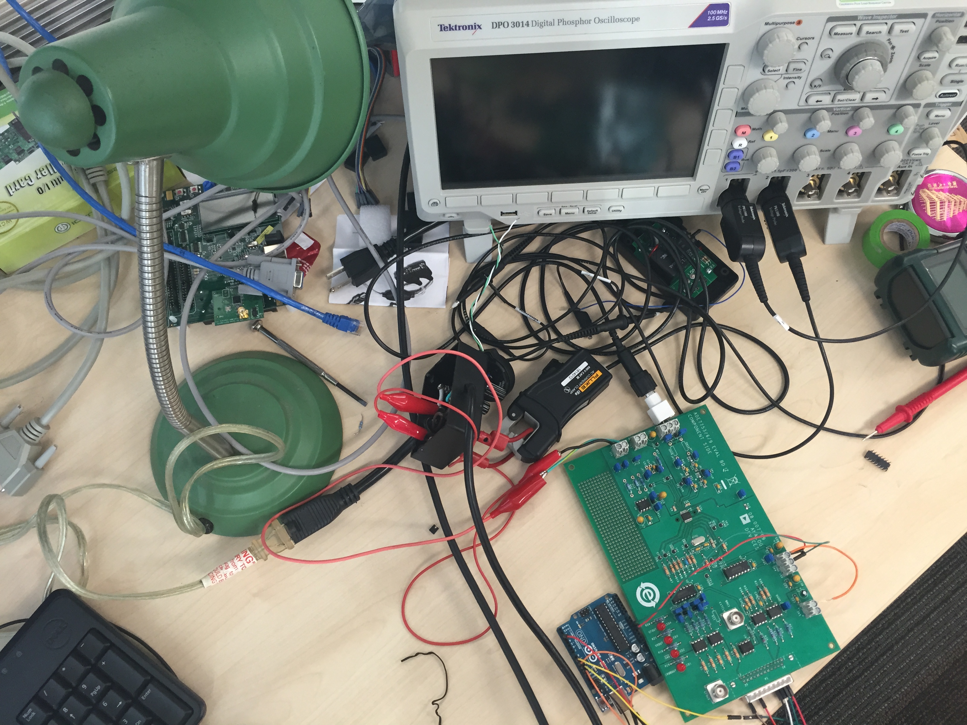
documents/pcb/Photo Dec 09, 3 09 54 PM.jpg
