CalPlug/SparkyStrip/documents/pcb/Photo Dec 09, 3 10 20 PM.jpg

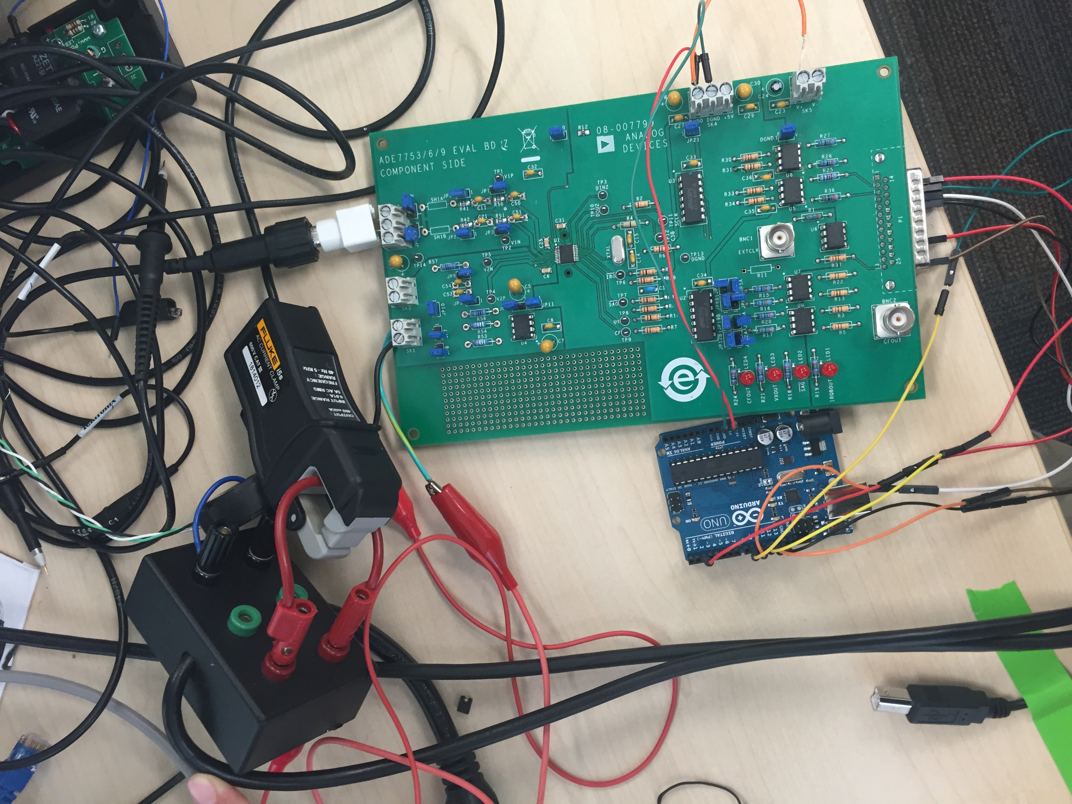
documents/pcb/Photo Dec 09, 3 10 20 PM.jpg
