CalPlug/SparkyStrip/documents/pcb/schematic.jpg

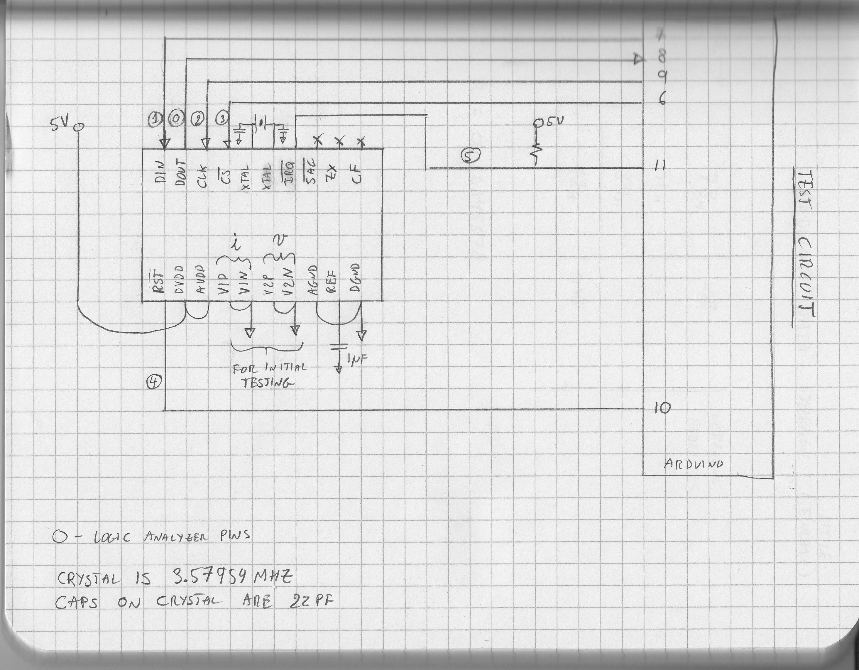
documents/pcb/schematic.jpg
