CalPlug/SparkyStrip/documents/senior design/ems/2014_Senior_Design_IHEI/Average App Rating.key/Data/photo-small.jpg

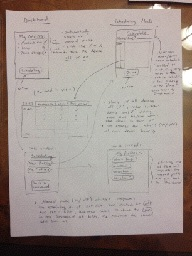
documents/senior design/ems/2014_Senior_Design_IHEI/Average App Rating.key/Data/photo-small.jpg
