CalPlug/SparkyStrip/documents/senior design/ems/2014_Senior_Design_IHEI/Average App Rating.key/Data/st0-1.jpg

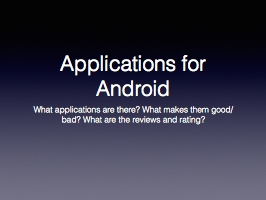
documents/senior design/ems/2014_Senior_Design_IHEI/Average App Rating.key/Data/st0-1.jpg
