CalPlug/SparkyStrip/documents/senior design/ems/2014_Senior_Design_IHEI/Average App Rating.key/Data/st3.jpg

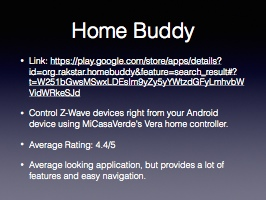
documents/senior design/ems/2014_Senior_Design_IHEI/Average App Rating.key/Data/st3.jpg
