CalPlug/SparkyStrip/documents/senior design/ems/2014_Senior_Design_IHEI/Average App Rating.key/preview-web.jpg

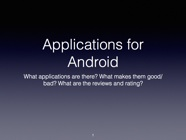
documents/senior design/ems/2014_Senior_Design_IHEI/Average App Rating.key/preview-web.jpg
