CalPlug/SparkyStrip/documents/senior design/ems/load_sig/.picasaoriginals/IMG_20120817_105337.jpg

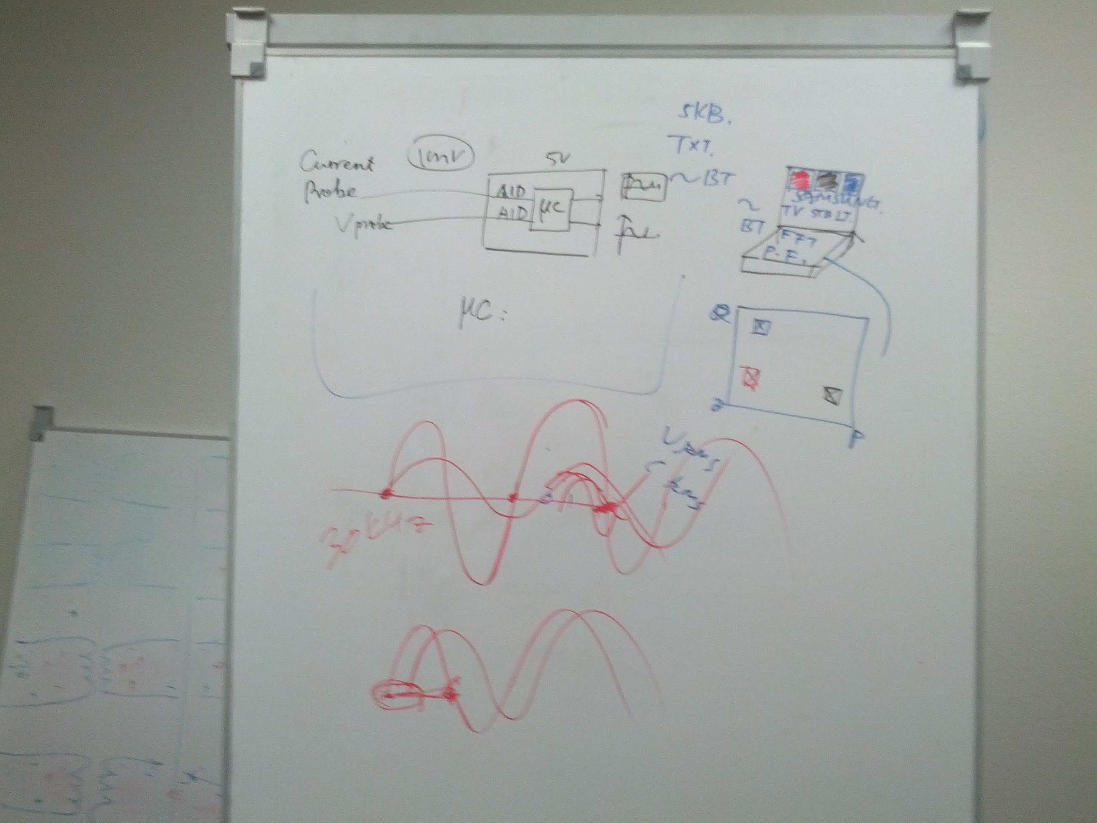
documents/senior design/ems/load_sig/.picasaoriginals/IMG_20120817_105337.jpg
