CalPlug/SparkyStrip/documents/senior design/ems/load_sig/displays/display1/data/acer.jpg

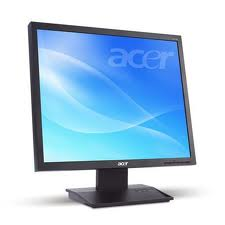
documents/senior design/ems/load_sig/displays/display1/data/acer.jpg
