CalPlug/SparkyStrip/documents/senior design/ems/load_sig/displays/display1/data/FRIDGE.jpg

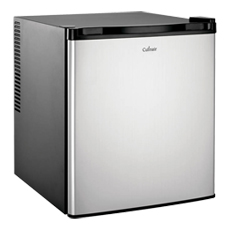
documents/senior design/ems/load_sig/displays/display1/data/FRIDGE.jpg
