CalPlug/SparkyStrip/documents/senior design/ems/load_sig/displays/display1/data/HP_Laptop.jpg

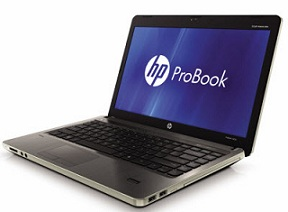
documents/senior design/ems/load_sig/displays/display1/data/HP_Laptop.jpg
