CalPlug/SparkyStrip/documents/senior design/ems/load_sig/displays/display1/data/lamp.jpg

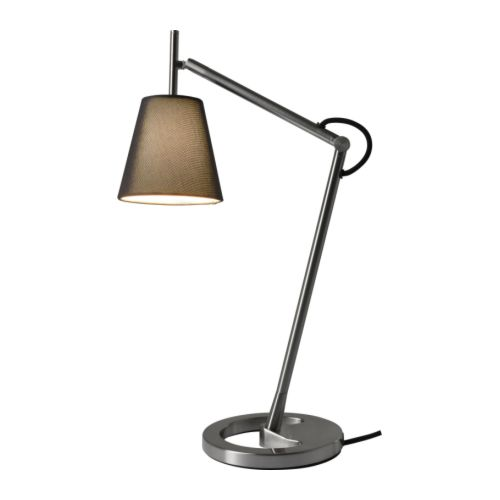
documents/senior design/ems/load_sig/displays/display1/data/lamp.jpg
