CalPlug/SparkyStrip/documents/senior design/ems/load_sig/displays/display1/data/Question_mark.PNG

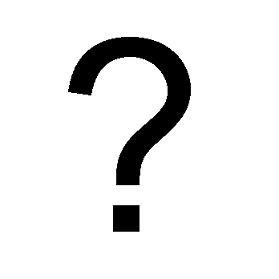
documents/senior design/ems/load_sig/displays/display1/data/Question_mark.PNG
