CalPlug/SparkyStrip/documents/senior design/ems/load_sig/displays/display1/data/Set_Top_Box.jpg

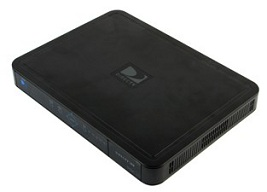
documents/senior design/ems/load_sig/displays/display1/data/Set_Top_Box.jpg
