CalPlug/SparkyStrip/documents/senior design/ems/load_sig/displays/display1/data/Sharp_TV.jpg

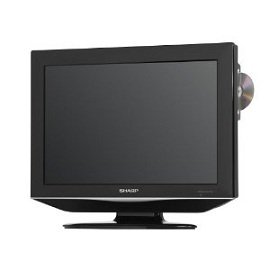
documents/senior design/ems/load_sig/displays/display1/data/Sharp_TV.jpg
