CalPlug/SparkyStrip/documents/senior design/ems/load_sig/displays/display1/data/toaster.jpg

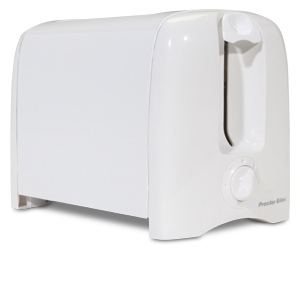
documents/senior design/ems/load_sig/displays/display1/data/toaster.jpg
