CalPlug/SparkyStrip/documents/senior design/ems/load_sig/displays/display1/data/Vornado_Foot_Fan.jpg

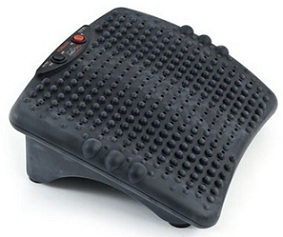
documents/senior design/ems/load_sig/displays/display1/data/Vornado_Foot_Fan.jpg
