CalPlug/SparkyStrip/documents/senior design/ems/load_sig/displays/Display2/data/circuitboardart.jpg

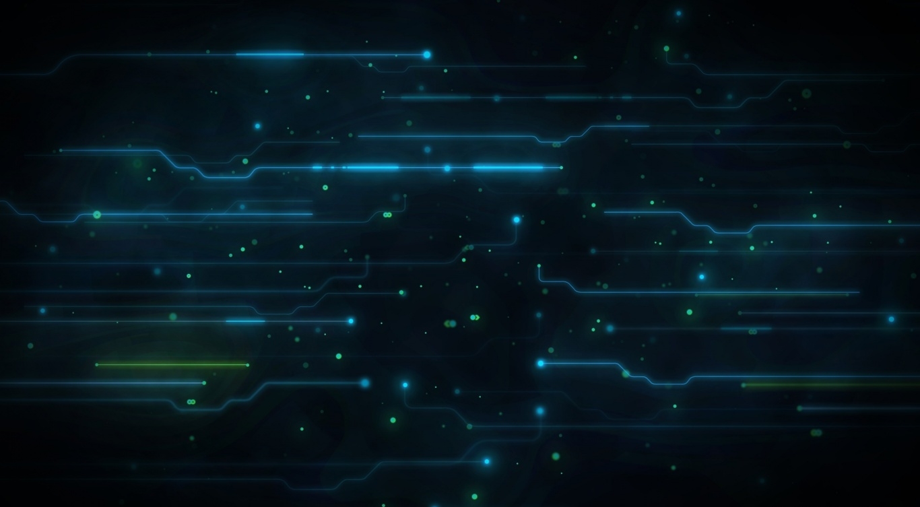
documents/senior design/ems/load_sig/displays/Display2/data/circuitboardart.jpg
