CalPlug/SparkyStrip/documents/senior design/ems/load_sig/displays/Display2/data/questionmark1.png

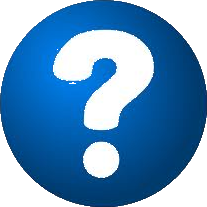
documents/senior design/ems/load_sig/displays/Display2/data/questionmark1.png
