CalPlug/SparkyStrip/documents/team meeting and presentations/01162015/Photo Jan 16, 5 27 43 PM.jpg

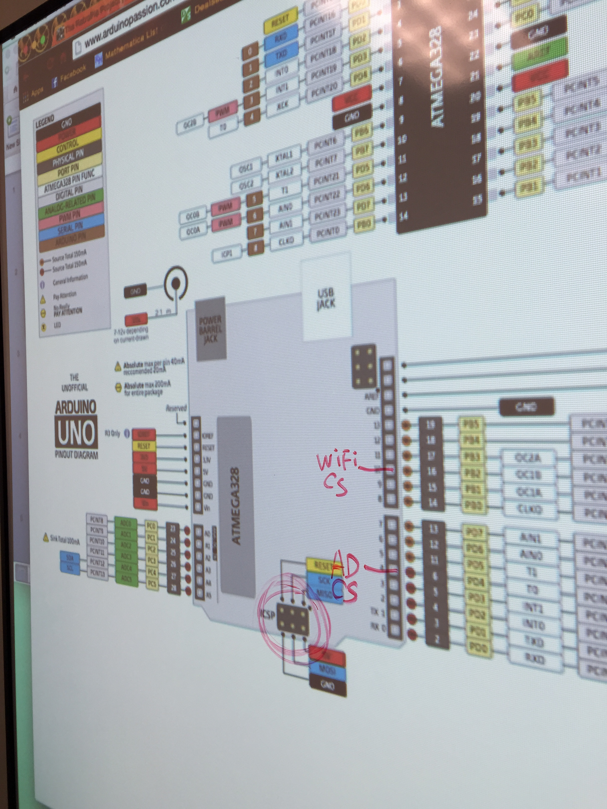
documents/team meeting and presentations/01162015/Photo Jan 16, 5 27 43 PM.jpg
