CalPlug/SparkyStrip/documents/team meeting and presentations/01162015/Photo Jan 16, 5 57 36 PM.jpg

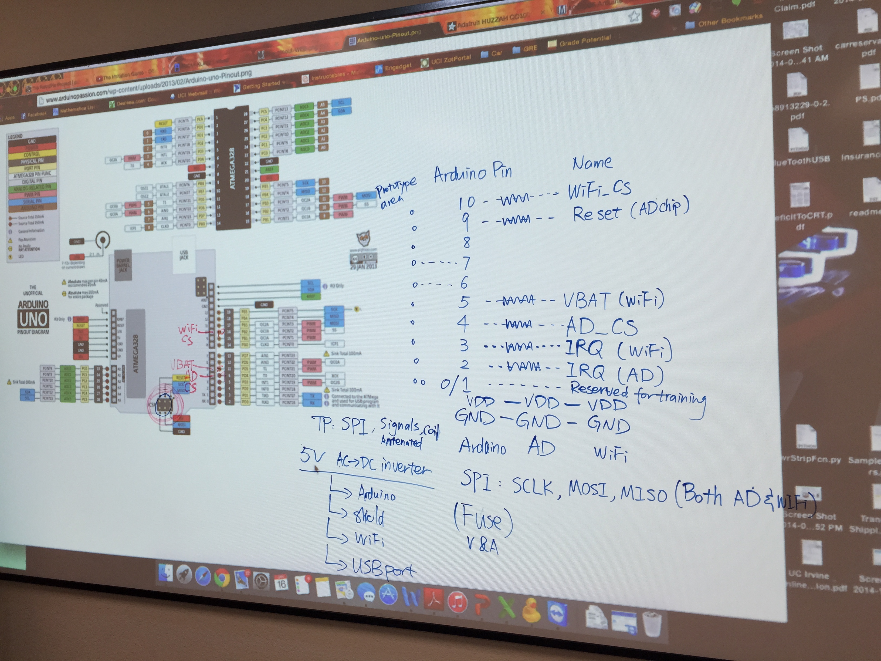
documents/team meeting and presentations/01162015/Photo Jan 16, 5 57 36 PM.jpg
