CalPlug/SparkyStrip/documents/team meeting and presentations/01162015/Photo Jan 16, 6 32 30 PM.jpg

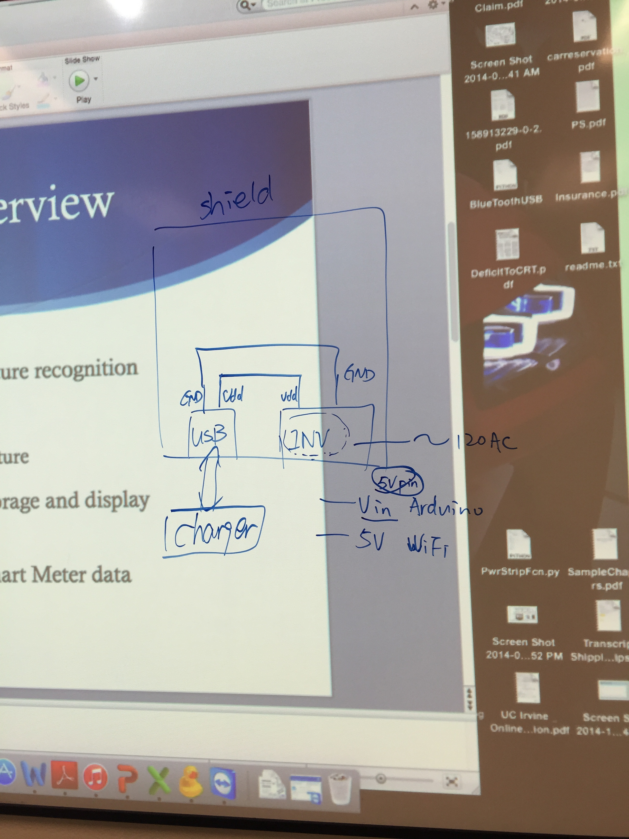
documents/team meeting and presentations/01162015/Photo Jan 16, 6 32 30 PM.jpg
