CalPlug/SparkyStrip/documents/team meeting and presentations/07072014/Photo Jul 07, 2 32 52 PM.jpg

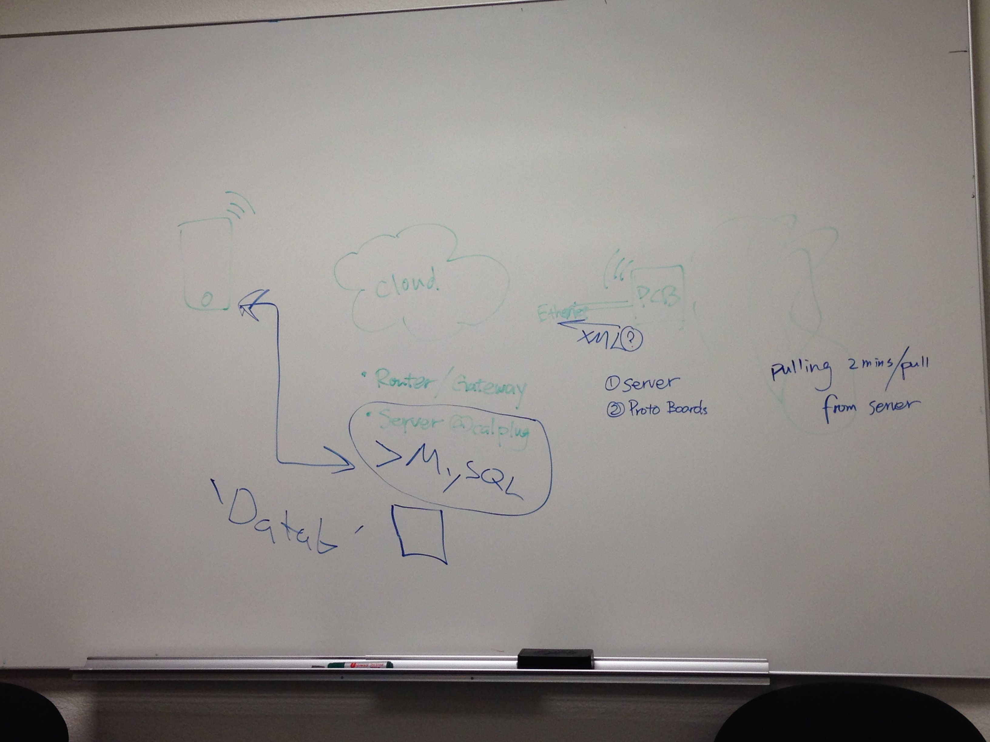
documents/team meeting and presentations/07072014/Photo Jul 07, 2 32 52 PM.jpg
