CalPlug/SparkyStrip/documents/team meeting and presentations/Photo Aug 25, 5 32 19 PM.jpg

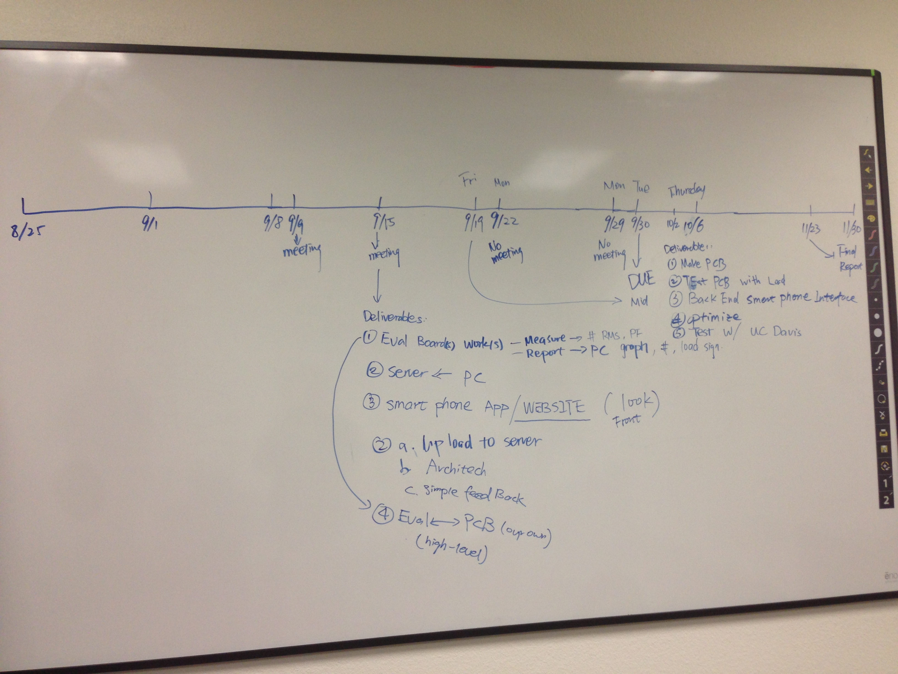
documents/team meeting and presentations/Photo Aug 25, 5 32 19 PM.jpg
