CalPlug/SparkyStrip/documents/team meeting and presentations/Screen Shot 2015-01-20 at 4.02.00 PM.png

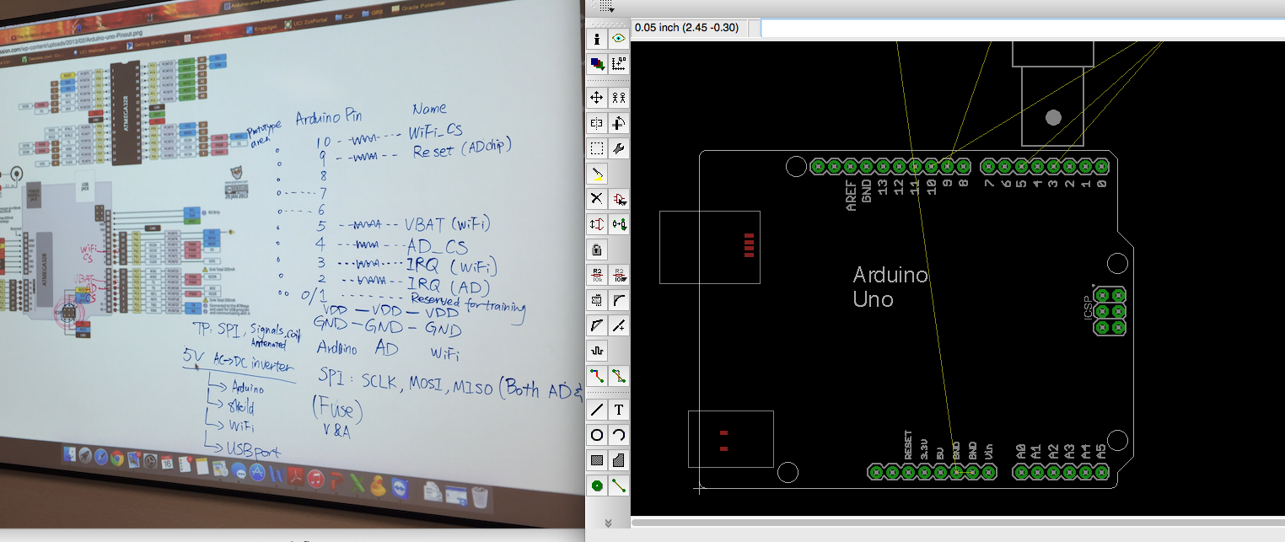
documents/team meeting and presentations/Screen Shot 2015-01-20 at 4.02.00 PM.png
