CalPlug/SparkyStrip/documents/pcb/BOM/BOM PO.xlsx

78M6613 PSU Board Schematics
Item | Qty | Reference | Part | Partnumber | Link | Footprint
1 | 10 | Capacitor | 1000pF | C1608X7R2A102K | http://www.digikey.com/product-detail/en/C1608X7R2A102K080AA/445-1298-1-ND/567689
2 | 10 | Capacitor | 0.1uF | C1608X7R1H104K | http://www.digikey.com/product-detail/en/C1608X7R1H104K080AA/445-1314-1-ND/567687
3 | 10 | Capacitor | 27pF | C1608C0G1H270J | http://www.digikey.com/product-detail/en/C1608C0G1H270J080AA/445-1274-1-ND/567675
4 | 10 | Capacitor | 4.7uF | C3216X7R1E475K | http://www.digikey.com/product-detail/en/C3216X7R1E475K160AC/445-1606-1-ND/634401
8 | 5 | Header | Header 4 | 26-60-504 | http://www.digikey.com/product-search/en?x=0&y=0&lang=en&site=us&keywords=26-60-5040
9 | 5 | Resistance | 750ohms | RG1608P-751-B-T5 | http://www.digikey.com/product-detail/en/RG1608P-751-B-T5/RG16P750BCT-ND/1241011
10 | 5 | Resistance | 1Mohms | RN732BTTD1004B25 | http://www.digikey.com/product-detail/en/ERA-6AEB105V/P1MDADKR-ND/1466217
11 | 50 | Resistance | 0Ohms | ERJ-3GEYJ000V | http://www.digikey.com/product-detail/en/ERJ-3GEY0R00V/P0.0GCT-ND/134711
12 | 50 | Resistance | 330ohms | ERJ-3GEYJ331V | http://www.digikey.com/product-detail/en/ERJ-3GEYJ331V/P330GCT-ND/134778
13 | 50 | Resistance | 10Kohms | ERJ-3GEYJ103V | http://www.digikey.com/product-detail/en/ERJ-3GEYJ103V/P10KGCT-ND/134717
14 | 3 | IC Chip | 78M6613-IM/F | 78M6613-IM/F | http://www.digikey.com/product-detail/en/78M6613-IM%2FF/78M6613-IM%2FF-ND/2447774
15 | 5 | Voltage Regulator | 3.3V, 100mA | MC78PC33NTRG | http://www.digikey.com/product-detail/en/MC78PC33NTRG/MC78PC33NTRGOSCT-ND/893879
16 | 5 | Crystal Oscillator | 32.768 KHZ SMD 12.5Pf | ABS25-32.768KHZ-T | http://www.digikey.com/product-detail/en/ABS25-32.768KHZ-T/535-9166-1-ND/675683
17 | 5 | Reset Circuit | MAX810 | MAX810SEUR+T | http://www.digikey.com/product-detail/en/MAX810SEUR%2BT/MAX810SEUR%2BTCT-ND/1173278
Shunt Adaptor Board Schematics
Item | Qty | Reference | Part | Partnumber | Link | Footprint
3 | 4 | TERMINAL SCREW VERTICAL | STANDOFF | MS 561-PS500A | http://fi.mouser.com/ProductDetail/Eagle-Plastic-Devices/561-PS500A/?qs=jyuMPHuZ7%252b1aehi0ma5/3Q==
4 | 10 | CON4 | CON4 | MS 534-8191 | http://www.digikey.com/product-detail/en/8191/8191K-ND/151565
6 | 1 | 2 inch 7 wires 22 AWG directly to board to female strip | 2 inch 7 wires 22 AWG directly to board to female strip
9 | 25 | CONN JUMPER | 2 PIN shorting block | S9001-ND | http://www.digikey.com/product-detail/en/SPC02SYAN/S9001-ND/76375
10 | 3 | USB Connectors | USB-B | PN61729 | http://www.mouser.com/ProductDetail/FCI/61729-1011BLF/
11 | 5 | Resistance | 0.004 1% 2.5W | MS 66-ULR25R004FLFTR | http://www.digikey.com/product-detail/en/CSR2512B0R004F/696-1181-1-ND/2813312
14 | 3 | Digital Isolators | ADUM3201 | ADUM3201ARZ-ND | http://www.digikey.com/product-detail/en/ADUM3201ARZ-RL7/ADUM3201ARZ-RL7CT-ND/3903353
15 | 3 | USB Interface IC USB to Serial UART | FT232QFN32 | MS 895-FT232RQ | http://www.digikey.com/product-detail/en/FT232RQ-REEL/768-1008-1-ND/1836403
16 | 3 | CONVERTER DC/DC | VBT1-5V | 102-1397-2-ND | http://www.digikey.com/product-detail/en/VBT1-S5-S5-SMT-TR/102-1397-1-ND/989923
 | 5 | QFN32 to DIP | extender board | 204-0017-01 | http://www.mouser.com/ProductDetail/SchmartBoard/204-0017-01/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 | N/A | digikey has similar parts for $16 ea
