CalPlug/SparkyStrip/documents/pcb/BOM/BOM.xlsx

78M6613 PSU Board Schematics
Item | Qty | Reference | Part | Partnumber | Link | Footprint
1 | 2 | Capacitor | 1000pF | C1608X7R2A102K | http://www.digikey.com/product-detail/en/C1608X7R2A102K080AA/445-1298-1-ND/567689
2 | 5 | Capacitor | 0.1uF | C1608X7R1H104K | http://www.digikey.com/product-detail/en/C1608X7R1H104K080AA/445-1314-1-ND/567687
3 | 2 | Capacitor | 27pF | C1608C0G1H270J | http://www.digikey.com/product-detail/en/C1608C0G1H270J080AA/445-1274-1-ND/567675
4 | 2 | Capacitor | 4.7uF | C3216X7R1E475K | http://www.digikey.com/product-detail/en/C3216X7R1E475K160AC/445-1606-1-ND/634401
5 | 1 | Header | Header 4 | PBC36SAAN | http://www.digikey.com/product-detail/en/PBC36SAAN/S1011E-36-ND/859621
6 | 1 | Header | Header 6 | PBC36SAAN | http://www.digikey.com/product-detail/en/PBC36SAAN/S1011E-36-ND/859621
7 | 1 | Header | Header 6 | PBC36SAAN | http://www.digikey.com/product-detail/en/PBC36SAAN/S1011E-36-ND/859621
8 | 1 | Header | Header 4 | 26-60-504 | http://fi.mouser.com/ProductDetail/Molex/26-60-5040/?qs=GEJyObWCoZhd5nmWUAG6pA==
9 | 2 | Resistance | 750ohms | RG1608P-751-B-T5 | http://www.digikey.com/product-detail/en/RG1608P-751-B-T5/RG16P750BCT-ND/1241011
10 | 2 | Resistance | 1Mohms | RN732BTTD1004B25 | http://fi.mouser.com/ProductDetail/KOA-Speer/RN732BTTD1004B25/?qs=b4vKS93X7SxQ4I2Pg2MEKA==
11 | 1 | Resistance | 0Ohms | ERJ-3GEYJ000V | http://www.digikey.com/product-detail/en/ERJ-3GEY0R00V/P0.0GCT-ND/134711
12 | 1 | Resistance | 330ohms | ERJ-3GEYJ331V | http://www.digikey.com/product-detail/en/ERJ-3GEYJ331V/P330GCT-ND/134778
13 | 2 | Resistance | 10Kohms | ERJ-3GEYJ103V | http://www.digikey.com/product-detail/en/ERJ-3GEYJ103V/P10KGCT-ND/134717
14 | 1 | IC Chip | 78M6613-IM/F | 78M6613-IM/F | http://www.digikey.com/product-detail/en/78M6613-IM%2FF/78M6613-IM%2FF-ND/2447774
15 | 1 | Voltage Regulator | 3.3V, 100mA | MC78PC33NTRG | http://www.digikey.com/product-detail/en/MC78PC33NTRG/MC78PC33NTRGOSCT-ND/893879
16 | 1 | Crystal Oscillator | 32.768 KHZ SMD 12.5Pf | ABS25-32.768KHZ-T | http://www.digikey.com/product-detail/en/ABS25-32.768KHZ-T/535-9166-1-ND/675683
17 | 1 | Reset Circuit | MAX810 | MAX810SEUR+T | http://www.digikey.com/product-detail/en/MAX810SEUR%2BT/MAX810SEUR%2BTCT-ND/1173278
Shunt Adaptor Board Schematics
Item | Qty | Reference | Part | Partnumber | Link | Footprint
1 | 3 | Capacitor | 0.1uF | 399-5089-1-ND | http://www.digikey.com/product-detail/en/C0603C104K5RACTU/399-5089-1-ND/1465623
2 | 3 | Capacitor | 4.7uF | 478-2396-1-ND | http://www.digikey.com/product-detail/en/TPSB475K016R1500/478-2396-2-ND/678475
3 | 4 | TERMINAL SCREW VERTICAL | STANDOFF | MS 561-PS500A | http://fi.mouser.com/ProductDetail/Eagle-Plastic-Devices/561-PS500A/?qs=jyuMPHuZ7%252b1aehi0ma5/3Q==
4 | 6 | CON4 | CON4 | MS 534-8191 | http://www.digikey.com/product-detail/en/8191/8191K-ND/151565
5 | 1 | CONN RECEPT | CON4 | MS 538-09-52-3043 | http://www.digikey.com/product-detail/en/09-52-3043/WM3501-ND/26605
6 | 1 | 2 inch 7 wires 22 AWG directly to board to female strip | 2 inch 7 wires 22 AWG directly to board to female strip
7 | 1 | CONN HEADER | DEBUG | S1011E-36-ND | http://www.digikey.com/product-detail/en/PBC36SAAN/S1011E-36-ND/859621
8 | 1 | CONN HEADER | CON2 | S1011E-36-ND | http://www.digikey.com/product-detail/en/PBC36SAAN/S1011E-36-ND/859621
9 | 1 | CONN JUMPER | 2 PIN shorting block | S9001-ND | http://www.digikey.com/product-detail/en/SPC02SYAN/S9001-ND/76375
10 | 1 | USB Connectors | USB-B | MS 154-2442-E | http://fi.mouser.com/ProductDetail/Kobiconn/154-2442-E/?qs=x6EjVpvqMVOC38Qcg8acAA==
11 | 1 | Resistance | 0.004 1% 2.5W | MS 66-ULR25R004FLFTR | http://fi.mouser.com/ProductDetail/IRC-TT-electronics/ULR25R004FLFTR/?qs=h26DkM9IupsAJM08zYyJsg==
12 | 2 | Resistance | 0 Ohms | P0.0GCT-ND | http://fi.mouser.com/ProductDetail/Panasonic/ERJ-3GEY0R00V/?qs=66DK8nO8gJALIOqOWgiVwg==
13 | 1 | Resistance | 10K | P10.0KHCT-ND | http://fi.mouser.com/ProductDetail/Panasonic/ERJ-3EKF1002V/?qs=H7k1u0Mp9JSrGPQ5/5COuw==
14 | 1 | Digital Isolators | ADUM3201 | ADUM3201ARZ-ND | http://fi.mouser.com/ProductDetail/Analog-Devices/ADUM3201ARZ/?qs=WIvQP4zGang4RwfBLce77g==
15 | 1 | USB Interface IC USB to Serial UART | FT232QFN32 | MS 895-FT232RQ | http://fi.mouser.com/ProductDetail/FTDI/FT232RQ-REEL/?qs=D1/PMqvA103VVcOzf7gfmQ==
16 | 1 | CONVERTER DC/DC | VBT1-5V | 102-1397-2-ND | http://www.digikey.com/product-detail/en/VBT1-S5-S5-SMT-TR/102-1397-1-ND/989923
