CalPlug/SparkyStrip/documents/pcb/BOM/BOM_updated.xlsx

Name | Value | Units | Unit Price | Total Price
Resistors
R53,R54 | 499 kΩ, 0.1%, ¼ W | 15 | 0.175 | 2.625 | ±5 ppm/°C Resistor, Good Tolerance. Vishay Dale Part No. CMF554993FT-1. |  |  |  |  |  |  |  |  |  |  | http://www.datasheetarchive.com/buy/CMF554993FT1.html
R56 |  |  |  | 0
R1,R15,R16,R17,R18,R19,R20,R21,R24,R25,R26,R27,R36 | 820 Ω, 5%, ¼ W | 50 | 0.0288 | 1.44 |  |  |  |  |  |  |  |  |  |  |  | http://www.digikey.com/product-detail/en/CF14JT820R/CF14JT820RCT-ND/1830348
R2,R7,R8,R9,R10,R39,R40 | 10 kΩ, 5%, ¼W | 50 | 0.028 | 1.4 |  |  |  |  |  |  |  |  |  |  |  | http://www.digikey.com/product-detail/en/CF14JT10K0/CF14JT10K0CT-ND/1830374
R50,R51,R57 | 1 kΩ, 0.1%, ¼ W ±5 | ? |  |  | ppm/°C Resistor, Good Tolerance, Used as Part of the Analog Filter Network. These resistors are not soldered but are plugged into the PCB pin sockets for easy modification by the customer. Low drift Vishay Dale Part No. CMF551001BT-2. |  |  |  |  | ? | ? | ? | ? | ? | ? | ? | ? | ? | ? | ? | ? | ? | ? | ?
R3,R5,R6,R13,R22,R30,R31,R33,R34,R37 | 100 Ω, 5%, ¼ W | 50 | 0.0288 | 1.44 |  |  |  |  |  |  |  |  |  |  |  | http://www.digikey.com/product-detail/en/CF14JT100R/CF14JT100RCT-ND/1830327
R12 | 10 Ω | 4 | 0.96 | 3.84 | 10R0 SMD Resistor |  |  |  |  |  |  |  |  |  |  | ? | ? | ? | ? | ? | ? | ? | ? | ?
R4 | 0 Ω, 10%, ¼ W | 5 | 0.1 | 0.5 |  |  |  |  |  |  |  |  |  |  |  | http://www.digikey.com/product-detail/en/1623934-1/A105988CT-ND/3477589
R41,R42 | 100 Ω, 0.1%, ¼ W |  |  | 0 | ±5 ppm/°C Resistor, Good Tolerance. Low drift Vishay Dale Part No. CMF551000BT-2. |  |  |  |  |  | ? | ? | ? | ? | ? | ? | ? | ? | ? | ? | ? | ? | ? | ?
Capacitors
C11,C21,C50,C51 | 33 nF, 10%, 50 V | 10 | 2.78 | 27.8 |  |  |  |  |  |  |  |  |  |  |  | http://www.digikey.com/product-detail/en/K333K15X7RF5TL2/BC1081CT-ND/286703
C26 | 10 uF | 4 | 2.43 | 9.72 | Polarized Cap |  |  |  |  |  |  |  |  |  |  | http://www.digikey.com/product-detail/en/RCER71H106MWM1H03A/490-7518-1-ND/4277435
C5,C7,C24,C28,C30 | 10 µF, 10 V | 10 | 0.325 | 3.25 | dc Power Supply Decoupling Capacitors, 20%, AVX-Kyocera, Farnell Part No. 643-579 |  |  |  |  |  |  |  |  |  |  | http://www.digikey.com/product-detail/en/FK14X5R1A106M/445-8287-ND/2815217
C53,C54 | 33 nF, 10%, 50 V | 10 | 2.78 |  | X7R Capacitor, Part of the Filter Network. These resistors are not soldered but are plugged into the PCB mount sockets for easy modification by the customer. |  |  |  |  | The SR15 series AVX-Kyocera, Farnell Part No. 108-948. |  |  |  |  |  | http://www.digikey.com/product-detail/en/K333K15X7RF5TL2/BC1081CT-ND/286703
C8,C23,C27,C29,C31,C32,C33,C34,C35,C36,C25,C6 | 100 nF, 50 V | 20 | 0.246 | 4.92 | Power Supply Decoupling Capacitors, 10%, X7R type, AVX-Kyocera, Farnell Part No. 108-950. |  |  |  |  |  |  |  |  |  |  | http://www.digikey.com/product-detail/en/K104K10X7RF5UH5/BC2665CT-ND/2356879
C14,C15 | 22 pF, | 10 | 0.283 | 2.83 | Ceramic Gate Oscillator Load Capacitors, Farnell Part No. 108-927 |  |  |  |  |  |  |  |  |  |  | http://www.digikey.com/product-detail/en/K220J15C0GH5TL2/BC1055CT-ND/286677
C16 | 220 pF | 10 | 0.62 | 6.2 | AVX-Kyocera, Farnell Part No. 108-946. |  |  |  |  |  |  |  |  |  |  | http://www.digikey.com/product-detail/en/SR211A221JARTR1/478-7323-1-ND/3660601
Connectors
CONN HDR VERT 3POS .100 TIN | 3 pos | 100 | 0.1958 | 19.58 |  |  |  |  |  |  |  |  |  |  |  | http://www.digikey.com/product-detail/en/0705430037/WM4825-ND/313740
CONN CIC FFC RCPT 3POS 2.54MM | 3 pos RCPT | 100 | 0.1027 | 10.27 |  |  |  |  |  |  |  |  |  |  |  | http://www.digikey.com/product-detail/en/0010112033/WM2602-ND/171979
CONN HOUS 2POS .100 W/RAMP/RIB | 2 pos RCPT | 100 | 0.074 | 7.4 |  |  |  |  |  |  |  |  |  |  |  | http://www.digikey.com/product-detail/en/0022013027/WM2000-ND/26431
CONN HEADER 2POS .100 VERT TIN | 2 pos | 100 | 0.1284 | 12.84 |  |  |  |  |  |  |  |  |  |  |  | http://www.digikey.com/product-search/en?KeyWords=Molex%20Inc%200022232021
SOCKET 4.2 MM SOLDER TAIL SINGLE 0.100" pitch | 9 pos RCPT | 10 | 0.59 | 5.9 | Female on PCB for Wifi daughter board |  |  |  |  |  |  |  |  |  |  | http://www.digikey.com/product-detail/en/310-87-109-41-001101/1212-1098-ND/3757348
PIN 4 MM SOLDER TAIL SINGLE 0.100" pitch | 10 pos | 10 | 1 | 10 | Male pins on for Wifi daughter board |  |  |  |  |  |  |  |  |  |  | http://www.digikey.com/product-search/en?mpart=350-80-110-00-001101&vendor=1212
CONN FEMALE 24-30AWG TIN | 1pos | 250 | 0.10616 | 26.54 |  |  |  |  |  |  |  |  |  |  |  | http://www.digikey.com/product-detail/en/0050291900/WM5269CT-ND/2713568
IC
U1 | ADE7763ARSZ | 5 | 4.28 | 21.4 |  |  |  |  |  |  |  |  |  |  |  | http://www.digikey.com/product-detail/en/ADE7763ARSZ/ADE7763ARSZ-ND/997433
U2 | 74HC08 |  |  | 0 | Quad CMOS AND Gates | ? | ? | ? | ?
U9 | HCPL2232 | 2 | 10.35 | 20.7 | HP Optical Isolator, Newark Part No. 06F5434 |  |  |  |  |  |  |  |  |  |  | http://www.digikey.com/product-detail/en/HCPL-2232-000E/516-1473-5-ND/669900
U4 | AD780 | 5 | 10 | 50 | 2.5 V Reference, Supplied by Analog Devices, Inc. |  |  |  |  |  |  |  |  |  |  | http://www.digikey.com/product-detail/en/AD780ARZ-REEL7/AD780ARZ-REEL7CT-ND/1127286
MISC
LED 1-4 |  | 50 | 0.19 | 9.5 | LED Low Current, Red, Farnell Part No. 637-087. |  |  |  |  |  |  |  |  |  |  | http://www.digikey.com/product-detail/en/C5SMF-RJS-CT0W0BB2/C5SMF-RJS-CT0W0BB2CT-ND/1987481
Wifi Daughter Board | CC3000 WiFi Breakout with Onboard Antenna | 3 | 34.95 | 104.85 |  |  |  |  |  |  |  |  |  |  |  | http://www.adafruit.com/products/1469
XTAL | 3.579545 MHz | 10 | 0.81 | 8.1 | Quartz Crystal, HC-49 (US), ECS Part No. ECS-35-17-4. |  |  |  | Digi-Key Part No. X079-ND. |  |  |  |  |  |  | http://www.digikey.com/product-detail/en/ECS-35-17-4/X079-ND/27508
TEST POINT PC MINI .040"D WHITE | TP WTE | 10 | 0.315 | 3.15 | 0.040" (1.02mm) Hole Diameter |  |  |  |  |  |  |  |  |  |  | http://www.digikey.com/product-detail/en/5002/5002K-ND/255328
TEST POINT PC MINI .040"D BLACK | TP BLK | 10 | 0.315 | 3.15 | 0.040" (1.02mm) Hole Diameter |  |  |  |  |  |  |  |  |  |  | http://www.digikey.com/product-detail/en/5001/5001K-ND/255327
KNIFE SET WITH BLADE 16PC | X-acto knife set | 1 | 19.97 | 19.97 | Includes Blades, Handles, Plastic Tray |  |  |  |  |  |  |  |  |  |  | http://www.digikey.com/product-detail/en/44101/243-1010-ND/247861
Micro USB to USB Cable | 2-Pack - 3 Feet | 2 | 7.99 | 15.98 |  |  |  |  |  |  |  |  |  |  |  | http://www.amazon.com/AmazonBasics-USB-Cable-Micro-Meters/dp/B003ES5ZSW
USB Wall adapter 2.1A | 2.1 A wall adapter | 4 | 7.99 | 31.96 |  |  |  |  |  |  |  |  |  |  |  | http://www.amazon.com/AmazonBasics-Wall-Charger-Outlet-Output/dp/B005CG2ATQ
HEATSHRINK 1/16 IN X 4FT BLACK | 4FT | 5 | 1.044 | 5.22 |  |  |  |  |  |  |  |  |  |  |  | http://www.digikey.com/product-detail/en/F221B1%2F16%20BK100/A116B-4-ND/281667
HEATSHRINK 3/32 IN X 4FT BLACK | 4FT | 5 | 1.106 | 5.53 |  |  |  |  |  |  |  |  |  |  |  | http://www.digikey.com/product-detail/en/F221B3%2F32%20BK100/A332B-4-ND/281669
SHUNT JUMPER .1" BLACK GOLD | 2pos | 50 | 0.06 | 3 |  |  |  |  |  |  |  |  |  |  |  | http://www.digikey.com/product-detail/en/969102-0000-DA/3M9580-ND/2071621
HOOK-UP SOLID 24AWG BLACK 5' | 5FT | 5 | 0.26 | 1.3 |  |  |  |  |  |  |  |  |  |  |  | http://www.digikey.com/product-detail/en/C2003A.12.01/C2003B-5-ND/4455017
HOOK-UP SOLID 24AWG WHITE 5' | 5FT | 5 | 0.26 | 1.3 |  |  |  |  |  |  |  |  |  |  |  | http://www.digikey.com/product-detail/en/C2003A.12.02/C2003W-5-ND/4455018
HOOK-UP SOLID 24AWG RED 5' | 5FT | 5 | 0.26 | 1.3 |  |  |  |  |  |  |  |  |  |  |  | http://www.digikey.com/product-detail/en/C2003A.12.03/C2003R-5-ND/4455016
HOOK-UP SOLID 24AWG YELLOW 5' | 5FT | 5 | 0.26 | 1.3 |  |  |  |  |  |  |  |  |  |  |  | http://www.digikey.com/product-detail/en/C2003A.12.05/C2003Y-5-ND/4840135
fuse holder |  |  |  |  |  |  |  |  |  |  |  |  |  |  |  | http://www.digikey.com/product-detail/en/56200001009/WK0009-ND/184873
fuse |  |  |  |  |  |  |  |  |  |  |  |  |  |  |  | http://www.digikey.com/product-detail/en/37312000410/WK3057BK-ND/103812
 |  |  | Total: | 452.475
