CalPlug/SparkyStrip/(list of files, cad)

Other CAD files:
documents/senior design/ems/load_sig/displays/display1/data/Demo_Algorithm.obj
documents/senior design/ems/load_sig/displays/Display2/data/algorythm_with_channels.obj
documents/senior design/load_sig/algorithm/version1/Display/data/algorythm_with_channels.obj
documents/senior design/ems/load_sig/displays/display1/data/algorythm_with_channels.obj
documents/senior design/ems/load_sig/displays/Display2/data/Demo_Algorithm.obj
documents/senior design/ems/load_sig/algorithm/version1/algorythm_with_channels.obj
documents/senior design/ems/load_sig/algorithm/version1/Display/data/algorythm_with_channels.obj
