CalPlug/SparkyStrip/documents/pcb/CAD files/Load_Sig_Sch.pdf

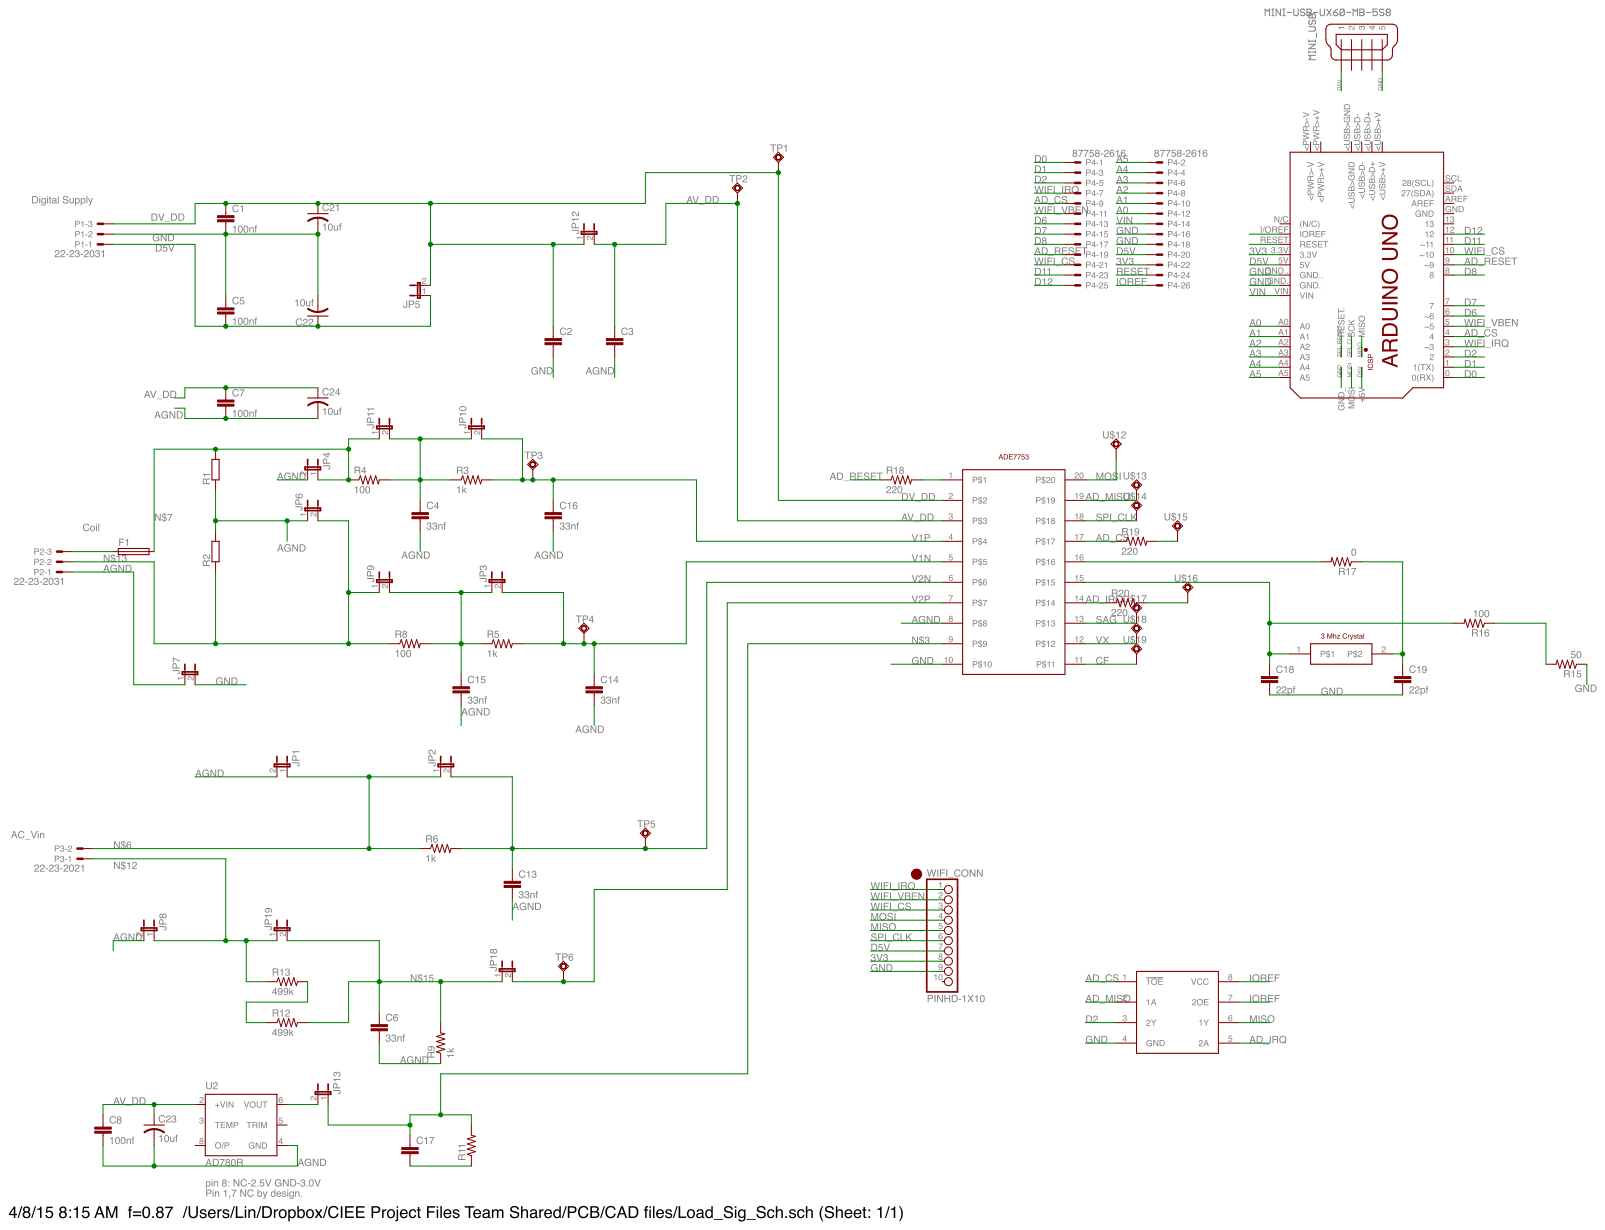
[picture p197: page 1]
