CalPlug/SparkyStrip/documents/pcb/CAD files/Load_Sig_Sch.brd

## EAGLE design documents/pcb/CAD files/Load_Sig_Sch.brd (2017-11-07)

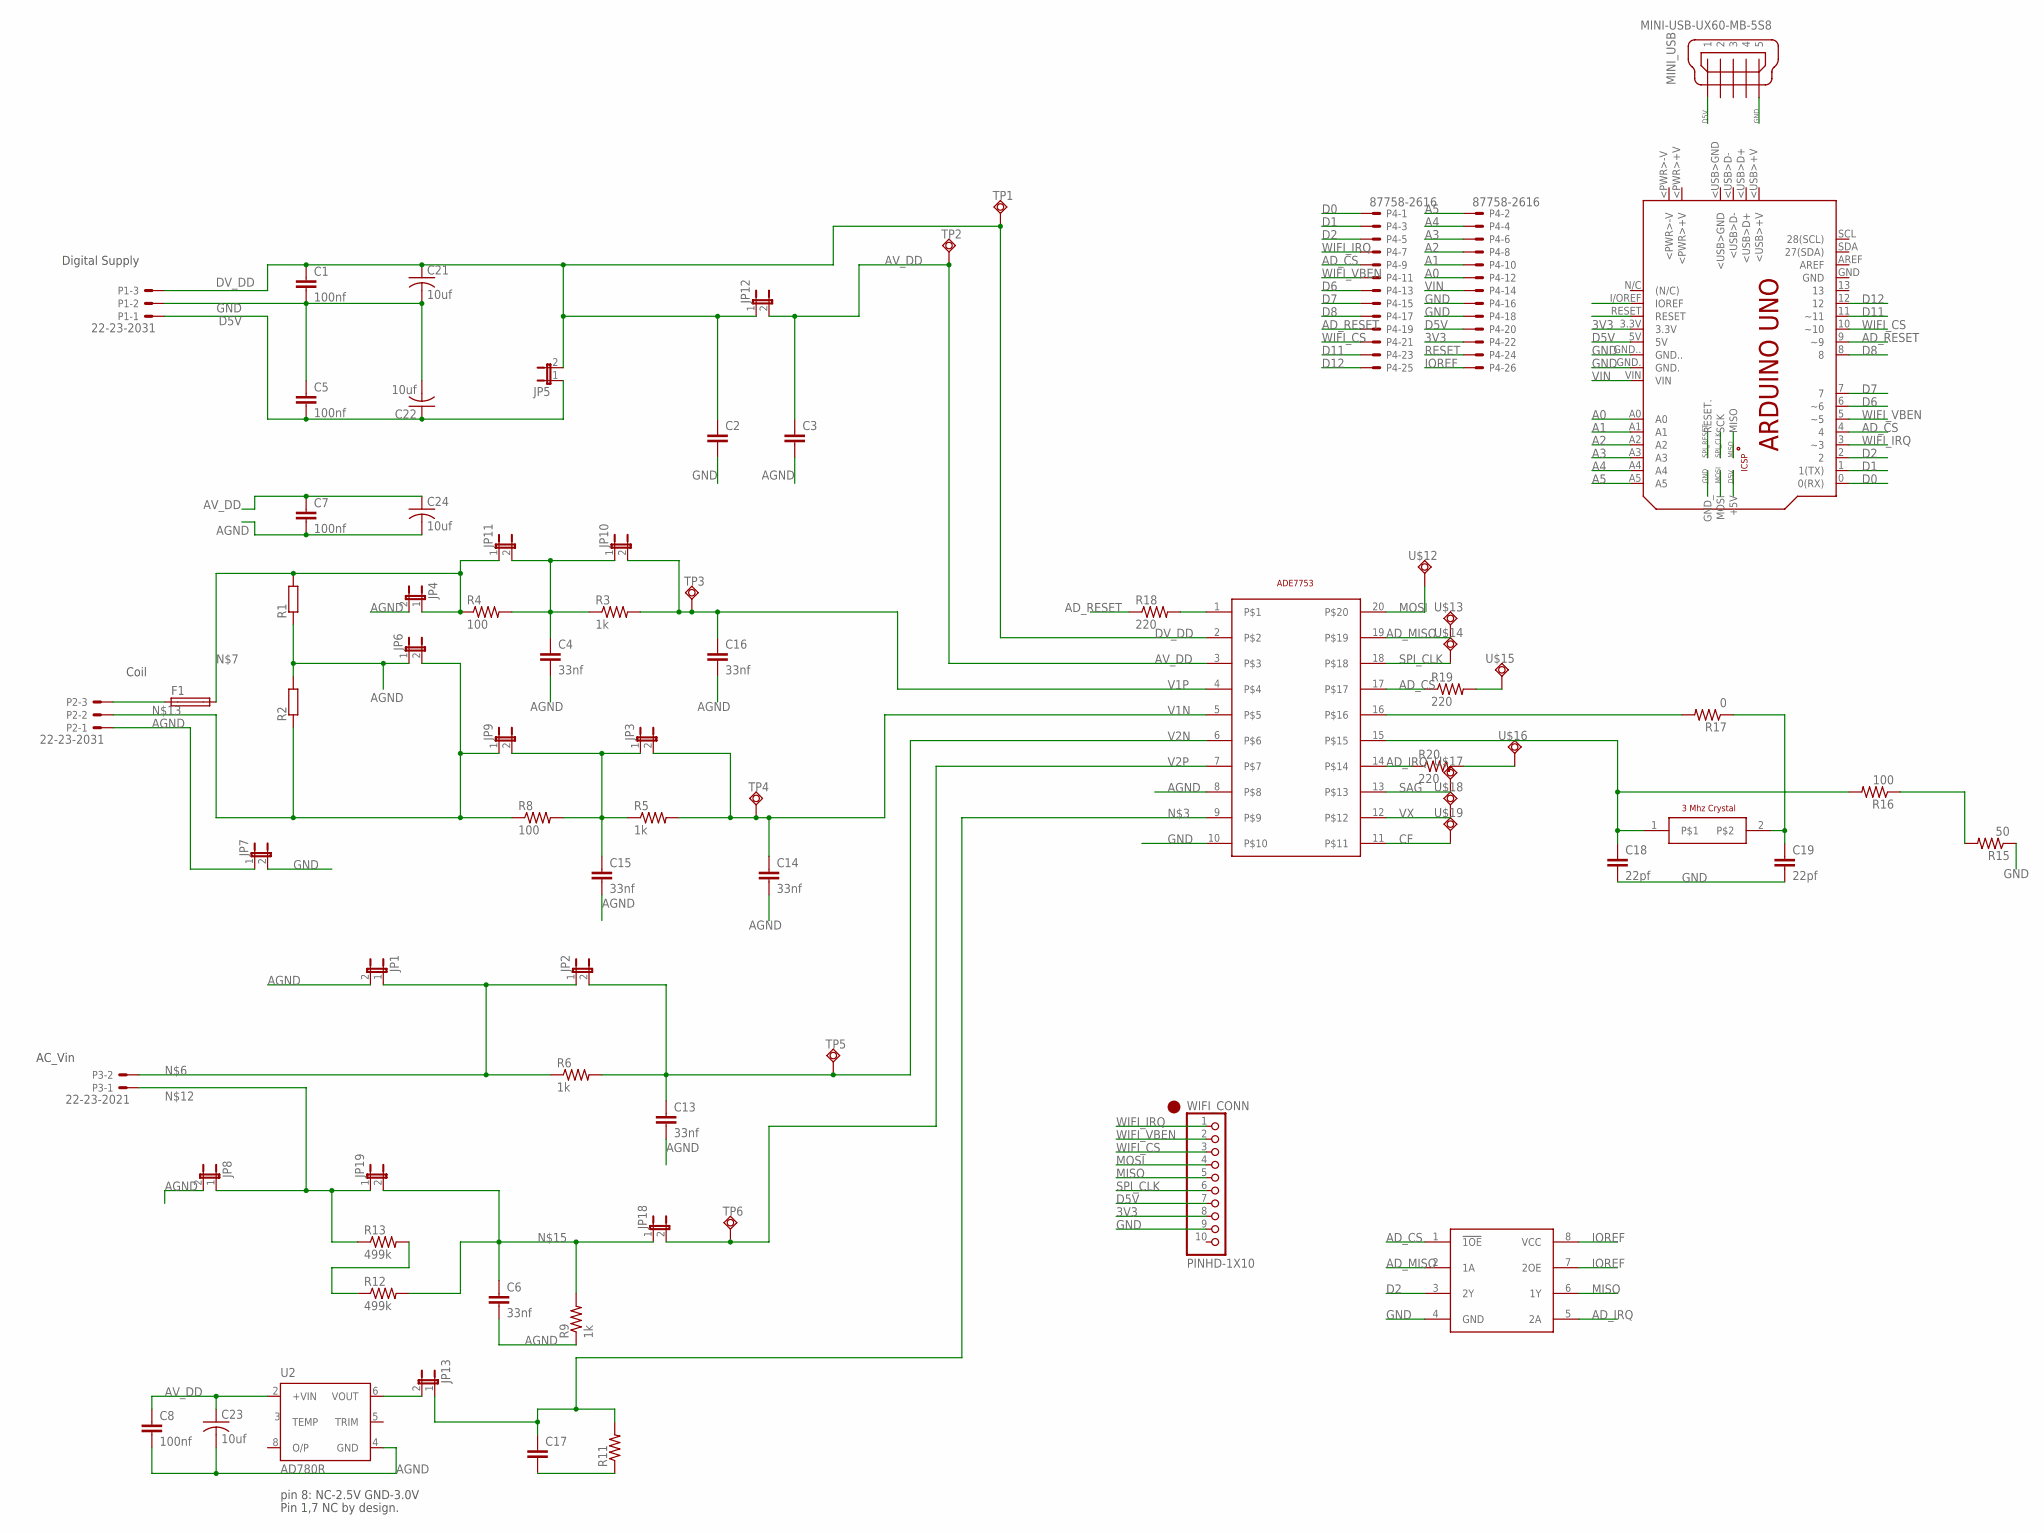
[picture p198: schematic Load_Sig_Sch.sch]

Parts:
C1, C5, C7, C8: 100nf; C025-024X044
C2, C3, C17: C-EU025-024X044; C025-024X044
C4, C6, C13, C14, C15, C16: 33nf; C025-024X044
C18, C19: 22pf; C025-024X044
C21, C22, C23, C24: 10uf; C025-024X044
F1: 19560
JP1, JP2, JP3, JP4, JP5, JP6, JP7, JP8, JP9, JP10, JP11, JP12, JP13, JP18, JP19: JP1E; JP1
MINI_USB: MINI-USB-UX60-MB-5S8; UX60-MB-5S8
P1, P2: 22-23-2031
P3: 22-23-2021
P4: 87758-2616
PCB1: ARDUINO_UNO
R1, R2: BVS
R3, R5, R6, R9: 1k; 0204V
R4, R8, R16: 100; 0204V
R11: R-US_0204/2V; 0204V
R12, R13: 499k; 0204V
R15: 50; 0204V
R17: 0; 0204V
R18, R19, R20: 220; 0603-RES
TP1, TP2, TP3, TP4, TP5, TP6: TEST
U1: ADE7753; SSOP20
U2: AD780R; SO8
U3: 74LVC2G241; SOP65P490X110-8N
U$2: X079-ND_CRYSTAL; HC49US
U$12, U$13, U$14, U$15, U$16, U$17, U$18, U$19: TEST
WIFI_CONN: PINHD-1X10; 1X10-BIG

Connections:
3V3: P4.22, PCB1.3.3V, WIFI_CONN.8
A0: P4.12, PCB1.A0
A1: P4.10, PCB1.A1
A2: P4.8, PCB1.A2
A3: P4.6, PCB1.A3
A4: P4.4, PCB1.A4
A5: P4.2, PCB1.A5
AD_CS: P4.9, PCB1.4, R19.1, U1.17, U3.1 (!1OE)
AD_IRQ: R20.1, U1.14, U3.5 (2A)
AD_MISO: U1.19, U3.2 (1A), U$13.1
AD_RESET: P4.19, PCB1.9 (~9), R18.1
AGND: C3.2, C4.2, C6.2, C7.2, C8.2, C13.2, C14.2, C15.2, C16.2, C23.2, C24.2, JP1.2, JP4.2, JP6.1, JP7.1, JP8.2, P2.1, R1.2, R2.1, R9.1, U1.8, U2.4 (GND)
AV_DD: C3.1, C7.1, C8.1, C23.1, C24.1, JP12.2, TP2.1, U1.3, U2.2 (+VIN)
CF: U1.11, U$19.1
D0: P4.1, PCB1.0 (0(RX))
D1: P4.3, PCB1.1 (1(TX))
D2: P4.5, PCB1.2, U3.3 (2Y)
D5V: C5.2, C22.1, JP5.1, MINI_USB.1, P1.1, P4.20, PCB1.5V, PCB1.+5V, WIFI_CONN.7
D6: P4.13, PCB1.6 (~6)
D7: P4.15, PCB1.7
D8: P4.17, PCB1.8
D11: P4.23, PCB1.11 (~11)
D12: P4.25, PCB1.12
DV_DD: C1.1, C2.1, C21.1, JP5.2, JP12.1, P1.3, TP1.1, U1.2
GND: C1.2, C2.2, C5.1, C18.2, C19.2, C21.2, C22.2, JP7.2, MINI_USB.5, P1.2, P4.16, P4.18, PCB1.GND., PCB1.GND.., PCB1.GND_, R15.1, U1.10, U3.4 (GND), WIFI_CONN.9
IOREF: P4.26, PCB1.I/OREF (IOREF), U3.7 (2OE), U3.8 (VCC)
MISO: PCB1.MISO, U3.6 (1Y), WIFI_CONN.5
MOSI: PCB1.MOSI, U1.20, U$12.1, WIFI_CONN.4
unnamed: F1.1, P2.3
unnamed: C17.1, JP13.1, R11.2, U1.9
unnamed: C18.1, R16.2, U1.15, U$2.1
unnamed: C19.1, R17.1, U$2.2
unnamed: JP1.1, JP2.1, P3.2, R6.1
unnamed: F1.2, JP4.1, JP11.1, R1.1, R4.1
unnamed: C4.1, JP10.1, JP11.2, R3.1, R4.2
unnamed: R15.2, R16.1
unnamed: C15.1, JP3.1, JP9.2, R5.1, R8.2
unnamed: JP8.1, JP19.1, P3.1, R13.1
unnamed: JP6.2, JP9.1, P2.2, R2.2, R8.1
unnamed: R17.2, U1.16
unnamed: C6.1, JP18.1, JP19.2, R9.2, R12.2
unnamed: R12.1, R13.2
unnamed: JP13.2, U2.6 (VOUT)
unnamed: C17.2, R11.1
unnamed: R19.2, U$15.1
unnamed: R20.2, U$16.1
RESET: P4.24, PCB1.RESET
RESETBIN: R18.2, U1.1
SAG: U1.13, U$17.1
SPI_CLK: PCB1.SCK, U1.18, U$14.1, WIFI_CONN.6
SPI_RESET: PCB1.RESET.
V1N: C14.1, JP3.2, R5.2, TP4.1, U1.5
V1P: C16.1, JP10.2, R3.2, TP3.1, U1.4
V2N: C13.1, JP2.2, R6.2, TP5.1, U1.6
V2P: JP18.2, TP6.1, U1.7
VIN: P4.14, PCB1.VIN
VX: U1.12, U$18.1
WIFI_CS: P4.21, PCB1.10 (~10), WIFI_CONN.3
WIFI_IRQ: P4.7, PCB1.3 (~3), WIFI_CONN.1
WIFI_VBEN: P4.11, PCB1.5 (~5), WIFI_CONN.2

Notes on the sheet:
Coil
Digital Supply
AC_Vin
pin 8: NC-2.5V GND-3.0V
Pin 1,7 NC by design.

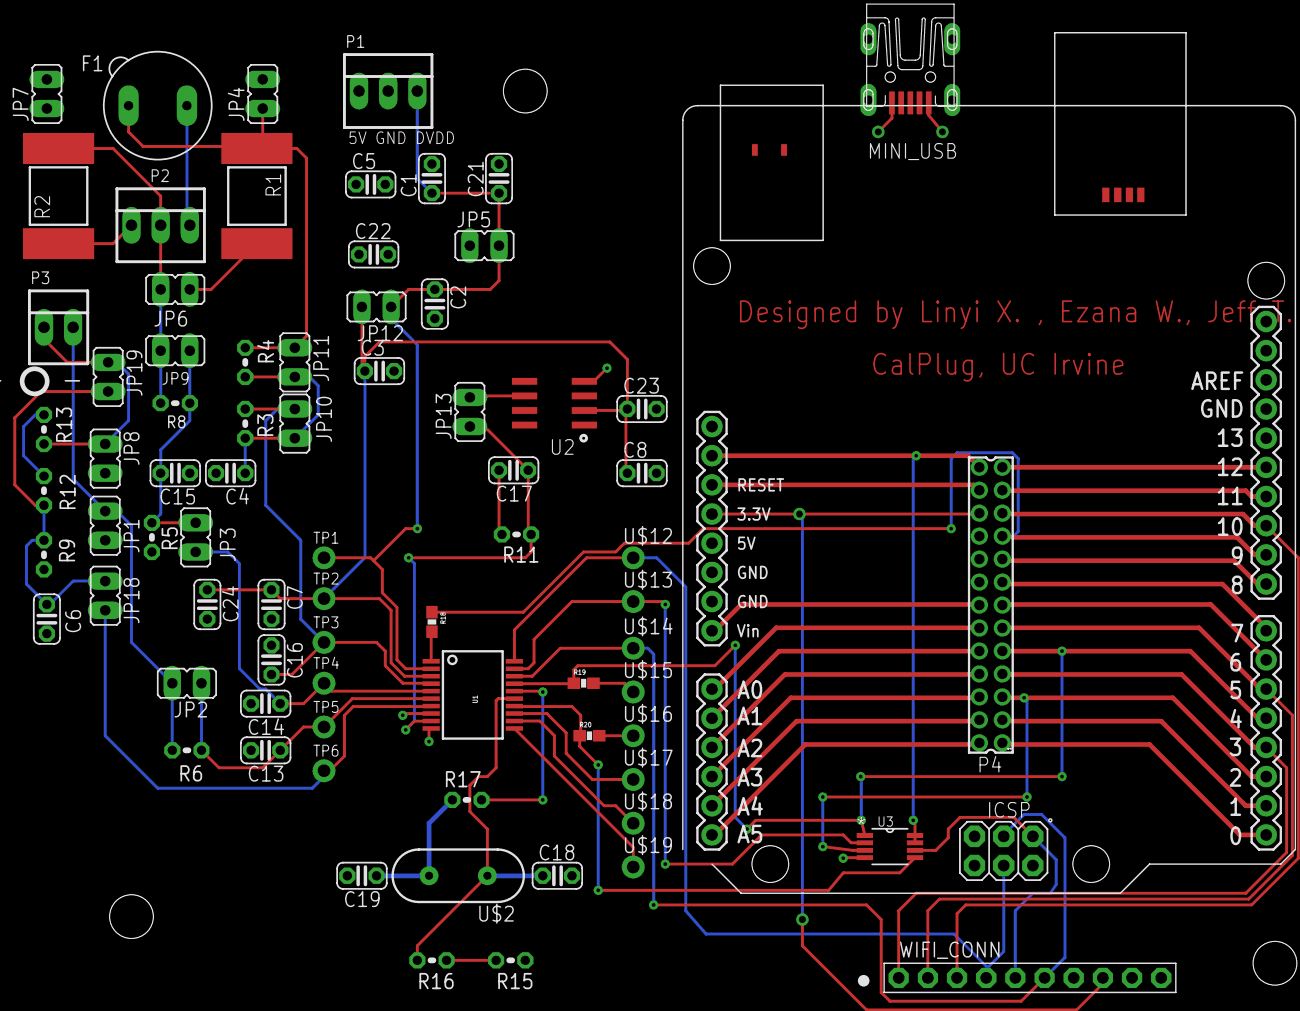
[picture p199: board Load_Sig_Sch.brd from above]

Board: 4 copper layers, 77 parts (0 on the bottom side), 59 nets.
