CalPlug/SparkyStrip/documents/Arduino/AD_REV2/process_data.h

#ifndef PROCESS_DATA_H
#define PROCESS_DATA_H

bool process(long* data, int* segment_starts, Goerzel_result& gr60, Goerzel_result& gr180, Goerzel_result& gr300, Goerzel_result& gr420)
{
    
    
    
}



#endif //PROCESS_DATA_H
